Rich5252/Arduino_ESP32_ssb_signal_generator/null_bias_investigation.md

# Two-tone null-crossing frequency bias — investigation notes

**Status: characterized, NOT fixed. Parked 2026-08-31** — picking up the TF
(transfer function) measurement system and group-delay re-tuning first. See
"Where to resume" at the bottom. **Late addition, same day: user reports the
current `I` (x4 envelope interpolation) algorithm makes two-tone stability
audibly worse, not just subtly worse — see item 5 under "Open, un-actioned
next steps" below. Treat that as higher priority than the null-bias fix
itself when this is picked back up.**

**UPDATE 2026-09-09 — important caveat on `weighted_bias`, discovered while
chasing an unrelated random-frequency-jump symptom (see
`moving_forward_notes.md`):** `weighted_bias` was assumed to be a fast,
stable, per-tone-pair constant (reset with `'r'`, read a second or two
later). Live-watching it continuously (a new firmware change exempts the
`null_bias*` lines from the diagnostics mute, so they stream at 1Hz
regardless of `'v'`) on 700/1700Hz showed instead that after an `'r'` reset
it keeps drifting for TENS OF SECONDS TO MINUTES — not settling quickly —
and can wander by 10-30Hz over that time even with the tone pair, presets,
and hardware completely unchanged (one capture went from -34Hz shortly
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
