Rich5252/Arduino_ESP32_ssb_signal_generator/Design data/group_delay_equalizer_fit.png

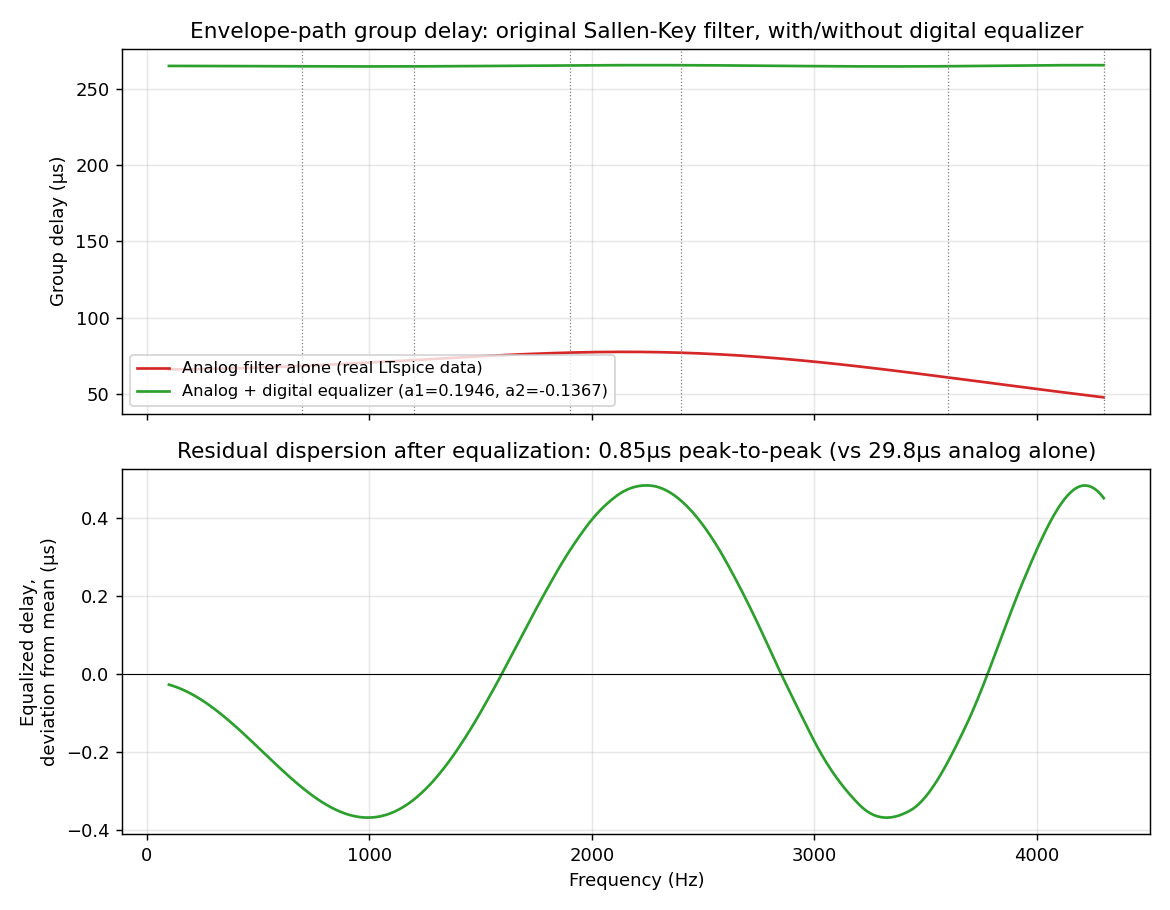
Design data/group_delay_equalizer_fit.png
