Rich5252/Arduino_ESP32_ssb_signal_generator/Design data/shelf2_level_dependence.png

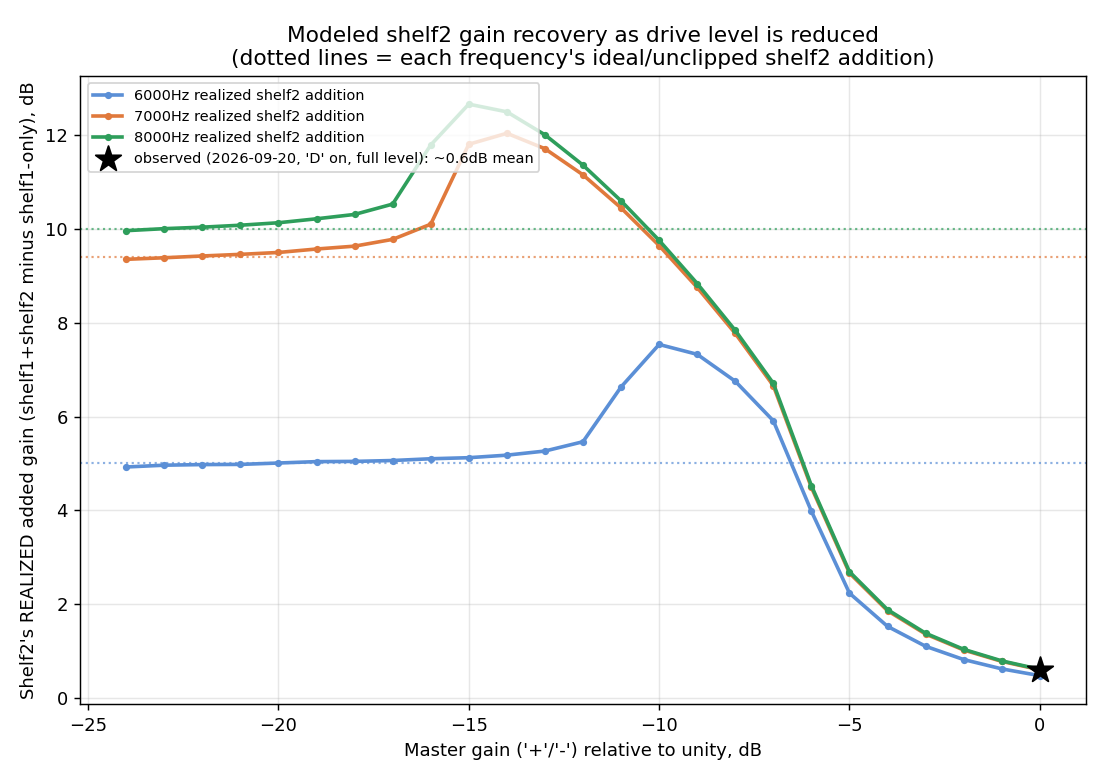
Design data/shelf2_level_dependence.png
