Rich5252/Arduino_ESP32_ssb_signal_generator/Design data/shelf_clipping_hypothesis.png

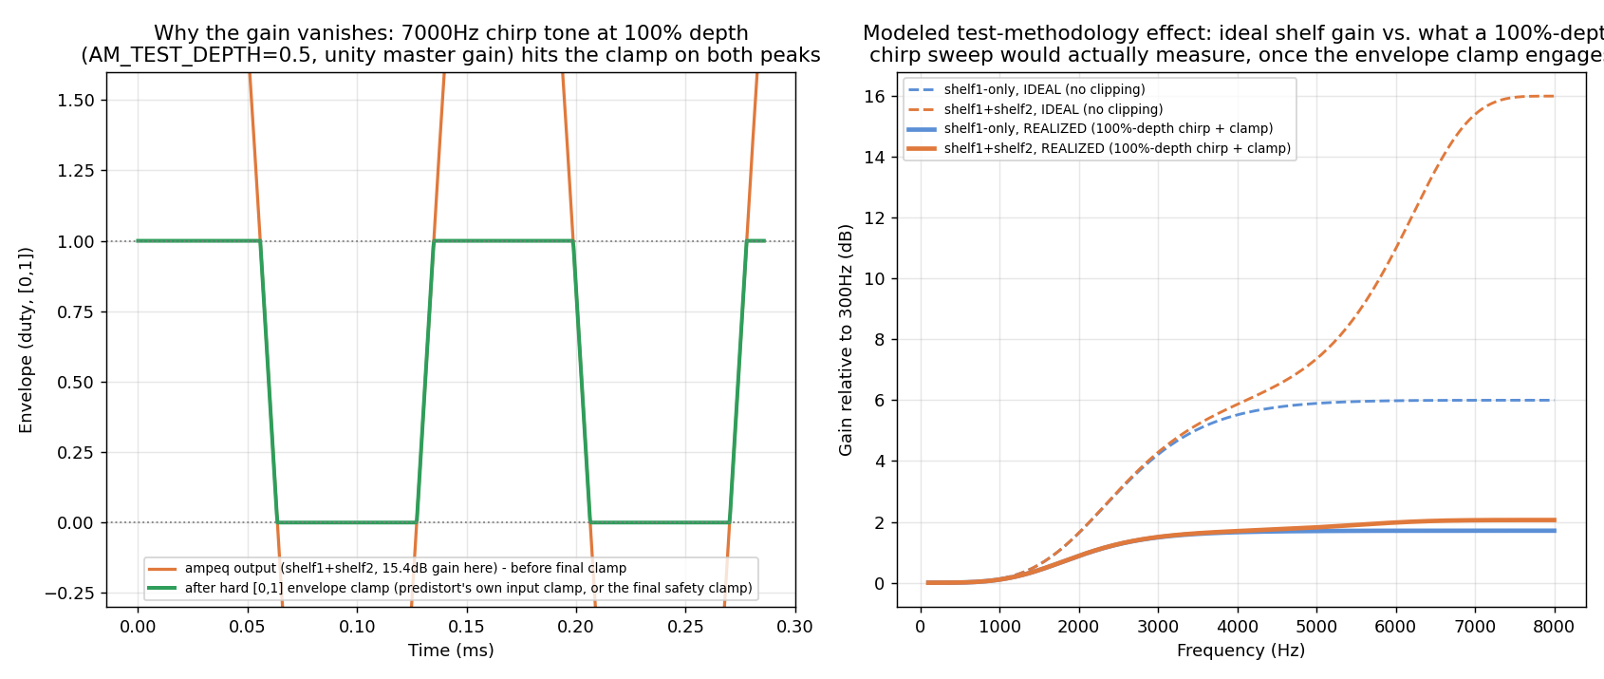
Design data/shelf_clipping_hypothesis.png
