Rich5252/Arduino_ESP32_ssb_signal_generator/Design data/ssb_mic_test_commands.md

# ssb_mic_test.ino — Serial Command Reference

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

## Signal source

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

### Sine-chirp test mode (`w`, `AUDIO_SRC_CHIRP`)

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

## Phase/envelope relative timing

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

## PWM duty-cycle range (envelope → RSET mapping)

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

## Envelope group-delay equalizer

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

## Envelope magnitude (insertion-loss) equalizer

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

## Is `eq`'s IMD benefit the highpass or the presence boost?

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

## Envelope pre-distortion

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

## Direct duty override

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

## Envelope-null floor

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

**Two earlier versions were tried and removed** — see `envelope_floor.cpp`'s header comment for both postmortems:

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

## freq_dev slew-rate limiter

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

## Envelope output interpolation

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

## Sample rate (Fs) and dsp_task timing margin

**2026-09-02: reverting `SAMPLE_RATE_HZ` from 16000 to 10000 produced a dramatic, across-the-board improvement — bigger than anything `g`/`I`/`D` have shown so far, and it looks like the real explanation behind most of this session's noisier-than-expected real-hardware results.** Using Preset 1 (two-tone, `env_gdeq_enable`/`envelope_interp_enable` both off) and a mid-band noise test (0-3kHz broadband content relative to a 750Hz mid-band reference): at 16000Hz, -22dBc, and `D` (`env_predistort_enable`) made it 0.3dB *worse*. At 10000Hz: -32dBc with `D` off (a 10dB improvement from Fs alone) and -38dBc with `D` on (`D` now worth a genuine +6dB, instead of being net-negative). Frequency stability and the tone's subjective quality were both reported as noticeably better at 10kHz too. The tradeoff is real and expected: PWM/ZOH imaging is worse at 10kHz (closer first image, less filter stopband margin) — the whole reason `SAMPLE_RATE_HZ` was raised to 16000 and `envelope_interp`'s x4 output interpolation was built in the first place.

Why this is very likely a genuine timing-margin story, not a coincidence: `config.h`'s own `SAMPLE_RATE_HZ` comment already has the numbers. At 10000Hz (100us period), measured per-tick work (adc+dsp+write) was ~45us, leaving ~55us of margin — comfortably above the "~12-20us of wakeup jitter already measured" noted in that same comment. At 16000Hz (62.5us period), that same ~45us of work leaves only ~17.5us of margin — barely above that *same* 12-20us jitter figure, i.e. close to the exact threshold that got 20000Hz rejected outright in that comment ("period drops to 50us, leaving too little margin"). 16000 was picked as "the next value up from 10000 that still divides evenly," not because its margin was independently re-validated as generous — and on this data it wasn't. A tick that occasionally misses that ~17.5us window delays the next AD9851 frequency-word update, which is real, direct FM/PM timing jitter on the signal itself — a mechanism that would show up exactly as elevated broadband noise and worse frequency stability, and wouldn't touch `D`'s effectiveness directly (a static envelope-to-duty LUT correction has nothing to do with tick timing) except by being swamped underneath it, which is exactly the pattern seen (`D`'s benefit reappears once the swamping noise is gone at 10kHz).

**2026-09-02, `[timing]` captures at both rates (Preset 1, TWO-TONE, `I`/`g` off, `'r'` reset first):** at 16000Hz, `max_busy_us=46 (adc=4 dsp=20 write=28) period_us=62 overruns=0`, `max_gap_us=75 (nominal=62) late_ticks_total=0`. At 10000Hz, `max_busy_us=42 (adc=5 dsp=16 write=24) period_us=100 overruns=0`, `max_gap_us=107 (nominal=100) late_ticks_total=0`. Neither shows a formal overrun or late tick, so the strong "dsp_task is missing its deadline" framing isn't directly confirmed — but the margin actually available is: 16us at 16kHz vs 58us at 10kHz (matching the config.h estimate almost exactly), and the worst observed wake-gap excess eats ~80% of that margin at 16kHz (13us of 16us) vs only ~12% at 10kHz (7us of 58us). 16kHz is running close to its own edge even when nothing formally trips the overrun counter; 10kHz has a large cushion. Also notable: `[dsp] freq_dev: max_unclamped` dropped from 6697Hz (16kHz) to 3697Hz (10kHz) — consistent with `diagnostics.cpp` computing instantaneous frequency as `dphi * SAMPLE_RATE_HZ / (2*pi)`, meaning any *fixed* amount of phase-domain noise (quantization, ADC noise, Hilbert/atan2 rounding) gets scaled up proportionally by Fs before it ever reaches the AD9851 — a second, smooth, deterministic mechanism independent of scheduling jitter, plausibly worth a few dB on its own via FM-sideband scaling (~20*log10(16000/10000) ≈ 4dB).

**2026-09-02, `ENVELOPE_INTERP_FACTOR=7` at `SAMPLE_RATE_HZ=10000` — retracted, wrong fix for the wrong reason.** The idea (see the now-superseded item 4 this replaces) was to decouple the heavy pipeline's rate from the PWM output rate: keep the full pipeline at 10kHz for margin, but raise the interp factor so the envelope's PWM write rate could still reach ~70kHz for imaging. On the bench this brought the noise straight back to the same poor level as plain 16kHz. That result on its own looked like it might mean *wake rate itself* (not the full pipeline's Fs) was the real culprit — but a cleaner, fully-controlled follow-up test at a *fixed* wake rate ruled that out too, and points somewhere much more specific and useful:

**2026-09-02, decisive: it's not wake rate, it's floating-point ramp computation on the interp tick.** All four readings below are at the *same* wake rate — `SAMPLE_RATE_HZ=10000`, `ENVELOPE_INTERP_FACTOR=4` (40kHz), Preset 1, `D` on, mid-band noise test (`Pwr mid 750Hz band`, higher/less-negative = worse):

| Curve | Result | Δ from baseline |
|---|---|---|
| `I` off (baseline) | -35.4dB | — |
| `I` on, HOLD (no float math, frozen value) | -33.4dB | +2.0dB |
| `I` on, LINEAR (one multiply-add, changing value) | -23.9dB | +11.5dB |
| `I` on, Catmull-Rom (cubic Hermite, changing value) | -21.2dB | +14.2dB |

LINEAR sits far closer to Catmull-Rom (2.7dB apart) than to HOLD (9.6dB apart), despite being the much simpler of the two real curves — a single multiply-add vs a full cubic Hermite evaluation. That rules out "more arithmetic = proportionally worse": if raw operation count were the driver, LINEAR should land roughly midway between HOLD and Catmull-Rom, not almost co-located with the expensive one. What actually separates HOLD from both real curves is binary, not a matter of degree: HOLD never touches the FPU and always (re)writes the exact same frozen duty value; LINEAR and Catmull-Rom both do real floating-point work and genuinely change the commanded duty on every interp tick. Whichever of those two properties is the trigger, it looks like a step function at that threshold, not a smooth cost curve.

**Correction, 2026-09-02 (same day): the `ENVELOPE_INTERP_FACTOR=7` result is a SEPARATE bug, not the same mechanism as the table above.** Re-tested with `I` fully OFF at factor=7 (10000Hz base) — still -21.174dB, essentially identical to the factor=4 Catmull-Rom result (-21.181dB) despite the interp tick being a guaranteed no-op with `I` off. That rules out float-ramp cost or a changing duty value as the cause at factor=7 specifically, since neither happens with `I` off. The real cause: `init_sample_timer()` sets `resolution_hz = 2000000UL * ENVELOPE_INTERP_FACTOR` — 8MHz at factor=4, 14MHz at factor=7 — while `alarm_count` stays a fixed `2000000UL / SAMPLE_RATE_HZ` (200), computed assuming the requested resolution is achieved exactly. `GPTIMER_CLK_SRC_DEFAULT` on this chip is the 80MHz APB clock (same assumption this project's own LEDC comment already makes elsewhere). 80MHz/8MHz=10 is a clean integer prescaler; 80MHz/14MHz≈5.714 is not, so the driver silently rounds to the nearest achievable resolution — almost certainly 80MHz/5=16MHz (a +14.3% error), not the requested 14MHz. Confirmed directly: `[dsp] long-window avg=11371.71 ticks/s (13.717% vs nominal 10000Hz) true_ratio=7.0914 (nominal=8)` — a real, hardware-timestamped measurement (via `esp_timer_get_time()`, independent of the gptimer's own assumptions) showing dsp_task's actual full-tick rate running ~13.7% fast, matching the predicted +14.3% resolution error closely enough (small residual plausibly the ADC's own independent +0.8% clock error, plus measurement-window noise) to call this confirmed. At factor=4, this same diagnostic line has consistently read ~0.000-0.008% off nominal — 8MHz's clean divisor avoids the problem entirely.

Consequence: at factor=7, *everything* downstream of `SAMPLE_RATE_HZ` — the Hilbert/atan2 phase-to-frequency conversion (`dphi * SAMPLE_RATE_HZ / 2*pi`), the AD9851 write cadence, the ADC decimation ratio (`ADC_SAMPLES_PER_TICK` assumes an exact 80000/10000=8 relationship, and the diagnostic's own `true_ratio=7.09 (nominal=8)` shows that assumption is now wrong too) — is being computed against a `SAMPLE_RATE_HZ` constant that no longer matches the tick rate actually being delivered. That's a severe, systematic mistuning of the whole pipeline, entirely independent of `I`/curve choice, which is exactly why it showed up "even with `I` off." This has nothing to do with the HOLD/LINEAR/Catmull-Rom finding above — that one was cleanly demonstrated entirely at factor=4, a clock-clean rate, so it remains a real, separate, still-open question.

Two consequences for next steps: **(1)** the previously-proposed "factor=7 + HOLD" isolating test (see below) is now moot as a clean test of the compute-cost question, since factor=7 itself is broken for an unrelated reason — any result there would be confounded by this clock error, not informative about float-ramp cost. **(2)** if a higher PWM update rate than 40kHz is still wanted at `SAMPLE_RATE_HZ=10000`, pick a factor that divides cleanly: `80,000,000 / (2,000,000 * factor)` needs to be an integer, i.e. `40 / factor` needs to be a whole number — factor ∈ {1, 2, 4, 5, 8, 10, 20, 40} are clean (7 wasn't one of them), so factor=5 (50kHz) or factor=8 (80kHz) would be genuinely clock-accurate choices worth trying instead, once/if the separate compute-cost question below is resolved in a way that makes a higher factor worth having. Also worth fixing at the code level regardless: `init_sample_timer()` should read back the gptimer driver's *actually achieved* resolution (ESP-IDF's `gptimer_new_timer()` reports this) and derive `alarm_count` from that instead of assuming the request was granted exactly — that would make any future `ENVELOPE_INTERP_FACTOR` choice safe by construction rather than silently wrong for the "unclean" ones.

Two candidate mechanisms remain for the still-open HOLD-vs-LINEAR/Catmull-Rom finding (factor=4, clock-clean, so unaffected by the above), not mutually exclusive, both consistent with a step-function-at-threshold pattern rather than a smooth compute-proportional one:
- **CPU/scheduling:** the ESP32-S3's FPU is a genuine coprocessor (this project already hit that wall once, in the v1/v2 `envelope_interp` failure history — see above). If the *first* FPU touch after a context switch carries a fixed save/restore cost, any float ramp (LINEAR or Catmull-Rom) would pay roughly the same large fixed penalty per call regardless of how many operations follow, while HOLD's FPU-free path never pays it at all — matching the data far better than a compute-proportional story would.
- **Analog/RF:** HOLD's duty value is electrically static across all 4 of its per-full-tick writes — indistinguishable from `I` off except for redundant identical LEDC writes. LINEAR/Catmull-Rom genuinely move the duty (real switching-edge position change) on every interp tick, which could carry inherently more RF-relevant switching energy regardless of CPU timing — a real, expected cost of genuine modulation rather than a bug, and independent of anything CPU-side. The GPIO2 scope check from the (retracted) HOLD investigation found the PWM line "clean" across all curves — but that check has not yet been repeated specifically under this two-tone/Preset 1 content with a properly *dynamic* envelope; a near-constant test signal would hide exactly this effect since LINEAR/Catmull-Rom's ramp would have little to interpolate either way.

Not yet done, in order of how cheap they are: (1) re-scope GPIO2 comparing HOLD vs LINEAR/Catmull-Rom under this exact two-tone/Preset 1 condition at factor=4 (clock-clean), to distinguish the CPU-side hypothesis (would show timing jitter on the PWM line) from the analog/RF-side one (would show a clean but genuinely more-modulated waveform); (2) a lightweight timing probe directly around `envelope_interp_on_interp_tick()`'s curve branches (max/avg execution time per call, broken out by curve), to quantify the CPU-side hypothesis directly instead of inferring it.

**2026-09-02, item (3) done — HOLD itself degrades with wake rate alone, even with zero float math (curve state assumed, pending confirmation).** Re-tested `SAMPLE_RATE_HZ=10000` with the two remaining clock-clean factors above 4, presumed still on HOLD (this was the specific next step proposed above; not explicitly re-stated in the terse result messages, so treat as provisional until confirmed):

| Factor | Wake rate | Result | Δ from `I` off baseline (-35.4dB) |
|---|---|---|---|
| 4 | 40kHz | -33.4dB (HOLD, confirmed) | +2.0dB |
| 5 | 50kHz | -29.929dB (HOLD, assumed) | +5.5dB |
| 8 | 80kHz | ~-23dB (HOLD, assumed) | +12.4dB |

If the curve assumption holds, this is a clean, roughly monotonic degradation with wake rate alone — 40k→50k→80k — on a payload that never touches the FPU and rewrites the same frozen duty value every interp tick. That's a real, independent cost of high wake rate by itself, additive on top of the separately-confirmed (and larger, at a fixed rate) float-ramp/changing-value cost from the table above. It also **weakens the CPU/FPU-coprocessor-context hypothesis**: that theory predicted HOLD's FPU-free path should be largely immune to wake-rate scaling, but here it isn't. The analog/RF hypothesis doesn't fit cleanly either, since HOLD's duty value is static — redundant identical writes, not genuine modulation — so a third, more generic mechanism looks more likely now: something that scales with *ISR/wake frequency itself*, independent of what work happens inside each wake (e.g. fixed per-interrupt overhead — vector entry/exit, LEDC register write timing relative to the 78125Hz LEDC carrier repeating more densely, digital switching noise from the wake activity itself). This needs the curve state confirmed, and ideally isolated from the earlier float-ramp finding with a dedicated HOLD-only rate sweep at 4/5/8 run back-to-back in one session, before it's treated as settled.

**Interim recommendation:** leave `I` off, and if `I` is used, prefer the lowest clock-clean factor that gives useful imaging (4, i.e. 40kHz) rather than reaching for 5 or 8 to chase a higher PWM rate — both the float-ramp cost (fixed rate) and, provisionally, the wake-rate-alone cost (HOLD) get worse as factor increases, so there's no free lunch in going higher. At the most comfortably-margined case measured (`I` off, 40kHz-equivalent wake, 58us of headroom, zero overruns), `I` on still costs ~10-14dB even in its cheapest (HOLD, factor=4) form — an order of magnitude bigger than the "+36dB for free" imaging benefit it was built to capture ever needed to be weighed against, and bigger than any of `g`/`D`'s effects measured this session. Until the mechanism above is pinned down (and fixed, if it's addressable), `I` isn't paying for itself on this hardware.

## GPIO13 5kHz pulse — confirmed source: the ADC continuous driver

**2026-09-02, reported:** a regular short pulse on GPIO13 (`CHIRP_REF_GPIO`) at exactly 5kHz while in `'w'` (sine-chirp) test mode.

**2026-09-02, ruled out — not a software pin conflict.** GPIO13 is shared three ways in this codebase: `TIMING_DEBUG_GPIO_ADC` (adc_capture.cpp's ISR debug toggle, gated `ADC_ISR_DEBUG_PIN_ENABLED=0`), `TIMING_DEBUG_GPIO_CMD` (the `.ino`'s serial-activity marker, gated `CMD_DEBUG_PIN_ENABLED=0`), and `CHIRP_REF_GPIO` (the chirp mode's own intended square-wave reference output, unconditional). Checked every `#if` site touching this pin in `adc_capture.cpp` and the `.ino`: both debug-toggle paths are confirmed fully compiled out (single, unambiguous `#define`s, no override elsewhere in the project) — genuinely absent from the binary, not just runtime-disabled. So nothing in this project's own code was deliberately writing pin13 outside of the chirp reference toggle itself.

**2026-09-02, root cause identified: exact rate match to the ADC continuous driver's ISR.** `ADC_CONT_SAMPLE_FREQ_HZ / ADC_CONT_FRAME_SAMPLES = 80000 / 16 = 5000Hz` — precisely `adc_conv_done_cb()`'s own DMA-frame-completion firing rate (adc_capture.cpp), which runs continuously in every audio-source mode, chirp included, because `adc_capture_init()` is called unconditionally in `setup()` ("Always started now, regardless of the initial audio source"). Working theory: electrical coupling from the ADC continuous driver's real DMA/ISR activity onto the GPIO13 pad, independent of any code write to that specific pin — consistent with this project's own earlier, opposite-direction finding that driving GPIO3 digitally silently zeroed ADC conversions outright (config.h's "TRIED GPIO3 FIRST, REVERTED" note), which already established that GPIO1-10's digital activity and the ADC1 front-end aren't cleanly isolated on this chip. GPIO13 was deliberately chosen as ADC2 (unused by this project) specifically to get away from that — this suggests the isolation doesn't fully hold in the reverse direction either, plausibly because ADC1/ADC2 share analog reference/bias circuitry inside the SAR ADC block despite being logically separate units.

**2026-09-02, added `ADC_CAPTURE_ENABLED` (config.h, defaults to 1, no behavior change) as an isolation test.** Guards all three real call sites in the `.ino`: `adc_capture_init()` in `setup()` (skips starting the driver entirely — `adc_continuous_start()` is never called and the ISR never registers, not just a muted debug pin), `adc_capture_service()` in `loop()`, and the mic-source sample read in `dsp_task` (falls back to `sample = 0.0f`, matching the existing AMTEST/FMTEST/ENVSTEP "unused" convention). `diagnostics.cpp`/`serial_commands.cpp`'s ADC accessor calls were left unguarded — they only touch static state inside `adc_capture.cpp` and are safe to call with the driver never started (report zeros).

**2026-09-02, confirmed on real hardware: `ADC_CAPTURE_ENABLED=0` kills the 5kHz pulse on GPIO13.** Decisive — the ADC continuous driver's DMA/ISR activity is the source, not the chirp reference code, not a residual debug-pin write.

**Implication worth testing next:** the ADC continuous driver has been running at this same 5kHz ISR rate, unconditionally, through *every* mid-band noise measurement so far this session (two-tone mode included — the mic FIFO isn't drained in that mode, but the driver and its ISR are still live per the "Always started now" comment above). If this same coupling mechanism reaches the analog envelope/RF path the way it reaches GPIO13, it could be a constant background contributor sitting underneath the whole HOLD/LINEAR/Catmull-Rom and factor 4/5/8 noise-floor investigation above — present equally in every condition tested, so it wouldn't explain the *differences* between them, but it could explain part of why even the best `I`-off baseline (-35.4dB) isn't lower. Worth a quick check: rerun the mid-band noise test (Preset 1, `I` off, `D` on, two-tone) with `ADC_CAPTURE_ENABLED=0` and compare against the existing -35.4dB baseline — a rise (less-negative, quieter) would indicate the ADC driver is also coupling into the RF path itself, not just the digital GPIO13 line.

**2026-09-02, pin catalog and root-cause reclassification: this is a general ADC-pin-class problem on this board, not a GPIO13-specific one.** Cataloging every pin actually in use (`config.h`/`carrier_output.h`/`envelope_output.h`) against the S3's ADC1 (GPIO1-10) / ADC2 (GPIO11-20) channel map: GPIO2/4/5/6 (RSET PWM, the two timing-debug pins, mic) are ADC1; GPIO9/10 (`AD9851_PIN_RESET`/`_DATA`) are ADC1; GPIO11/12 (`AD9851_PIN_FQUD`/`_WCLK`) are ADC2; GPIO13 was ADC2. Every free pin on the board's main 1-13 header (1, 3, 7, 8) is also ADC1 — there is no non-ADC pin available there at all. Between GPIO3 (driving it digitally zeroed ADC1 conversions outright) and GPIO13 (receiving coupling from the ADC driver's own DMA/ISR activity), this project has now found real-hardware evidence of trouble in *both directions* across *both* ADC units on this chip — confirming Espressif's own guidance (ADC-183 errata: ADC2's digital/DMA controller is documented as unreliable; hardware design guidelines state "ADC1 is recommended for use") without needing to trust it blindly, since both directions are now independently reproduced on this exact board.

Flagged, not yet tested: **GPIO9-12 (the AD9851 bit-bang interface) are the strongest untested candidate for this same class of problem**, arguably more than GPIO13 ever was — they sit on both ADC units (9/10=ADC1, same unit as the mic; 11/12=ADC2), and unlike GPIO13's low-duty-cycle debug/reference role, they're the busiest digital lines on the whole board: DATA/WCLK/FQUD/RESET all bit-bang every full tick, already documented as the single largest `[timing]` line item (~24-28µs). Two distinct risk paths: (1) the same ADC-driver-coupling direction as GPIO13, but onto GPIO9/10 specifically — though this wouldn't reach the RF output in two-tone/chirp mode since those modes never read the ADC FIFO for signal content; (2) direct board-level crosstalk from these fast lines onto the nearby analog envelope/PWM output (GPIO2) or mic input (GPIO6), which doesn't go through the ADC's digital pipeline at all and would be live in *every* mode, RF-relevant regardless of test source. Not rewired — these are point-to-point wired to the physical AD9851 module, a materially bigger change than swapping a debug pin, so this needs bench evidence (scope GPIO6 grounded, or the GPIO2 PWM line, alongside AD9851's WCLK/DATA for an edge-correlated glitch) before it's worth disturbing a working interface.

**2026-09-02, moved `TIMING_DEBUG_GPIO_ADC`/`TIMING_DEBUG_GPIO_CMD`/`CHIRP_REF_GPIO` from GPIO13 to GPIO39.** Board is an ESP32-S3 Super Mini: GPIO1-13 on the main header (all ADC-associated, per the catalog above), GPIO39-48 reachable via small solder pads. Within that pad range, GPIO43/44 are the UART0 console (reassigning discouraged), GPIO45/46 are two of the S3's four strapping pins, GPIO47/48 are already wired to the I2C DAC (`MCP4725_SDA`/`SCL_GPIO`) — leaving GPIO39-42 (default hardware JTAG TCK/TDO/TDI/TMS, unused and safe to repurpose since this project debugs over USB CDC serial, not external JTAG). Picked GPIO39. No ADC channel on the S3, not a strapping pin, not the console UART, not already claimed — the first debug/reference pin on this board with no ADC association at all. Code updated (`config.h`, `ssb_mic_test.ino`, `adc_capture.cpp`, `serial_commands.cpp`, `settings.h`, `test_signals.h`) to match; not yet re-verified on the bench that GPIO39 is itself clean (should scope it the same way GPIO13 was scoped, now that it's carrying the chirp reference again).

**2026-09-02, reported and root-caused: GPIO39 read permanently LOW.** Real bug, not a wiring/board issue — `GPIO.out_w1ts`/`out_w1tc` (used at every raw-register toggle site in `adc_capture.cpp` and the `.ino`, chosen specifically for their ISR-safety/zero function-call-overhead) are only 32 bits wide and physically address GPIO0-31 only. `1UL << 39` doesn't hit a real bit in that register at all, so `GPIO.out_w1ts = (1UL << CHIRP_REF_GPIO)` for pin 39 was silently a no-op — not undefined/crashing, just quietly doing nothing, leaving the pin stuck at whatever `pinMode`/`digitalWrite(...LOW)` left it during `setup()` (that init call goes through Arduino's `digitalWrite()`, which *does* handle GPIO32+ correctly - only the hot-path raw-register toggles were broken). This was invisible with the pin at GPIO13 (<32, correct register) and only surfaced once the pin moved to GPIO39 (>=32) - a latent bug the GPIO13→GPIO39 move exposed rather than one it introduced.

**Fix:** added `GPIO_FAST_SET(pin)`/`GPIO_FAST_CLR(pin)` macros (`config.h`, right after `TIMING_DEBUG_GPIO_ISR`'s definition) that branch between `GPIO.out_w1ts/w1tc` (pin < 32) and `GPIO.out1_w1ts/out1_w1tc` at bit `(pin-32)` (pin >= 32) - the S3's second GPIO bank, needed for anything past GPIO31. Since every pin argument here is a `#define` constant, the branch folds away entirely at compile time (zero runtime cost, still IRAM/ISR-safe) - this can't silently break again the next time a debug/reference pin gets reassigned to something >=32. Replaced all three real call sites: `on_timer_alarm()`'s pin5 toggle (didn't need the fix, converted anyway for consistency), the chirp reference toggle (the one that was actually broken), and `adc_conv_done_cb()`'s pin toggle (currently compiled out via `ADC_ISR_DEBUG_PIN_ENABLED=0`, but fixed for correctness whenever it's re-enabled next).

**2026-09-02, build failure on first attempt: `GPIO.out1_w1ts`/`out1_w1tc` are anonymous unions, not plain integers, on this SDK (`esp32s3-libs 3.3.8`).** Real compiler error: `no match for 'operator=' (operand types are 'volatile gpio_dev_s::<unnamed union>' and 'long unsigned int')`, on both branches, even for the pin5 call site that never actually takes the `>=32` path at runtime - because both branches of the `if`/`else` still have to type-check at compile time regardless of which one a constant pin number folds to. `GPIO.out_w1ts`/`out_w1tc` (low bank) accept a bare assignment fine on this SDK (already proven, left untouched); `GPIO.out1_w1ts`/`out1_w1tc` (high bank) need the union's `.val` member - `GPIO.out1_w1ts.val = mask` instead of `GPIO.out1_w1ts = mask`. Fixed and left a comment explaining why the two banks are treated differently in the same macro, so it doesn't look like an inconsistency to a future reader.

## Audio processing

| Key | Effect |
|---|---|
| `e` | Toggle EQ (HPF + presence peak) on/off |
| `c` | Toggle compressor on/off (automatic makeup gain applied) |
| `+` | Master gain +1.0dB |
| `-` | Master gain -1.0dB |
| `.` | Master gain +0.1dB (fine step) |
| `,` | Master gain -0.1dB (fine step) |

Master gain scales the *whole* chain (phase + envelope together, inside `ssb_dsp`) — different from the PWM range knobs above, which only touch envelope. `.`/`,` give 0.1dB resolution for dialing in precise gain-sweep measurement points (e.g. re-measuring `envelope_predistort.h`'s calibration table at finer steps) without 10 presses of `+`/`-` per dB.

## RF output

| Key | Effect |
|---|---|
| `o` | Toggle AD9851 RF output on/off (clean power-down via the chip's own control bit — preserves last-set frequency) |

## ADC / diagnostics

| Key | Effect |
|---|---|
| `f` | Cycle the ADC anti-alias low-pass filter: off → Butterworth → Chebyshev → off. Both are 4th-order (two cascaded biquads), same 3kHz -3dB point; Chebyshev trades a small in-band ripple (~1.4dB) for noticeably more stopband rejection above cutoff — see `adc_capture.h`/`ssb_adc_filter.h`. For A/B testing whether an artifact comes from the filter, and which filter family/order helps most |
| `v` | Mute/unmute the once-per-second `[timing]`/`[adc]`/`[dsp]` diagnostic block — mute this before adjusting other settings if you want to actually see the confirmation lines |
| `r` | Reset all diagnostic counters/watermarks for a clean measurement window (doesn't touch any of the settings above, only the stats) |
| `n` | Cycle the null-bias diagnostic's near-null envelope threshold through `{0.02, 0.05, 0.10, 0.20}` (starts at 0.05) — see the section below |

### Null-crossing frequency bias diagnostic (`[dsp] null_bias*`)

Added 2026-08-31 while chasing a two-tone "poor tone"/slow-drift/FM-noise complaint. Full derivation, method, and the confirmed measurement table live in **`null_bias_investigation.md`** — short version: `wrap_pi()`'s resolution of the ±π phase jump at each two-tone envelope null carries a small, deterministic, tone-pair-specific bias, and it's now measurable directly from firmware, no SDR needed.

Three lines print alongside `[dsp] freq_dev`, same ~1s cadence, gated the same way:

| Line | Fields | Use |
|---|---|---|
| `null_bias` | `f1`, `f2`, `expected_center` (`(f1+f2)/2`), `plain_mean`, `plain_bias` | `plain_bias` is a plain unweighted average — **confirmed wrong**, overstates the real effect by 2-3 orders of magnitude (100s of Hz vs. the real few-to-tens-of-Hz effect). Kept only for the mechanistic breakdown in `null_bias3`. |
| `null_bias2` | `weighted_mean`, `weighted_bias` | **The one that matches reality.** Envelope²-weighted average instantaneous frequency — the physically correct quantity (equals the power spectrum's centroid, a standard identity), confirmed against the SDR to within a few Hz across all six `TWOTONE_BAND_PRESETS` pairs. |
| `null_bias3` | `near_null_samples%`, `near_null_contrib`, `rest`, `threshold` | Diagnostic-only: how much of `plain_bias` comes from the small fraction of samples sitting right at a null (`envelope < threshold`) vs. everywhere else. Confirms the effect is localized to null crossings. |

Workflow to reproduce a reading: `T` to a tone-pair preset, confirm `e`/`c` (EQ/compressor) are off, confirm threshold reads 0.050 (press `n` to cycle back if not), `r`, wait ~1-2s, read the three lines. Counters reset via `ssb_dsp_reset_freq_dev_stats()` — same call `r` already makes, alongside `[dsp] freq_dev`'s `max_unclamped`/`clip_count`.

## Presets

| Key | Effect |
|---|---|
| `0`-`9` | Load a preset from `settings.h` — sets every lever above (audio source, relative delay, PWM offset/scale, gdeq, ADC LPF mode, EQ, compressor, master gain, RF output, envelope pre-distortion, envelope-null floor, freq_dev slew-rate limit, envelope output interpolation, interpolation curve) in one command. Boot banner lists the current names (dynamically, from the array's own size — always up to date). |
| `P` | Print the current value of every one of those same levers as a single comma-separated line, wrapped in `{ ... },` and in exactly `PersistentSettings`'s field order — copy/paste it straight into the `settingsPresets[]` array in `settings.h` as a new preset. Rename the placeholder `"Live"` name (and add a numbered comment above it, matching the existing presets' style) after pasting. |

Edit the `settingsPresets` array in `settings.h` to change them, or dial in levers live and use `P` to generate the line instead of hand-typing values — check the live boot banner or `settings.h` itself for the current name/count rather than this doc, since the preset list changes often during active tuning. There's a compile-time check tying the array size to the `'0'`-`'9'` range (`settings.h`'s `static_assert`), so resizing it without updating `loop()`/`setup()`/`serial_commands.cpp`'s preset-select block — and the boot banner's own preset listing loop, which now reads the array size directly rather than a hardcoded count — fails the build instead of silently misbehaving.

## Current testing defaults (compiled in, before any preset is loaded)

- Two-tone mode on at boot
- EQ and compressor both off
- Master gain: -2dB
- Relative delay: 0 samples
- Envelope group-delay equalizer: off
- `MAX_FREQ_DEV_HZ`: 8000Hz. Originally raised from 2800Hz just to measure the real unclamped two-tone peak deviation (`[dsp] max_unclamped`, see `diagnostics.cpp`) while chasing a ~+100Hz two-tone frequency offset; that measurement came back ~4800-4900Hz — well above the old 2800Hz ceiling, meaning that clamp was routinely engaging on real signal peaks, not just as an edge-case safety limit. Separately, real-hardware mic white-noise testing showed the freq-dev clamp performs better set higher, so **8000Hz is being kept for now** rather than reverted to 2800Hz — not yet landed on a final permanent value. UPDATE 2026-08-31: `clip_count` reads 0 at every tone-pair/spacing tested at this clamp setting, which rules clamp-asymmetry out as the cause of the (much smaller, current-firmware) two-tone offset seen now — see `null_bias_investigation.md` for the mechanism that replaced this as the leading explanation.

## Quick workflow reminders

- Send `v` first if you're about to do fine-tuning — otherwise confirmations get buried in the 1-second diagnostic spam.
- Levels take a moment to settle on the spectrum analyzer after any change — wait before reading.
- `[timing]` line's `mode=` field tells you which signal source is actually active (goes through the same name mapping used for `t`/`s`/`p`/`y`/`h`'s own confirmation lines, so `ENVSTEP`/`FM TEST`/`AM TEST` show up correctly there too, not just `TWOTONE`/`SINGLETONE`/`mic`), and `gdeq=` tells you whether the group-delay equalizer was on during that measurement window.
- Recommended workflow for validating `g`: `p` (envelope step) with `g` off vs on, scope the RSET step edge directly — flatter group delay should show as a cleaner edge. Re-tune `[`/`]` (starting near +2.65 samples) before judging real two-tone/IMD results with `g` on. `h` (AM isolation) is also worth an occasional off/on `g` check, though as of 2026-09-07 it's no longer flagged as a priority — see that dated entry above for why (the asymmetric AM-to-PM signature this note used to warn about isn't currently reproducible).
- Empirically mapping envelope/phase delay mismatch vs. frequency (no lab equipment needed beyond the RF spectrum analyzer already in use): `T` to step to a band, `[`/`]` to find the delay that minimizes IMD/spurs for that band, capture a spectrum, repeat for the next `T` press. The resulting per-band "best delay" values trace out the actual (as-built) delay-vs-frequency curve, which can be fed back into refitting `ENV_GDEQ_A1`/`ENV_GDEQ_A2` against real measured data instead of the original LTspice simulation.
