Rich5252/Arduino_ESP32_ssb_signal_generator/mod160_isr_write_benchmark_spectrum.png

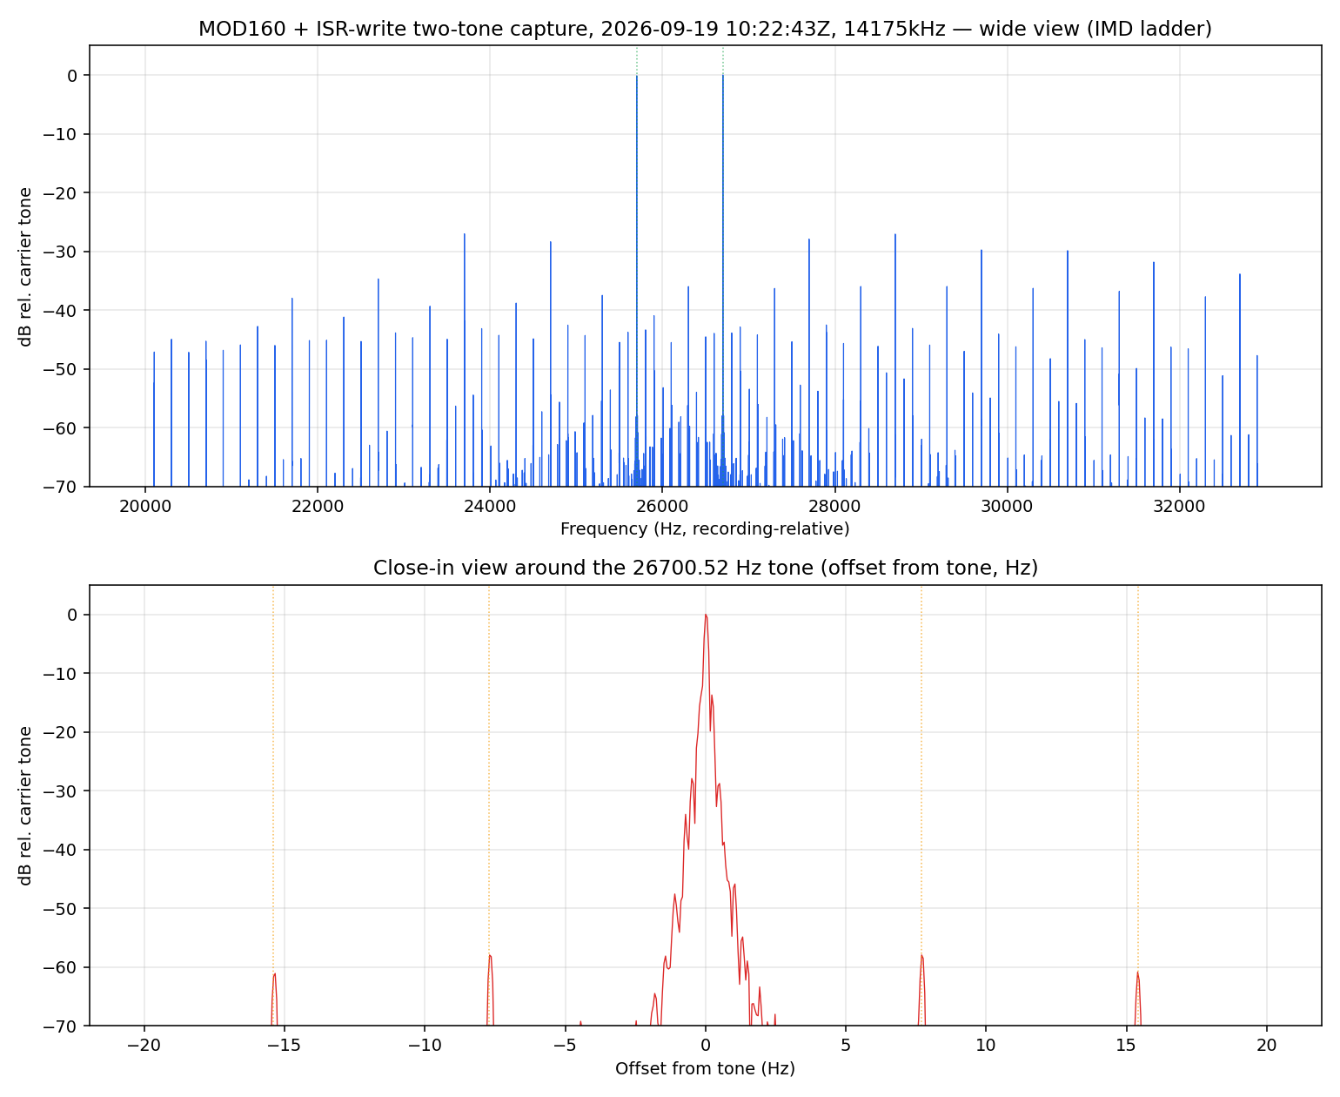
mod160_isr_write_benchmark_spectrum.png
