Rich5252/Arduino_ESP32_ssb_signal_generator/adc_capture.cpp

/**
 * adc_capture.cpp - see adc_capture.h.
 */

#include "adc_capture.h"
#include "config.h"
#include "ssb_adc_filter.h"
#include "freertos/FreeRTOS.h"
#include "freertos/task.h"
#include "esp_adc/adc_continuous.h"
#include "esp_timer.h"
#include "esp_rom_sys.h"
#include "soc/gpio_struct.h"   // GPIO.out_w1ts/w1tc - see adc_conv_done_cb()'s Fs jitter hunt toggle
#include <Arduino.h>
#include <math.h>   // isnan()/isinf() (via isfinite()) - see adc_capture_get_lpf_canary()

#define ADC_UNIT       ADC_UNIT_1
#define ADC_CHANNEL    ADC_CHANNEL_5   // GPIO6 on ESP32-S3 - Micr input

static adc_continuous_handle_t s_adc;

static volatile uint16_t s_adc_fifo[ADC_FIFO_SIZE];
static volatile uint32_t s_adc_fifo_head = 0;   // written only by adc_conv_done_cb (ISR)
static volatile uint32_t s_adc_fifo_tail = 0;   // written only by adc_capture_read_next_sample() (dsp_task)

// Two 4th-order float biquad cascades (ssb_biquad4_t - two cascaded
// 2nd-order stages each, see ssb_adc_filter.h), both always initialized -
// safe here since only ever called from dsp_task now, never from the ISR
// (which stays integer-only, see adc_conv_done_cb). Only one is actually
// used per sample, selected by s_adc_lpf_mode below; keeping both
// initialized means switching modes live never needs a re-init, only a
// state reset (see the mode-transition handling in
// adc_capture_set_lpf_mode()).
static ssb_biquad4_t s_adc_lpf_butterworth;
static ssb_biquad4_t s_adc_lpf_chebyshev;
// 2026-09-23: 6th/8th-order cascades (ssb_biquad6_t/ssb_biquad8_t - three/
// four cascaded 2nd-order stages, see ssb_adc_filter.h) added alongside
// the two 4th-order ones above, same "always initialized, only one
// actually processes samples" reasoning.
static ssb_biquad6_t s_adc_lpf_butterworth6;
static ssb_biquad6_t s_adc_lpf_chebyshev6;
static ssb_biquad8_t s_adc_lpf_butterworth8;
static ssb_biquad8_t s_adc_lpf_chebyshev8;

// Live OFF/Butterworth/Chebyshev toggle for the ADC LPF, via serial 'f' -
// see serial_commands.cpp. Lets you compare filtered-vs-raw (or one filter
// family vs the other) on the same physical signal without a rebuild, to
// check whether an artifact is actually coming from the filter or from
// somewhere else entirely.
static volatile adc_lpf_mode_t s_adc_lpf_mode = ADC_LPF_MODE_OFF;

// Continuity diagnostics: is the ADC stream actually gap-free at
// ADC_CONT_SAMPLE_FREQ_HZ, or are frames being dropped? The biquad's
// frequency response assumes uniform sample spacing - a stream with
// silent gaps isn't really "80kHz" even if most samples are on time.
// All ISR-incremented, plain integers, read/printed from loop() only
// (via adc_capture_get_diag()).
static volatile uint32_t s_dbg_adc_samples_total = 0;
static volatile uint32_t s_dbg_adc_callback_count = 0;
static volatile uint32_t s_dbg_adc_pool_ovf_count = 0;

// Does dsp_task ever find fewer than ADC_SAMPLES_PER_TICK samples waiting
// in the FIFO? The FIFO's capacity can't create lookahead - it only
// protects against overflow if dsp_task briefly lags. Whether a tick ever
// comes up short depends on the (fixed, boot-order-determined) phase
// between burst arrival and tick timing, not on FIFO size.
static volatile uint32_t s_dbg_adc_fifo_starve_count = 0;
static volatile uint32_t s_dbg_adc_fifo_min_available = 0xFFFFFFFFu;
static volatile uint32_t s_dbg_adc_fifo_max_available = 0;
static volatile uint32_t s_dbg_adc_fifo_drop_count = 0;
static int64_t s_adc_start_us = 0;

// ---- Fractional resampler state (see adc_capture_read_next_sample()'s
// own comment in adc_capture.h for the full design) - all task-context
// only, touched exclusively from adc_capture_read_next_sample() and
// adc_capture_reset_diag(), never from the ISR. ----
//
// 2026-09-20, BUGFIX: the original version of this block kept a single
// ever-growing `float s_virtual_pos`, incremented by s_true_ratio (~4-5)
// every dsp tick forever. float32 can only represent integers EXACTLY up
// to 2^24 (16,777,216) - at ~64,000-80,000 increments/sec (true_ratio x
// 16000 ticks/sec), that ceiling is reached in under 5 minutes of
// continuous mic-mode operation. Past it, each addition silently rounds
// to the nearest representable step (ULP doubling at every power-of-2
// magnitude boundary beyond that point), corrupting both the per-tick
// sample-count decision AND the interpolation fraction derived from it -
// a real, physically-guaranteed source of new timing jitter/distortion
// that gets WORSE the longer the board has been running, entirely
// separate from (and probably worse than) the original ADC-rate-mismatch
// artifact this resampler was built to fix. This is very likely what
// user testing reported as new "noise products/IMD" after the first cut
// of this code. Fixed by replacing the unbounded position with a BOUNDED
// [0,1) phase accumulator (s_phase, always small - see
// adc_capture_read_next_sample()) plus an exact-integer cumulative
// target (s_resample_target_cumulative, uint32_t - integer accumulation
// never loses precision short of a ~16.5-hour wraparound, which unsigned
// arithmetic handles correctly via modular subtraction). Mathematically
// equivalent to the original design's intent, verified by hand (floor/
// frac decomposition telescopes correctly - see null_bias_investigation.md's
// 2026-09-20 entry for the derivation) - just computed without ever
// storing a large accumulating float.
static float    s_true_ratio          = (float)ADC_SAMPLES_PER_TICK;  // calibrated Fs_adc/Fs_dsp ratio; seeded nominal until first window completes
static bool     s_ratio_calibrated    = false;
static uint32_t s_ratio_calib_start_samples = 0;   // s_dbg_adc_samples_total snapshot at window start
static uint32_t s_ratio_calib_start_calls   = 0;   // s_resample_call_count snapshot at window start
static uint32_t s_resample_call_count = 0;         // total calls to adc_capture_read_next_sample()
static uint32_t s_resample_total_consumed = 0;     // total raw samples actually popped+filtered so far
#define ADC_RESAMPLE_LOOKAHEAD_SAMPLES 2u   // need both bracket samples already filtered to interpolate - see read_next_sample()
static uint32_t s_resample_target_cumulative = ADC_RESAMPLE_LOOKAHEAD_SAMPLES;  // exact-integer running target = floor(ideal position) + lookahead
static float    s_phase               = 0.0f;      // BOUNDED [0,1) fractional accumulator - never grows, precision-safe indefinitely
static float    s_filt_prev           = 2048.0f;   // filtered sample at the ideal floor position   - interpolation bracket
static float    s_filt_curr           = 2048.0f;   // filtered sample one raw sample ahead of it     - interpolation bracket

// adc_continuous's on_conv_done callback - ISR context, fires once per
// completed conversion frame. edata->conv_frame_buffer is a direct
// pointer into driver-owned memory (never free it) containing that
// frame's raw bytes. No adc_continuous_read() call here - the ESP-IDF
// docs are explicit that blocking driver calls don't belong in this
// callback; the pool still needs periodic draining, but that happens
// separately in adc_capture_service(), fully decoupled from this.
//
// Just pushes raw integers into the FIFO - no filtering happens here at
// all. adc_capture_read_next_sample() does the filtering, draining a
// fixed count per tick - see adc_capture.h for why this split is what
// actually solves both the noise and the timing issues.
static bool IRAM_ATTR adc_conv_done_cb(adc_continuous_handle_t handle,
                                        const adc_continuous_evt_data_t *edata,
                                        void *user_data)
{
#if TIMING_DEBUG_ENABLED && ADC_ISR_DEBUG_PIN_ENABLED
    // Fs jitter hunt - see config.h's TIMING_DEBUG_GPIO_ISR comment.
    // Scope this against TIMING_DEBUG_GPIO_ISR to test whether THIS ISR
    // (also Core 1, firing every ADC_CONT_FRAME_SAMPLES/
    // ADC_CONT_SAMPLE_FREQ_HZ) is the thing delaying gptimer's alarm ISR
    // from firing on time - i.e. ISR-to-ISR contention on Core 1.
    //
    // Falling edge here = true ISR entry instant, zero added latency -
    // this is the edge to trigger/measure jitter off. The matching
    // out_w1ts now sits at every return point below (see there) instead
    // of immediately after this line, so the LOW pulse width becomes
    // "however long this callback's own real work took" - free width for
    // a 100MHz scope to resolve, using time that was already being spent
    // here rather than adding any. Bonus: that width is itself a genuine
    // per-firing ISR-execution-time measurement.
    //
    // GATED OFF (ADC_ISR_DEBUG_PIN_ENABLED=0) while this pin (39, see
    // config.h's TIMING_DEBUG_GPIO_ADC comment) is temporarily
    // repurposed for the serial-activity-correlation test - see config.h's
    // ADC_ISR_DEBUG_PIN_ENABLED comment. This ISR must not touch the pin
    // while loop()'s command-window marker owns it, or the two would
    // corrupt each other on the wire.
    GPIO_FAST_CLR(TIMING_DEBUG_GPIO_ADC);
#endif

    uint32_t n = edata->size / SOC_ADC_DIGI_DATA_BYTES_PER_CONV;
    if (n == 0) {
#if TIMING_DEBUG_ENABLED && ADC_ISR_DEBUG_PIN_ENABLED
        GPIO_FAST_SET(TIMING_DEBUG_GPIO_ADC);   // close the pulse on this early-return path too
#endif
        return false;
    }
    if (n > ADC_CONT_FRAME_SAMPLES) n = ADC_CONT_FRAME_SAMPLES;   // defensive - shouldn't happen

    s_dbg_adc_callback_count++;
    s_dbg_adc_samples_total += n;

    uint32_t head = s_adc_fifo_head;
    for (uint32_t i = 0; i < n; i++) {
        adc_digi_output_data_t *p = (adc_digi_output_data_t *)
            (edata->conv_frame_buffer + i * SOC_ADC_DIGI_DATA_BYTES_PER_CONV);

        uint32_t next_head = (head + 1) & ADC_FIFO_MASK;
        if (next_head == s_adc_fifo_tail) {
            // FIFO full - dsp_task has fallen behind by more than
            // ADC_FIFO_SIZE samples (shouldn't happen at 4x headroom
            // over one burst unless something else is starving it).
            // Drop rather than overwrite unread data or block in an ISR.
            // Distinct from s_dbg_adc_pool_ovf_count - that's the
            // DRIVER's own internal buffer overflowing before we even
            // see the data; this is OUR software FIFO, further downstream.
            //
            // Counts every remaining sample in THIS frame as dropped
            // (n - i), not just +1 for the break - an earlier version
            // incremented by 1 per callback-that-hit-full, which
            // massively undercounted true loss whenever a full 16-sample
            // frame arrived against an already-full FIFO (up to 16 lost,
            // only 1 counted).
            s_dbg_adc_fifo_drop_count += (n - i);
            break;
        }
        s_adc_fifo[head] = (uint16_t)p->type2.data;
        head = next_head;
    }
    s_adc_fifo_head = head;
#if TIMING_DEBUG_ENABLED && ADC_ISR_DEBUG_PIN_ENABLED
    GPIO_FAST_SET(TIMING_DEBUG_GPIO_ADC);   // rising edge = this callback's real work is done
#endif
    return false;   // no higher-priority task needs waking from this event
}

// Fires if the underlying driver pool overflows - i.e. on_conv_done and/or
// the periodic drain in adc_capture_service() aren't keeping up, and
// conversion data is being lost. Integer-only, ISR-safe.
static bool IRAM_ATTR adc_pool_ovf_cb(adc_continuous_handle_t handle,
                                       const adc_continuous_evt_data_t *edata,
                                       void *user_data)
{
    s_dbg_adc_pool_ovf_count++;
    return false;
}

void adc_capture_init(void)
{
#if TIMING_DEBUG_ENABLED && ADC_ISR_DEBUG_PIN_ENABLED
    // Fs jitter hunt - see config.h's TIMING_DEBUG_GPIO_ISR comment and
    // adc_conv_done_cb()'s own toggle below. Set up here, before the
    // driver starts (end of this function), so the pin is a valid OUTPUT
    // before the ISR could possibly fire.
    //
    // GATED OFF (ADC_ISR_DEBUG_PIN_ENABLED=0) - this pin's own init now
    // happens in the .ino's setup() instead, as TIMING_DEBUG_GPIO_CMD -
    // see config.h's ADC_ISR_DEBUG_PIN_ENABLED comment.
    pinMode(TIMING_DEBUG_GPIO_ADC, OUTPUT);
    digitalWrite(TIMING_DEBUG_GPIO_ADC, LOW);
#endif

    adc_continuous_handle_cfg_t handle_cfg = {
        .max_store_buf_size = ADC_CONT_BUF_BYTES,
        .conv_frame_size = ADC_CONT_FRAME_BYTES,
    };
    ESP_ERROR_CHECK(adc_continuous_new_handle(&handle_cfg, &s_adc));

    adc_digi_pattern_config_t adc_pattern[1] = {
        {
            .atten = ADC_ATTEN_DB_12,
            .channel = ADC_CHANNEL,
            .unit = ADC_UNIT,
            .bit_width = ADC_BITWIDTH_12,
        },
    };
    adc_continuous_config_t dig_cfg = {
        .pattern_num = 1,
        .adc_pattern = adc_pattern,
        .sample_freq_hz = ADC_CONT_SAMPLE_FREQ_HZ,
        .conv_mode = ADC_CONV_SINGLE_UNIT_1,
        .format = ADC_DIGI_OUTPUT_FORMAT_TYPE2,   // S3 result format
    };
    ESP_ERROR_CHECK(adc_continuous_config(s_adc, &dig_cfg));

    // Must happen before dsp_task can possibly start draining the FIFO -
    // adc_capture_read_next_sample() calls ssb_biquad4_process() on
    // whichever filter is selected every tick once mic mode is active.
    // Both are initialized unconditionally regardless of the current mode,
    // so switching modes live (via 'f') never needs a re-init. Fine to
    // init here (task context, at startup).
    ssb_biquad4_lpf_init(&s_adc_lpf_butterworth, ADC_LPF_CUTOFF_HZ, (float)ADC_CONT_SAMPLE_FREQ_HZ);
    ssb_biquad4_chebyshev_lpf_init(&s_adc_lpf_chebyshev, ADC_LPF_CUTOFF_HZ, (float)ADC_CONT_SAMPLE_FREQ_HZ,
                                    ADC_LPF_CHEBYSHEV_RIPPLE_DB);
    // 2026-09-23: 6th/8th-order cascades, same fc_hz/ripple spec as the
    // 4th-order pair above - see ssb_adc_filter.h for why a higher order at
    // the SAME ripple spec doesn't cost extra ripple the way a naive
    // double-pass of the 4th-order filter would.
    ssb_biquad6_lpf_init(&s_adc_lpf_butterworth6, ADC_LPF_CUTOFF_HZ, (float)ADC_CONT_SAMPLE_FREQ_HZ);
    ssb_biquad6_chebyshev_lpf_init(&s_adc_lpf_chebyshev6, ADC_LPF_CUTOFF_HZ, (float)ADC_CONT_SAMPLE_FREQ_HZ,
                                    ADC_LPF_CHEBYSHEV_RIPPLE_DB);
    ssb_biquad8_lpf_init(&s_adc_lpf_butterworth8, ADC_LPF_CUTOFF_HZ, (float)ADC_CONT_SAMPLE_FREQ_HZ);
    ssb_biquad8_chebyshev_lpf_init(&s_adc_lpf_chebyshev8, ADC_LPF_CUTOFF_HZ, (float)ADC_CONT_SAMPLE_FREQ_HZ,
                                    ADC_LPF_CHEBYSHEV_RIPPLE_DB);

    // Must register before starting - the driver returns ESP_ERR_INVALID_STATE
    // if you try to add a callback while already running.
    adc_continuous_evt_cbs_t cbs = {
        .on_conv_done = adc_conv_done_cb,
        .on_pool_ovf  = adc_pool_ovf_cb,
    };
    ESP_ERROR_CHECK(adc_continuous_register_event_callbacks(s_adc, &cbs, NULL));

    ESP_ERROR_CHECK(adc_continuous_start(s_adc));
    s_adc_start_us = esp_timer_get_time();

    Serial.printf("adc_continuous started: target=%uHz (gptimer tick=%uHz), frame=%u samples, LPF=%.0fHz\r\n",
                  ADC_CONT_SAMPLE_FREQ_HZ, SAMPLE_RATE_HZ, ADC_CONT_FRAME_SAMPLES, ADC_LPF_CUTOFF_HZ);

    // ---- One-time raw diagnostic dump, NOT on the real-time path ----
    // Prints the exact bytes adc_continuous_read() actually returns
    // (individual raw samples, NOT the running average adc_conv_done_cb
    // computes for real-time use - this dump predates the averaging and
    // is purely a structural sanity check of the byte layout), plus how
    // our code decodes them (channel/data via adc_digi_output_data_t)
    // and the resolved value of SOC_ADC_DIGI_DATA_BYTES_PER_CONV itself.
    // The "channel" field decoded from each sample SHOULD read back as
    // ADC_CHANNEL (5) consistently - if it doesn't, that's hard evidence
    // the struct layout or per-sample byte stride assumed in the read
    // loop doesn't match this specific ESP-IDF version, rather than
    // guessing at the fix blind. Serial.printf, not ESP_LOGI - guaranteed
    // visible regardless of the IDE's Core Debug Level setting.
    Serial.printf("ADC debug: SOC_ADC_DIGI_DATA_BYTES_PER_CONV = %d (expected sample stride in bytes)\r\n",
                  (int)SOC_ADC_DIGI_DATA_BYTES_PER_CONV);
    vTaskDelay(pdMS_TO_TICKS(50));   // let a few real conversions accumulate
    {
        uint8_t dbg_buf[64];
        uint32_t dbg_bytes = 0;
        esp_err_t derr = adc_continuous_read(s_adc, dbg_buf, sizeof(dbg_buf), &dbg_bytes, 100);
        Serial.printf("ADC debug: read returned err=%s bytes=%u\r\n", esp_err_to_name(derr), dbg_bytes);
        for (uint32_t off = 0; off + SOC_ADC_DIGI_DATA_BYTES_PER_CONV <= dbg_bytes;
             off += SOC_ADC_DIGI_DATA_BYTES_PER_CONV) {
            adc_digi_output_data_t *p = (adc_digi_output_data_t *)(dbg_buf + off);
            Serial.printf("  [%u] raw=%02X %02X %02X %02X  decoded: channel=%u data=%u\r\n",
                          off / SOC_ADC_DIGI_DATA_BYTES_PER_CONV,
                          dbg_buf[off], dbg_buf[off + 1],
                          (SOC_ADC_DIGI_DATA_BYTES_PER_CONV > 2 ? dbg_buf[off + 2] : 0),
                          (SOC_ADC_DIGI_DATA_BYTES_PER_CONV > 3 ? dbg_buf[off + 3] : 0),
                          p->type2.channel, p->type2.data);
        }
    }
}

float IRAM_ATTR adc_capture_read_next_sample(void)
{
    adc_lpf_mode_t mode = s_adc_lpf_mode;

    uint32_t tail = s_adc_fifo_tail;
    uint32_t head = s_adc_fifo_head;   // snapshot - ISR may still be advancing it, fine for a single consumer
    uint32_t available = (head - tail) & ADC_FIFO_MASK;

    if (available < s_dbg_adc_fifo_min_available) s_dbg_adc_fifo_min_available = available;
    if (available > s_dbg_adc_fifo_max_available) s_dbg_adc_fifo_max_available = available;
    if (available < ADC_SAMPLES_PER_TICK) s_dbg_adc_fifo_starve_count++;

    // --- Periodic recalibration of the true Fs_adc/Fs_dsp ratio - see
    // this function's doc comment in adc_capture.h for the full design
    // rationale. Cheap (one subtraction + one division) and only runs
    // once every ADC_RATIO_CALIB_WINDOW_CALLS calls, so no per-tick cost
    // beyond the counter increment. ---
    s_resample_call_count++;
    uint32_t calls_since_calib = s_resample_call_count - s_ratio_calib_start_calls;
    if (calls_since_calib >= ADC_RATIO_CALIB_WINDOW_CALLS) {
        uint32_t samples_now = s_dbg_adc_samples_total;
        uint32_t d_samples = samples_now - s_ratio_calib_start_samples;
        if (calls_since_calib > 0) {
            float measured = (float)d_samples / (float)calls_since_calib;
            // Defensive sanity clamp - a real measurement should sit close
            // to ADC_SAMPLES_PER_TICK; guards against ever feeding a
            // garbage ratio into s_phase's recurrence below (e.g. from an
            // unexpected counter reset mid-window) rather than trusting
            // the arithmetic blindly.
            if (measured >= 1.0f && measured <= (float)ADC_SAMPLES_PER_TICK_MAX) {
                s_true_ratio = measured;
                s_ratio_calibrated = true;
            }
        }
        s_ratio_calib_start_samples = samples_now;
        s_ratio_calib_start_calls   = s_resample_call_count;
    }

    // --- Fractional resampler: advance a BOUNDED [0,1) phase accumulator
    // by the (calibrated) true ratio each tick - never an ever-growing
    // absolute position (see the BUGFIX comment on this state block for
    // why that matters) - then fold the integer part into an exact-
    // integer running target to figure out how many NEW raw samples need
    // to be popped+filtered to keep one full interpolation bracket
    // (ADC_RESAMPLE_LOOKAHEAD_SAMPLES) ahead of the ideal position. ---
    s_phase += s_true_ratio;
    uint32_t whole = (uint32_t)floorf(s_phase);
    s_phase -= (float)whole;   // back to [0,1) - this IS the interpolation weight for this tick's output
    s_resample_target_cumulative += whole;
    uint32_t desired_to_pop = (s_resample_target_cumulative > s_resample_total_consumed)
                                  ? (s_resample_target_cumulative - s_resample_total_consumed)
                                  : 0;

    // Same two safety tiers as the old scheme, just guarding the new
    // desired_to_pop instead of a hardcoded nominal+1: a genuine backlog
    // (startup, mode switch) still needs to catch up fast rather than
    // trickle back one interpolation-bracket sample at a time, and a
    // genuinely starved FIFO still just takes what's there. Both are rare/
    // transient - s_phase and s_resample_target_cumulative keep advancing
    // regardless (they don't depend on to_pop actually being reached), so
    // desired_to_pop on a later tick automatically includes any backlog
    // still owed - normal ticks resume exactly where they should once the
    // anomaly clears, same self-correcting behavior as the original
    // integer bleed scheme had.
    uint32_t to_pop = desired_to_pop;
    if (to_pop > ADC_SAMPLES_PER_TICK_MAX) {
        to_pop = ADC_SAMPLES_PER_TICK_MAX;   // genuine backlog - catch up fast
    }
    if (to_pop > available) {
        to_pop = available;                  // genuinely starved - take what's there
    }
    for (uint32_t i = 0; i < to_pop; i++) {
        float raw = (float)s_adc_fifo[tail];
        float filtered;
        switch (mode) {
            case ADC_LPF_MODE_BUTTERWORTH:
                filtered = ssb_biquad4_process(&s_adc_lpf_butterworth, raw);
                break;
            case ADC_LPF_MODE_CHEBYSHEV:
                filtered = ssb_biquad4_process(&s_adc_lpf_chebyshev, raw);
                break;
            case ADC_LPF_MODE_BUTTERWORTH6:
                filtered = ssb_biquad6_process(&s_adc_lpf_butterworth6, raw);
                break;
            case ADC_LPF_MODE_CHEBYSHEV6:
                filtered = ssb_biquad6_process(&s_adc_lpf_chebyshev6, raw);
                break;
            case ADC_LPF_MODE_BUTTERWORTH8:
                filtered = ssb_biquad8_process(&s_adc_lpf_butterworth8, raw);
                break;
            case ADC_LPF_MODE_CHEBYSHEV8:
                filtered = ssb_biquad8_process(&s_adc_lpf_chebyshev8, raw);
                break;
            case ADC_LPF_MODE_OFF:
            default:
                filtered = raw;
                break;
        }
        s_filt_prev = s_filt_curr;
        s_filt_curr = filtered;
        tail = (tail + 1) & ADC_FIFO_MASK;
    }
    s_adc_fifo_tail = tail;
    s_resample_total_consumed += to_pop;

    // Linear interpolation between the two bracketing filtered samples, at
    // s_phase - the bounded fractional remainder computed above, which IS
    // exactly the leftover position (proven algebraically equivalent to
    // frac(ideal absolute position) - see the BUGFIX comment on this
    // state block). If to_pop was clamped short (starvation/backlog),
    // s_filt_prev/s_filt_curr lag behind the ideal bracket and this
    // degrades gracefully to a slightly stale interpolation - the same
    // kind of graceful degradation the old scheme had during those same
    // anomalies, not a new failure mode.
    return s_filt_prev + s_phase * (s_filt_curr - s_filt_prev);
}

float adc_capture_get_true_ratio(void)
{
    return s_true_ratio;
}

bool adc_capture_ratio_is_calibrated(void)
{
    return s_ratio_calibrated;
}

void adc_capture_service(void)
{
    // Keep adc_continuous's internal pool from filling up. The
    // on_conv_done callback (see adc_conv_done_cb) already captures every
    // frame's newest sample for dsp_task's use as it arrives - this call's
    // only job is freeing up the underlying pool so it doesn't overflow
    // (on_pool_ovf), so its contents are simply discarded. Low priority,
    // not time-critical. Runs unconditionally - the ADC is always active
    // (see adc_capture_init(), called unconditionally from setup())
    // regardless of the current audio source, so this pool needs draining
    // either way.
    uint8_t drain_buf[256];
    uint32_t drain_bytes = 0;
    while (adc_continuous_read(s_adc, drain_buf, sizeof(drain_buf), &drain_bytes, 0) == ESP_OK
           && drain_bytes > 0) {
        // discarded
    }
}

void adc_capture_set_lpf_mode(adc_lpf_mode_t mode)
{
    adc_lpf_mode_t prev = s_adc_lpf_mode;

    // Only one filter's state actually advances per sample (see the
    // switch in adc_capture_read_next_sample()) - the OTHER filter's z1/z2
    // sit frozen at whatever they were the last time IT was active, which
    // could be a long time ago (or never, if this is its first use since
    // boot - though init already zeroed it then). Switching TO a filtered
    // mode from a DIFFERENT mode resets that filter's state first, so the
    // first sample after switching doesn't get fed a stale/discontinuous
    // z1/z2 - same reset-on-transition reasoning as
    // envelope_gdeq_set_enabled()'s off->on reset. A no-op "switch" (mode
    // unchanged, e.g. reapplying the same preset) does NOT reset, so a
    // filter already running continues running continuously rather than
    // glitching every time.
    if (mode != prev) {
        if (mode == ADC_LPF_MODE_BUTTERWORTH) {
            ssb_biquad4_reset(&s_adc_lpf_butterworth);
        } else if (mode == ADC_LPF_MODE_CHEBYSHEV) {
            ssb_biquad4_reset(&s_adc_lpf_chebyshev);
        } else if (mode == ADC_LPF_MODE_BUTTERWORTH6) {
            ssb_biquad6_reset(&s_adc_lpf_butterworth6);
        } else if (mode == ADC_LPF_MODE_CHEBYSHEV6) {
            ssb_biquad6_reset(&s_adc_lpf_chebyshev6);
        } else if (mode == ADC_LPF_MODE_BUTTERWORTH8) {
            ssb_biquad8_reset(&s_adc_lpf_butterworth8);
        } else if (mode == ADC_LPF_MODE_CHEBYSHEV8) {
            ssb_biquad8_reset(&s_adc_lpf_chebyshev8);
        }
        // Switching TO off needs no reset - raw passthrough has no state.
    }

    s_adc_lpf_mode = mode;
}

adc_lpf_mode_t adc_capture_get_lpf_mode(void)
{
    return s_adc_lpf_mode;
}

const char *adc_capture_lpf_mode_name(adc_lpf_mode_t mode)
{
    switch (mode) {
        case ADC_LPF_MODE_BUTTERWORTH:  return "Butterworth";
        case ADC_LPF_MODE_CHEBYSHEV:    return "Chebyshev";
        case ADC_LPF_MODE_BUTTERWORTH6: return "Butterworth6";
        case ADC_LPF_MODE_CHEBYSHEV6:   return "Chebyshev6";
        case ADC_LPF_MODE_BUTTERWORTH8: return "Butterworth8";
        case ADC_LPF_MODE_CHEBYSHEV8:   return "Chebyshev8";
        case ADC_LPF_MODE_OFF:
        default:                      return "off";
    }
}

// 2026-09-21, BUGFIX: found by reasoning through a user-reported
// intermittent "funny mode with strange IMDs" seen on both 64k and 80k
// (i.e. independent of ADC_CONT_SAMPLE_FREQ_HZ - pointing at something in
// the shared resampler/calibration logic or a mode interaction, not the
// ADC rate itself). adc_capture_read_next_sample() - and therefore
// s_resample_call_count and the calibration window it drives - is only
// ever called in mic mode (see that function's own doc comment); but
// adc_continuous itself, and s_dbg_adc_samples_total with it, runs
// UNCONDITIONALLY regardless of audio source (see adc_capture_service()'s
// comment). So: spend any time in a non-mic mode ('s'/'t'/etc.), switch
// back to 'm', and the very next calibration window measures
// (samples produced during the ENTIRE non-mic interval, however long)
// divided by (only that window's ~4s worth of calls) - a badly inflated
// ratio. The defensive clamp in the calibration block below rejects the
// most extreme cases (long time away), but a shorter mode excursion can
// land the inflated value just within the accepted range, corrupting
// s_true_ratio with a wrong-but-plausible-looking number and putting the
// resampler into exactly the kind of "funny mode" reported. Fixed by
// priming a fresh calibration baseline every time mic mode is
// (re-)entered - see adc_capture_resample_prime_calibration() below and
// its call sites in serial_commands.cpp - rather than only at boot and on
// a manual 'r'.
void adc_capture_resample_prime_calibration(void)
{
    s_ratio_calib_start_samples = s_dbg_adc_samples_total;
    s_ratio_calib_start_calls   = s_resample_call_count;
}

void adc_capture_reset_diag(void)
{
    s_dbg_adc_samples_total = 0;
    s_dbg_adc_callback_count = 0;
    s_dbg_adc_pool_ovf_count = 0;
    s_dbg_adc_fifo_starve_count = 0;
    s_dbg_adc_fifo_min_available = 0xFFFFFFFFu;
    s_dbg_adc_fifo_max_available = 0;
    s_dbg_adc_fifo_drop_count = 0;
    s_adc_start_us = esp_timer_get_time();   // restarts the long-window average from now

    // Restart the resampler's own calibration window from here too, so a
    // manual 'r' reset gives a clean, from-now measurement rather than
    // blending in whatever ratio was calibrated before the reset - kept
    // deliberately consistent with the long-window average restart above.
    // s_true_ratio itself (and s_ratio_calibrated) are intentionally left
    // as-is: they're the best current estimate of the real hardware ratio
    // and resetting them to the nominal seed would throw away a real
    // measurement for no reason, unlike the diagnostic counters above
    // which are just accumulators being zeroed.
    adc_capture_resample_prime_calibration();
}

void adc_capture_get_diag(adc_capture_diag_t *out)
{
    out->samples_total = s_dbg_adc_samples_total;
    out->callback_count = s_dbg_adc_callback_count;
    out->pool_ovf_count = s_dbg_adc_pool_ovf_count;
    out->fifo_starve_count = s_dbg_adc_fifo_starve_count;
    out->fifo_min_available = s_dbg_adc_fifo_min_available;
    out->fifo_max_available = s_dbg_adc_fifo_max_available;
    out->fifo_drop_count = s_dbg_adc_fifo_drop_count;
}

int64_t adc_capture_get_start_us(void)
{
    return s_adc_start_us;
}

void adc_capture_get_lpf_canary(adc_lpf_canary_t *out)
{
    if (!out) return;
    out->butterworth_finite = isfinite(s_adc_lpf_butterworth.stage1.z1) && isfinite(s_adc_lpf_butterworth.stage1.z2)
                            && isfinite(s_adc_lpf_butterworth.stage2.z1) && isfinite(s_adc_lpf_butterworth.stage2.z2);
    out->chebyshev_finite = isfinite(s_adc_lpf_chebyshev.stage1.z1) && isfinite(s_adc_lpf_chebyshev.stage1.z2)
                          && isfinite(s_adc_lpf_chebyshev.stage2.z1) && isfinite(s_adc_lpf_chebyshev.stage2.z2);
    // 2026-09-23: same finiteness check, extended to the 6th/8th-order
    // cascades' extra stages.
    out->butterworth6_finite = isfinite(s_adc_lpf_butterworth6.stage1.z1) && isfinite(s_adc_lpf_butterworth6.stage1.z2)
                             && isfinite(s_adc_lpf_butterworth6.stage2.z1) && isfinite(s_adc_lpf_butterworth6.stage2.z2)
                             && isfinite(s_adc_lpf_butterworth6.stage3.z1) && isfinite(s_adc_lpf_butterworth6.stage3.z2);
    out->chebyshev6_finite = isfinite(s_adc_lpf_chebyshev6.stage1.z1) && isfinite(s_adc_lpf_chebyshev6.stage1.z2)
                           && isfinite(s_adc_lpf_chebyshev6.stage2.z1) && isfinite(s_adc_lpf_chebyshev6.stage2.z2)
                           && isfinite(s_adc_lpf_chebyshev6.stage3.z1) && isfinite(s_adc_lpf_chebyshev6.stage3.z2);
    out->butterworth8_finite = isfinite(s_adc_lpf_butterworth8.stage1.z1) && isfinite(s_adc_lpf_butterworth8.stage1.z2)
                             && isfinite(s_adc_lpf_butterworth8.stage2.z1) && isfinite(s_adc_lpf_butterworth8.stage2.z2)
                             && isfinite(s_adc_lpf_butterworth8.stage3.z1) && isfinite(s_adc_lpf_butterworth8.stage3.z2)
                             && isfinite(s_adc_lpf_butterworth8.stage4.z1) && isfinite(s_adc_lpf_butterworth8.stage4.z2);
    out->chebyshev8_finite = isfinite(s_adc_lpf_chebyshev8.stage1.z1) && isfinite(s_adc_lpf_chebyshev8.stage1.z2)
                           && isfinite(s_adc_lpf_chebyshev8.stage2.z1) && isfinite(s_adc_lpf_chebyshev8.stage2.z2)
                           && isfinite(s_adc_lpf_chebyshev8.stage3.z1) && isfinite(s_adc_lpf_chebyshev8.stage3.z2)
                           && isfinite(s_adc_lpf_chebyshev8.stage4.z1) && isfinite(s_adc_lpf_chebyshev8.stage4.z2);
}
