Rich5252/Arduino_ESP32_ssb_signal_generator/diagnostics.cpp

/**
 * diagnostics.cpp - see diagnostics.h.
 */

#include "diagnostics.h"
#include "config.h"
#include "dsp_state.h"
#include "adc_capture.h"
#include "envelope_gdeq.h"
#include "envelope_ampeq.h"
#include "envelope_alc.h"
#include "envelope_output.h"
#include "ssb_dsp.h"
#include "carrier_output.h"
#include "relative_delay.h"   // 2026-09-12: relative_delay_get_samples() - per-event jump log below
#include "test_signals.h"
#include "esp_timer.h"
#include "esp_err.h"
#include "esp_freertos_hooks.h"   // esp_register_freertos_idle_hook_for_cpu() - see core1_idle_hook() below
#include <Arduino.h>

// Written by dsp_task, printed by diagnostics_service() on Core 1 at low
// priority - keeps Serial (slow) completely out of the real-time task.
static volatile float s_dbg_envelope = 0.0f;
static volatile float s_dbg_freq_dev = 0.0f;
#if AD9851_ATTACHED
static volatile float s_dbg_delayed_freq_dev = 0.0f;   // post-delay-line value, actually used
static volatile uint32_t s_dbg_tx_freq = 0;             // the exact integer Hz value sent to
                                                          // ad9851_set_frequency() - ground truth

// 2026-09-10: tick-to-tick step-size high-water mark on tx_freq itself, for
// the random-TX-jump investigation (see moving_forward_notes.md's
// "new jump occurrence" entries). Unlike null_bias/weighted_bias (already
// confirmed decoupled from the real jumps) or the canary (which only
// catches corruption of s_carrier_hz/ftw_reciprocal specifically, and has
// now stayed clean across two observed jumps), this measures the actual
// ground-truth signal handed to the chip every tick, directly. If a real
// jump this size never shows up here even while one is observed at RF, the
// fault is downstream of every bit of digital math in this pipeline -
// REF_CLK, the AD9851's internal PLL, or the SPI transfer itself - not
// anything this firmware computes. s_dbg_have_prev_tx_freq guards the very
// first call after boot/reset, which has no previous tick to compare
// against.
static volatile uint32_t s_dbg_prev_tx_freq = 0;
static volatile bool s_dbg_have_prev_tx_freq = false;
static volatile uint32_t s_dbg_max_freq_dev_step_hz = 0;
static volatile uint32_t s_dbg_max_freq_dev_step_from_hz = 0;
static volatile uint32_t s_dbg_max_freq_dev_step_to_hz = 0;
static volatile uint32_t s_dbg_max_freq_dev_step_at_ms = 0;

// 2026-09-11: does a max_freq_dev_step event actually self-correct on the
// very next tick, or does tx_freq stay elevated/"stuck" for longer? The
// high-water-mark fields above can't answer that - they only ever record
// the two values straddling the single worst step, never what happens
// afterward. User's own objection: a genuine one-tick DSP transient (the
// EER/polar-transmitter null-crossing effect - see moving_forward_notes.md's
// 2026-09-11 entry) should recover automatically within one 62.5us tick,
// since freq_dev is recomputed fresh from atan2(Q,I) every sample with no
// persistent memory (the slew limiter, the one thing that WOULD carry state
// tick-to-tick, is currently off/unlimited in every preset - see
// ssb_dsp.c's freq_dev_slew_limit_hz); a real "sticks rather than blips"
// symptom (the original, much older canary-motivating theory) would not.
// This settles it empirically instead of by argument: captures this tick's
// tx_freq (the post-jump value itself) plus the next FREQ_STEP_TRACE_LEN-1
// ticks' worth, every time a NEW record-breaking step is set (re-arms and
// overwrites any still-filling older trace - only the worst event's
// aftermath matters). Printed as [dsp] post-step trace - see the print site
// near max_freq_dev_step below.
#define FREQ_STEP_TRACE_LEN 8
static volatile uint32_t s_dbg_freq_step_trace[FREQ_STEP_TRACE_LEN];
// 2026-09-12: parallel envelope capture for the trace above - added
// alongside the jump log below, same motivation (see that block's comment).
// The post-step trace could tell us tx_freq recovers within a tick, but not
// whether the jump itself happened at a near-null sample - this closes that
// gap for the SAME worst-ever event the tx_freq trace already captures.
static volatile float    s_dbg_freq_step_trace_envelope[FREQ_STEP_TRACE_LEN];
static volatile uint8_t  s_dbg_freq_step_trace_fill = 0;    // 0 = no trace captured yet this window
static volatile bool     s_dbg_freq_step_trace_armed = false;

// 2026-09-12: per-event jump LOG - a deliberately different tool from the
// high-water-mark fields and the post-step trace above, both of which only
// ever remember the SINGLE worst tx_freq step seen across an entire run.
// That's fine for "was there ever a bad one" but it means a multi-hour
// unattended capture hands back exactly one data point - not enough to
// settle whether every jump is genuinely explained by the null-crossing
// mechanism this file's whole investigation has been built around, which
// is exactly the user's own engineering doubt (moving_forward_notes.md,
// 2026-09-12: "I still have my engineering doubts that this is the only
// problem"). This keeps the last JUMP_LOG_LEN qualifying events (a lower,
// more inclusive bar than "new all-time record" - JUMP_LOG_THRESHOLD_HZ),
// each stamped with enough context to be judged individually rather than
// argued about in aggregate:
//   - envelope: envelope_at_freq_time (relative_delay.h/.cpp) - the
//     envelope value from the SAME original sample time as the (possibly
//     delayed) freq_dev value that produced this tx_freq step. 2026-09-12
//     CORRECTION, same day: this field originally used delayed_envelope
//     instead - the POST-delay envelope - reasoning that "was this
//     near-null AT THE MOMENT OF TRANSMISSION" was the physically relevant
//     question (per the relative_delay/near-null-spike interaction in
//     null_bias_investigation.md's earlier 2026-09-12 entry). That
//     reasoning was wrong in one specific way: for delay>0 (every two-tone
//     preset), envelope itself is read at zero lag inside
//     relative_delay_apply() (env_back=0), so delayed_envelope is just the
//     CURRENT tick's envelope - NOT time-matched to the freq_dev value
//     that got delayed. At large delay this can badly misclassify a
//     genuine null-crossing event as near_null=false, since the envelope
//     being compared against is from the wrong moment entirely. The very
//     first bench capture with this log (relative_delay=+4.60,
//     503384 events, 0% near_null) is likely exactly this failure mode,
//     not proof of a second mechanism - see moving_forward_notes.md's
//     2026-09-12 entry for the full reasoning and what would distinguish
//     the two.
//   - relative_delay_samples: current delay setting - lets a delay sweep
//     be correlated against jump occurrence directly, firmware-side,
//     instead of only inferring it from Aux SP behavior.
//   - busy_us: this tick's own DSP busy time - a timing-domain cause (the
//     Core-1-serial-bleed-into-Core-0 mechanism already root-caused twice
//     in this project's history) would show up here directly, as an
//     anomalous busy_us coinciding with the jump.
//   - audio_source: settles "does this also happen on mic input, not just
//     the perfectly-periodic two-tone test signal" without a separate
//     experiment - just leave 'J' logging running across a source change
//     and compare counts.
//   - near_null: envelope < ssb_dsp_get_null_bias_threshold() at capture -
//     the single most direct test of the null-crossing hypothesis. If the
//     near-null percentage across many logged events stays near 100%, that's
//     strong, repeated (not anecdotal) support for the existing theory. If a
//     meaningful fraction of events come back near_null=false, that's
//     direct, hard evidence of a SEPARATE mechanism at work.
#define JUMP_LOG_LEN 8
#define JUMP_LOG_THRESHOLD_HZ 300u   // well above ordinary in-band modulation
                                     // step sizes, well below every jump
                                     // magnitude actually observed so far
                                     // (hundreds to thousands of Hz) - lower
                                     // this if a run known to have jumps
                                     // still comes back with jump_log n=0

typedef struct {
    uint32_t at_ms;
    uint32_t from_hz;
    uint32_t to_hz;
    uint32_t step_hz;
    float    envelope;                  // envelope_at_freq_time (blended) - time-matched to from_hz/to_hz
    float    envelope_min;              // envelope_at_freq_time_min - see relative_delay.h/.cpp, 2026-09-12
    float    relative_delay_samples;
    uint32_t busy_us;                   // filled in slightly later by diagnostics_record_jump_busy_us()
    uint8_t  audio_source;              // audio_source_t, narrowed - see audio_source_name()
    // 2026-09-12: two DIFFERENT near-null questions, not the same one
    // measured twice - see relative_delay.h's out_envelope_at_freq_time_min
    // declaration comment for why a lopsided fractional delay needs both.
    bool     near_null_blended;         // envelope (the blend) < threshold - "was the RESULT near a null"
    bool     near_null_either;          // envelope_min < threshold - "did ANY contributing raw sample dip near a null"
    // 2026-09-12, later same day: the two RAW, undelayed freq_dev_hz ring
    // values interp_ring() blended to produce this event's (delayed)
    // freq_dev - see diagnostics_set_tx_info()'s declaration comment
    // (diagnostics.h) and relative_delay_apply()'s (relative_delay.h) for
    // the full reasoning. Logged for inspection, not used in any
    // near_null classification of their own.
    float    raw_freq_dev_near;
    float    raw_freq_dev_far;
} jump_log_entry_t;

static jump_log_entry_t s_jump_log[JUMP_LOG_LEN];
static uint32_t s_jump_log_write_idx = 0;
static uint32_t s_jump_log_count = 0;          // total qualifying events since boot/reset (can exceed JUMP_LOG_LEN - ring wraps)
static uint32_t s_jump_log_near_null_blended_count = 0;
static uint32_t s_jump_log_near_null_either_count = 0;
static bool           s_jump_pending = false;   // set by diagnostics_set_tx_info(), consumed by
static jump_log_entry_t s_jump_pending_entry;   // diagnostics_record_jump_busy_us() a few lines later, same tick

// 2026-09-12, yet later still: a SEPARATE, much slower-timescale trigger,
// built after the user reported (and then directly confirmed on the
// bench) that the 'J' log above is the wrong tool for "what changed to
// the frequency I can actually see/hear" - it fires on every single beat-
// null crossing (hundreds to thousands of times a second, per the
// captures logged in moving_forward_notes.md/null_bias_investigation.md's
// 2026-09-12 entries), so by the time a human reacts to an observed
// frequency shift and reads 'J', the ring has wrapped many times over
// with unrelated routine churn. Direct confirmation, not just theory: a
// capture taken deliberately right after Aux SP showed a real 1000->962Hz
// shift came back showing the EXACT SAME 3-state cycle, same values, as
// every "nothing happened" capture before it - the low-level log carries
// no signal at all about when a human-perceptible shift occurred, because
// its threshold (300Hz, per-tick) is answering a completely different,
// much smaller and much more frequent question than "did the steady-state
// frequency someone is watching just move."
//
// Approach: track two EMAs of delayed_freq_dev_hz - the same value the
// periodic [dsp] status line already reports - one "fast" (tau
// FREQ_EMA_FAST_TAU_S, chosen to be several times longer than one beat-
// null cycle's ~3-5ms period so the existing per-cycle churn averages out
// almost completely) and one much slower "reference" (tau
// FREQ_EMA_SLOW_TAU_S) that lags behind and represents "where this has
// been sitting." When they diverge by more than SLOW_JUMP_TRIGGER_HZ -
// deliberately set to the user's own independently-reported +/-5Hz
// visual-read tolerance on Aux SP (null_bias_investigation.md's
// 2026-09-12 entries), not a DSP-internal number - that's treated as a
// change a human watching the display would actually notice.
//
// On trigger, a coarse (SLOW_TRACE_BIN_TICKS-tick bins, not raw per-tick -
// keeps RAM/print-time modest while still showing the shape of the
// transition) trace spanning SLOW_TRACE_PRE_BINS bins before the trigger
// and SLOW_TRACE_POST_BINS after is LATCHED - unlike the 'J' ring, which
// keeps sliding forward forever, this one deliberately STOPS recording
// once it has an answer, specifically so a human-reaction-time delay
// before reading it (via the new 'K' command) can't erase it. Printing
// re-arms it (and resyncs the slow EMA to the fast one, so the two start
// equal again rather than immediately re-triggering while the slow EMA is
// still catching up from the just-reported event) for the next one.
// Deliberately NOT touched by diagnostics_reset()/'r' - same reasoning as
// the canary latches elsewhere in this file: a rare, significant event
// capture shouldn't silently vanish just because someone started a fresh
// routine measurement window before reading it.
typedef struct {
    float freq_mean_hz;   // mean of delayed_freq_dev_hz over the bin
    float env_min;        // min of envelope_at_freq_time over the bin - the most
                           // null-like single sample seen in that bin, same
                           // "did anything dip near a null" spirit as
                           // near_null_either above, just per-bin instead of
                           // per-blend
} slow_trace_bin_t;

#define SLOW_TRACE_BIN_TICKS 20     // 1.25ms/bin @ 16kHz - coarse enough to keep
                                    // the eventual print (PRE_BINS+POST_BINS
                                    // lines) manageable, fine enough to still
                                    // show the transition's shape against the
                                    // ~3-5ms beat-null cycle period
#define SLOW_TRACE_PRE_BINS  40    // 50ms of context before the trigger
#define SLOW_TRACE_POST_BINS 40    // 50ms captured after

#define FREQ_EMA_FAST_TAU_S 0.05f  // 50ms - several beat-null cycles' worth
#define FREQ_EMA_SLOW_TAU_S 2.0f   // 2s - deliberately much slower, so it lags
                                   // behind as "where this has been sitting"
static const float FREQ_EMA_DT_S = (float)SSB_SAMPLE_PERIOD_US / 1000000.0f;
static const float FREQ_EMA_FAST_ALPHA = FREQ_EMA_DT_S / (FREQ_EMA_FAST_TAU_S + FREQ_EMA_DT_S);
static const float FREQ_EMA_SLOW_ALPHA = FREQ_EMA_DT_S / (FREQ_EMA_SLOW_TAU_S + FREQ_EMA_DT_S);
#define SLOW_JUMP_TRIGGER_HZ 5.0f  // matches the user's own reported +/-5Hz
                                   // visual-read tolerance on Aux SP - see
                                   // this block's header comment

// 2026-09-12, yet later still: FIRST REAL 'K' CAPTURE turned out to be a
// false positive, caused by the EMA seeding itself, not a real event -
// before=697.40Hz after=704.63Hz (delta=+7.23Hz) with only 3 pre-bins
// filled (i.e. this fired within ~4ms of boot/reset) and a post-trace
// showing the exact same repeating cycle (800/800/800/400Hz, period 4
// bins) both before AND after the "trigger," with no visible transition
// anywhere in it. Root cause: both EMAs seed from a single RAW
// (unaveraged) sample on the very first tick - if that sample happens to
// land on one extreme of the ongoing periodic churn (800Hz here, not the
// cycle's ~700Hz time-average), the FAST EMA (tau=50ms) converges toward
// the true average within tens of ms while the SLOW EMA (tau=2s) is still
// sitting almost exactly at the biased seed value - diverging by more
// than SLOW_JUMP_TRIGGER_HZ almost immediately, from initialization bias
// alone, regardless of whether anything real happened. A resync at re-arm
// (diagnostics_print_slow_trace()) has the same exposure in miniature -
// the fast EMA it snaps the slow one to is itself only tau=50ms smoothed,
// so it can still be offset from the true multi-second average right
// after a busy cycle.
//
// FIRST FIX ATTEMPT (an 8s, ~4x-slow-tau warm-up hold on the trigger
// check) turned out to be UNDERSIZED, not wrong in kind - a follow-up
// capture at t=9239ms (i.e. AFTER that 8s hold had already lifted) still
// fired, and its new TREND block (added for exactly this reason) showed
// why directly: `fast` was already rock-steady at 699.07-699.08Hz for the
// entire visible 2s history, while `slow` was still climbing smoothly and
// monotonically (666.23 -> 687.31Hz over that same 2s, a textbook
// exponential settling curve) - i.e. still visibly converging from its
// boot seed value nearly 9.2s in. Extrapolating that curve back
// implies a seed value hundreds to over a thousand Hz away from the true
// ~699Hz average - entirely plausible given this project's own
// well-documented near-null freq_dev spikes (thousands of Hz, see the
// 'J' captures elsewhere in this file) landing on the single raw sample
// used to seed both EMAs. The "4 tau -> ~98% converged" heuristic behind
// the original 8s figure assumed a "reasonably-sized" initial error - it
// doesn't hold when the seed itself can be a thousand-Hz outlier, where
// even a small residual PERCENTAGE is still tens of Hz.
//
// REAL fix: stop seeding the slow EMA from a raw sample at all. Seed only
// the FAST EMA that way (its own short tau, ~50ms, makes it converge to
// the true running average almost immediately regardless of what the
// seed was), let it run alone for FREQ_EMA_BOOT_SETTLE_MS (~10x its own
// tau - by then it's converged from even a large seed error to within a
// small fraction of a percent), THEN snap slow = fast's already-converged
// value - never seeding slow from a potentially-extreme raw sample in the
// first place, rather than trying to out-wait an error whose size was
// never bounded to begin with. A short residual FREQ_EMA_WARMUP_MS hold
// on the trigger check remains afterward, purely as insurance (e.g.
// against the snap instant itself landing mid-spike) - now starting from
// an already-good value instead of a raw one, so it only needs to cover
// ordinary EMA noise, not an unbounded seed error.
#define FREQ_EMA_BOOT_SETTLE_MS 500.0f   // ~10x FREQ_EMA_FAST_TAU_S
static const uint32_t FREQ_EMA_BOOT_SETTLE_TICKS =
    (uint32_t)(FREQ_EMA_BOOT_SETTLE_MS * 1000.0f / (float)SSB_SAMPLE_PERIOD_US);
#define FREQ_EMA_WARMUP_MS 8000.0f
static const uint32_t FREQ_EMA_WARMUP_TICKS =
    (uint32_t)(FREQ_EMA_WARMUP_MS * 1000.0f / (float)SSB_SAMPLE_PERIOD_US);

static float    s_freq_ema_fast_hz = 0.0f;
static float    s_freq_ema_slow_hz = 0.0f;

// 2026-09-16: post-delay, envelope^2-weighted companion to the plain fast
// EMA above - see this date's null_bias_investigation.md entry for the
// full story. The existing null_bias/weighted_bias diagnostic
// (print_null_bias_block(), fed by ssb_dsp.c's env2_dphi_sum/env2_sum) was
// already found, back on 2026-09-12, to accumulate PRE-delay - inside
// ssb_dsp_process_sample(), before relative_delay_apply() re-pairs
// freq_dev_hz against envelope at whatever lag relative_delay is actually
// set to. That's exactly why "weighted_bias doesn't track the real jump at
// all" (2026-09-09 finding, moving_forward_notes.md) and why a "post-delay
// null_bias variant" was proposed that same day (see diagnostics.h's
// delayed_envelope comment) but never implemented. This is that variant,
// built the same way the plain fast/slow EMA above is (same alpha, same
// per-tick update site, so it's directly comparable via 'H'), but fed from
// delayed_freq_dev_hz and envelope_at_freq_time specifically - NOT
// delayed_envelope, which relative_delay.h's own declaration comment
// already warns is not time-matched to delayed_freq_dev_hz once delay is
// nonzero (envelope_at_freq_time is always read at the same lag freq_dev_hz
// was, which is why the jump log switched to it back on 2026-09-12 too).
//
// Implemented as a running numerator/denominator pair - an EMA of
// (envelope^2 * dev) over an EMA of (envelope^2) - whose ratio is the
// standard envelope^2-weighted mean (the same identity ssb_dsp.h's own
// null_bias doc comment establishes: this equals the transmitted power
// spectrum's centroid, the number an SDR actually reads). Den is guarded
// against being near-zero (sustained near-total silence) in the getter
// below, not here - see energy_weighted_fast_hz().
static float    s_freq_ema_energy_num_fast = 0.0f;
static float    s_freq_ema_energy_den_fast = 0.0f;

// 2026-09-16, later still: second, correctly-paired sibling of the pair
// above - same fast-EMA structure, but weighted by raw_envelope_current
// (this tick's own envelope, straight out of ssb_dsp_process_sample(),
// before envelope_floor/gdeq/ampeq/predistort/the PWM mapping reshape it)
// against raw_freq_dev_current (this tick's own pre-delay freq_dev_hz),
// instead of envelope_at_freq_time/delayed_freq_dev_hz. Built after the
// same-instant cross-check against ssb_dsp.c's own validated
// env2_dphi_sum/env2_sum (log_20260916_212424.txt) showed THAT
// raw-envelope-paired accumulator staying stable within a few Hz while the
// pair above swung 80+Hz on an unchanging bench setup - see
// diagnostics_set_tx_info()'s raw_freq_dev_current/raw_envelope_current
// declaration comment (diagnostics.h) for the full reasoning and the two
// known simplifications (pre-delay, post-clamp) this inherits. If this one
// ALSO holds steady where the shaped-envelope pair swings, that's the
// decisive confirmation the shaped envelope (not the physical signal) was
// the whole session's source of the "computed vs measured" puzzle.
static float    s_freq_ema_rawenergy_num_fast = 0.0f;
static float    s_freq_ema_rawenergy_den_fast = 0.0f;

// 2026-09-16, later same day: shared with energy_weighted_fast_hz() below -
// promoted out of that function so diagnostics_set_tx_info()'s anchor-seed
// block (near s_freq_anchor_hz) can use the exact same guard when seeding
// s_freq_energy_anchor_hz, instead of duplicating the threshold and risking
// the two silently drifting apart later.
static const float MIN_ENERGY_DEN = 1.0e-6f;

// Forward declaration - definition (with its own full doc comment) lives
// near diagnostics_print_held_status() below, but the slow-jump trigger
// arm/close sites (diagnostics_set_tx_info(), well above that point in
// this file) and the new energy-weighted held-detector need to call it
// too. Kept as one real function rather than three copies of the same
// numerator/denominator ratio.
static float energy_weighted_fast_hz(void);

// Forward declaration, same reasoning as energy_weighted_fast_hz() just
// above - the real definition (with its full design comment) lives near
// diag_room_for()/diagnostics_freqenv_capture_arm() below, but
// diagnostics_set_tx_info() (well above that point in this file) needs to
// call it every tick. See diagnostics_freqenv_capture_arm()'s declaration
// comment in diagnostics.h for the 'F' full-rate freq/env capture feature
// this is part of. AD9851-only (like the rest of that feature - and like
// diagnostics_set_tx_info()'s own real body, which this is called from) -
// guarded here too so there's no dangling reference to it when not built.
#if AD9851_ATTACHED
static inline void IRAM_ATTR freqenv_capture_tick(float raw_freq_dev_current, float raw_envelope_current);
#endif

// 2026-09-16, later same day: found on first bench test (see this date's
// null_bias_investigation.md entry, "energy_weighted dev compared against
// the wrong anchor") that the energy-weighted line's dev=+410Hz etc. was
// meaningless - it was being measured against s_freq_anchor_hz, which is
// seeded from the PLAIN fast EMA, not this one. A plain-mean and an
// energy-weighted mean of the same signal are legitimately different
// numbers even with nothing wrong (see ssb_dsp.h's own null_bias doc
// comment on why an equal-amplitude two-tone's time-average and
// power-weighted-average differ) - comparing energy-weighted's absolute
// level against the plain anchor will ALWAYS show a large, static, gap
// that has nothing to do with any real event. Gives the energy-weighted
// EMA its own anchor, seeded at the exact same boot-settle instant as
// s_freq_anchor_hz, so ITS dev is measured against ITS OWN baseline -
// the only way "dev" is comparable to a real SDR-observed deviation.
static float    s_freq_energy_anchor_hz = 0.0f;
static bool     s_freq_energy_anchor_inited = false;

// 2026-09-16, later still: same reasoning, own anchor, for the raw-envelope-
// paired sibling EMA (s_freq_ema_rawenergy_num_fast/den_fast above) - kept
// fully separate from s_freq_energy_anchor_hz since the two EMAs weight by
// different envelope signals and have no reason to converge to the same
// baseline even if both are working correctly.
static float    s_freq_rawenergy_anchor_hz = 0.0f;
static bool     s_freq_rawenergy_anchor_inited = false;
static float rawenergy_weighted_fast_hz(void);

static bool     s_freq_ema_fast_inited = false;   // fast EMA seeded from the first-ever raw sample
static bool     s_freq_ema_slow_inited = false;   // slow EMA snapped from fast after the boot settle
static uint32_t s_freq_ema_boot_settle_ticks_left = 0;   // counts down FREQ_EMA_BOOT_SETTLE_TICKS
                                                          // before the slow-EMA snap happens
static uint32_t s_freq_ema_warmup_ticks_left = 0;   // set to FREQ_EMA_WARMUP_TICKS once slow is
                                                     // snapped (boot) or resynced (re-arm) -
                                                     // trigger check is held off while nonzero

typedef enum { SLOW_TRACE_WATCHING = 0, SLOW_TRACE_CAPTURING_POST, SLOW_TRACE_LATCHED } slow_trace_state_t;
static slow_trace_state_t s_slow_trace_state = SLOW_TRACE_WATCHING;

static slow_trace_bin_t s_slow_pre_ring[SLOW_TRACE_PRE_BINS];
static uint32_t s_slow_pre_write_idx = 0;
static uint32_t s_slow_pre_fill = 0;   // like jump_log_count's own "have we wrapped yet"

static slow_trace_bin_t s_slow_post_bins[SLOW_TRACE_POST_BINS];
static uint32_t s_slow_post_fill = 0;

static float    s_slow_bin_sum_freq = 0.0f;
static float    s_slow_bin_min_env = 1e9f;
static uint32_t s_slow_bin_count = 0;

static uint32_t s_slow_trigger_at_ms = 0;
static float    s_slow_trigger_before_hz = 0.0f;   // slow (reference) EMA at the trigger instant
static float    s_slow_trigger_after_hz = 0.0f;    // fast EMA once the post capture completes
static float    s_slow_trigger_delta_hz = 0.0f;
static float    s_slow_trigger_relative_delay = 0.0f;
static uint32_t s_slow_trigger_delay_change_ms = 0;   // relative_delay_get_last_change_ms() at
                                                       // the trigger instant - see that
                                                       // function's declaration comment
                                                       // (relative_delay.h)

// 2026-09-16, later same day: energy-weighted companion snapshot for this
// SAME trigger - see this date's null_bias_investigation.md entry
// ("correction - the recurring ~153.6s rise/recovery pattern is very
// likely a plain-EMA null-noise artifact"). K_out_7.txt showed 12 of 13
// occurrences of this exact plain fast/slow trigger produced NO real SDR
// movement at all (+/-4Hz), while the one that DID coincide with real
// movement (-38Hz/+8Hz) was numerically indistinguishable from the other
// 12 by before/after/delta alone. Recording the energy-weighted reading
// at the same two instants (trigger, and post-capture-close) lets every
// FUTURE auto-capture answer "was this one real" from its own printout,
// without needing a coincidentally-timed manual 'H' press the way this
// correction had to rely on.
static float    s_slow_trigger_energy_before_hz = 0.0f;   // energy_weighted_fast_hz() at the trigger instant
static float    s_slow_trigger_energy_after_hz = 0.0f;    // energy_weighted_fast_hz() once post capture completes

// 2026-09-12, yet later still: a SECOND, much-longer-timescale companion
// to the fine (1.25ms/bin) trace above - added after TWO consecutive real
// (non-boot-artifact) 'K' captures, one user-flagged "[] scan induced"
// and one flagged "spontaneous," BOTH came back showing a perfectly
// steady, non-drifting repeating cycle throughout their entire 50ms
// pre+50ms post window, with no visible transition anywhere - despite a
// genuine 8-11Hz fast/slow EMA gap having triggered them. If the signal
// were truly unchanging for as long as it's been running, a periodic
// waveform this regular (both EMAs' cutoffs sit far below the ~200Hz
// cycle-repeat rate) should long since have pulled BOTH EMAs to within
// a fraction of a Hz of the true periodic mean - an 8-11Hz gap that
// persists despite a locally flat 100ms window is best explained by a
// REAL change that happened, and fully resolved, on a timescale longer
// than 50ms but shorter than the slow EMA's ~2s memory - i.e. a
// continuous drift too gradual to show any visible slope over 50ms, but
// fast enough to separate a 50ms average from a 2s one. (Direct
// precedent: the +3.85 capture, this file's first genuinely real one,
// already showed this project's cycle mean drifting continuously over
// its own 50ms window - this is the same phenomenon at whatever slower
// rate applies at THIS delay/pair, now inferred rather than directly
// seen because it's too slow for the fine trace to resolve.)
//
// Rather than growing the fine trace's own span to multiple seconds
// (expensive - RAM and, more so, print volume - and it would just push
// the same "still not long enough" edge case further out), this instead
// periodically snapshots the two EMAs THEMSELVES (not raw bin data) over
// a much longer horizon (EMA_TREND_LEN samples, EMA_TREND_SAMPLE_TICKS
// apart) - directly answering "was fast/slow already diverging smoothly
// over the last couple of seconds" without needing fine per-tick detail
// over that whole span. Freezes the same way the pre-bin ring does -
// simply stops advancing once state leaves WATCHING - rather than an
// explicit copy-out.
#define EMA_TREND_LEN 80              // 80 samples
#define EMA_TREND_SAMPLE_TICKS 400    // 25ms/sample @ 16kHz -> 2s of total history,
                                       // matching FREQ_EMA_SLOW_TAU_S itself
static float    s_trend_fast_hz[EMA_TREND_LEN];
static float    s_trend_slow_hz[EMA_TREND_LEN];
static uint32_t s_trend_write_idx = 0;
static uint32_t s_trend_fill = 0;
static uint32_t s_trend_tick_count = 0;

// 2026-09-15: 'H' - a second, independent detector alongside the slow_trace
// ('K') one above, built after the user pointed out a real gap in that
// design: they're watching the ACTUAL output on an SDR and reporting cases
// where it visibly jumps and then SITS at the new frequency for a long
// time (their own example: "-22Hz, been there a while") - and 'K' can't
// reliably see this. 'K' only fires on FAST-vs-SLOW divergence, and its
// own re-arm deliberately resyncs slow to fast every time a trace is read
// (see print_and_rearm_slow_trace()'s own comment for why - avoiding a
// re-trigger storm). That means if fast and slow ever drift down TOGETHER
// slowly enough to never re-open a 5Hz gap between EACH OTHER, 'K' goes
// completely silent - even while sitting at a value far from where this
// whole run actually started, for as long as that lasts. This can't be
// fixed by tuning 'K' - it needs a comparison against something that
// never gets resynced.
//
// s_freq_anchor_hz is that something: a single fixed reference, snapped
// ONCE from the fast EMA at the exact same instant 'K's own slow EMA gets
// its one-time boot-settle snap (see FREQ_EMA_BOOT_SETTLE_TICKS above) -
// i.e. "where this run's signal actually settled once fully warmed up" -
// and then NEVER touched again for the rest of the boot, unlike slow_hz
// which resyncs on every 'K' read. Comparing the fast EMA against this
// permanent anchor, rather than against the self-resyncing slow EMA,
// answers a genuinely different question: not "did anything just change"
// (K's job) but "is the output currently sitting somewhere different from
// where it started, and has it been there a while" - exactly what the
// user is asking to detect.
//
// HELD_TRIGGER_HZ, 2026-09-15 UPDATE (same day, before any bench build of
// this went out): originally set to 10Hz on the reasoning that a bigger
// bar than SLOW_JUMP_TRIGGER_HZ (5Hz) would help keep this from re-firing
// on ordinary K-style jump-then-revert cycles. That reasoning turned out
// to be solving the wrong half of the problem - the very next real-world
// report the user sent ("-13 to +8, still sitting at +8") describes a
// held state at only ~8Hz off nominal, which a 10Hz bar would have missed
// entirely, defeating the whole point of this detector for exactly the
// case it was built for. The actual, already-working defense against
// re-firing on ordinary reverting jumps is HELD_MIN_DURATION_MS (below) -
// those revert within single-digit seconds regardless of MAGNITUDE (see
// K_out_1/2/3.txt's bin-level evidence), so a 15s continuous-duration
// requirement already filters them out at any reasonable magnitude
// threshold. There was never a good reason for HELD_TRIGGER_HZ to be
// bigger than SLOW_JUMP_TRIGGER_HZ's own 5Hz - that number is ALREADY the
// user's own independently-established visual-read perceptual floor (see
// SLOW_JUMP_TRIGGER_HZ's own declaration comment), so reusing it directly
// here means "anything the user could actually notice, if it's still
// there 15 seconds later" - which is exactly what this detector should
// mean. Changed 10Hz -> 5Hz.
//
// Unlike the fine (1.24ms/bin) slow_trace ring, the rolling trace here
// (HELD_TRACE_LEN samples, HELD_TRACE_SAMPLE_MS apart) runs CONTINUOUSLY
// at all times (not armed/frozen around a trigger) - a small always-on
// flight recorder of the actual tx_freq (the literal integer Hz value
// sent to the AD9851 - see diagnostics_set_tx_info()'s own declaration
// comment on tx_freq being ground truth) alongside the fast EMA, coarse
// enough to cover HELD_TRACE_LEN*HELD_TRACE_SAMPLE_MS/1000 seconds of
// history - long enough to show whatever lead-up happened before a held
// event is confirmed, and (per the user's own report of seeing an actual
// multi-second SDR "trail" on some but not most jumps) coarse enough not
// to mistake normal FFT/waterfall exponential-average smoothing on their
// display for a real multi-second DSP-side transition - this trace is of
// the real tx_freq value itself, nothing exponentially averaged on top of
// it.
#define HELD_TRIGGER_HZ 5.0f
#define HELD_MIN_DURATION_MS 15000.0f
#define HELD_TRACE_SAMPLE_MS 500.0f       // 2 samples/sec
#define HELD_TRACE_LEN 120                // 120 * 500ms = 60s of rolling history
#define HELD_REANNOUNCE_MS 30000.0f       // heartbeat cadence while still held
static const uint32_t HELD_TRACE_SAMPLE_TICKS =
    (uint32_t)(HELD_TRACE_SAMPLE_MS * 1000.0f / (float)SSB_SAMPLE_PERIOD_US);

static float    s_freq_anchor_hz = 0.0f;
static bool     s_freq_anchor_inited = false;

static uint32_t s_held_tx_freq[HELD_TRACE_LEN];
static float    s_held_fast_hz[HELD_TRACE_LEN];

// 2026-09-16, later still: added directly in response to the
// log_20260916_122436.txt held_trace phantom-tx_freq finding
// (null_bias_investigation.md) - a ~8000Hz "phantom" tx_freq reading, sustained
// for a full ~153.6s cycle, that the corruption canary, fast/slow, and the SDR
// all agreed never really happened. Leading theory: an occasional skipped/
// double-counted DSP tick shifts held_trace's own sampling phase (it's
// exactly-multiple-aliased to the two-tone period already) onto a more
// extreme point of the periodic waveform. These three are simple per-sample
// SNAPSHOTS of the existing, already-tested cumulative counters
// (s_dbg_overrun_count/s_dbg_late_tick_count/s_dbg_max_busy_us -
// diagnostics_record_phase_timings()/diagnostics_record_tick_start() above) -
// deliberately not new accumulation/reset logic of their own, to avoid adding
// a second novel mechanism right where we're hunting for one. Since each is
// monotonically non-decreasing, a step between two consecutive printed
// samples in print_held_trace() pinpoints exactly which 500ms bin saw a real
// DSP-timing hiccup - if one lines up with the next tx_freq phantom episode's
// onset/recovery, that confirms the tick-slip theory outright.
static uint32_t s_held_overrun_count[HELD_TRACE_LEN];
static uint32_t s_held_late_tick_count[HELD_TRACE_LEN];
static uint32_t s_held_max_busy_us[HELD_TRACE_LEN];
static uint32_t s_held_trace_write_idx = 0;
static uint32_t s_held_trace_fill = 0;
static uint32_t s_held_trace_tick_count = 0;

static volatile bool     s_held_active = false;      // |fast-anchor| currently over threshold
static volatile bool     s_held_confirmed = false;    // active for >= HELD_MIN_DURATION_MS
static volatile uint32_t s_held_started_ms = 0;
static volatile uint32_t s_held_last_reannounce_ms = 0;
static volatile float    s_held_last_dev_hz = 0.0f;
static volatile uint32_t s_held_last_tx_freq = 0;

// Set by the hot path (diagnostics_set_tx_info(), below), cleared by
// diagnostics_check_held_freq() (Core 1, called from diagnostics_service() -
// same unconditional/mute-exempt pattern as diagnostics_check_slow_trace_
// auto_dump() and canary_check_background()). "pending" flags rather than
// printing directly from the hot path, same reasoning as every other
// diagnostic in this file: no Serial calls on the real-time task.
static volatile bool s_held_pending_confirm = false;
static volatile bool s_held_pending_reannounce = false;
static volatile bool s_held_pending_recovery = false;
static volatile uint32_t s_held_pending_recovery_duration_ms = 0;

// 2026-09-16, later same day: energy-weighted's own "held" detector -
// same structure as s_held_active etc. just above, built directly off
// this date's correction (null_bias_investigation.md, "the recurring
// ~153.6s rise/recovery pattern is very likely a plain-EMA null-noise
// artifact"): 12 of 13 plain-EMA slow-jump triggers in K_out_7.txt
// produced no real SDR movement at all, so the plain fast/anchor pair
// above can no longer be trusted alone to mean "something real is
// happening." This tracks the SAME kind of sustained-deviation condition
// but against s_freq_energy_anchor_hz / energy_weighted_fast_hz()
// instead - the quantity that DID match the SDR to within 0.4Hz on its
// one real bench test (K_out_6.txt, -38.37Hz vs -38Hz). Deliberately
// reuses HELD_TRIGGER_HZ/HELD_MIN_DURATION_MS/HELD_REANNOUNCE_MS rather
// than inventing new untuned constants - split them later if bench data
// shows the energy-weighted case needs different numbers.
static volatile bool     s_energy_held_active = false;
static volatile bool     s_energy_held_confirmed = false;
static volatile uint32_t s_energy_held_started_ms = 0;
static volatile uint32_t s_energy_held_last_reannounce_ms = 0;
static volatile float    s_energy_held_last_dev_hz = 0.0f;

static volatile bool s_energy_held_pending_confirm = false;
static volatile bool s_energy_held_pending_reannounce = false;
static volatile bool s_energy_held_pending_recovery = false;
static volatile uint32_t s_energy_held_pending_recovery_duration_ms = 0;
#endif

static volatile uint32_t s_dbg_max_busy_us = 0;
static volatile uint32_t s_dbg_overrun_count = 0;
static const uint32_t k_sample_period_us = SSB_SAMPLE_PERIOD_US;

// WAKE-UP jitter - distinct from s_dbg_max_busy_us above, which only
// measures how long dsp_task's OWN work takes once it resumes. This
// measures the actual observed gap between successive ulTaskNotifyTake()
// returns - i.e. was dsp_task woken up ON TIME, regardless of how fast
// its own processing was. A task can have comfortable busy_us margin
// every single tick and STILL be intermittently woken late (preempted,
// scheduling delay, etc.) - that wouldn't show up in busy_us at all, but
// would still starve anything timing-sensitive that assumes a strictly
// periodic tick, like the ADC FIFO drain rate.
static volatile uint32_t s_dbg_max_tick_gap_us = 0;      // worst observed inter-tick gap
static volatile uint32_t s_dbg_late_tick_count = 0;      // ticks where the gap exceeded 1.5x nominal

// 2026-09-19: latest snapshot of ssb_mic_test.ino's own s_stale_commit_count
// (AD9851_ISR_WRITE_ENABLED's staging-race counter) - see
// diagnostics_record_isr_stale_commits()/diagnostics.h for why this is a
// plain overwrite, not reset by diagnostics_reset(). Zero-initialized here
// so the [timing] line reads a sane 0 even before AD9851_ISR_WRITE_ENABLED
// is compiled in (config.h's own #error guards keep it in sync otherwise).
static volatile uint32_t s_dbg_isr_stale_commit_count = 0;

// "Is that long [core1]/[timing]/[adc]/[dsp] print block sent in one go?"
// - yes, from the CPU's side: print_timing_and_adc_block() below is ~10
// back-to-back Serial.printf() calls with no yield in between, so it's one
// uninterrupted burst of loop()-context code every ~1s. Whether that maps
// to one blocking USB-CDC transaction depends on driver/buffer internals
// we can't see from here (and if Serial.printf's underlying write ever
// takes a portENTER_CRITICAL-style path while the buffer's full, that
// would mask interrupts up to gptimer's own intr_priority=3 level for
// however long it blocks - structurally the same contention mechanism the
// ADC ISR fix addressed, just via USB/Serial instead of the ADC driver).
// s_core1_busy_diag_us (below) already sums this block's cost, but only
// as a percentage of a 1s window - an occasional multi-ms stall could be
// hiding inside a small-looking average. This tracks the WORST single
// call instead, to catch that directly. Same single-writer-from-Core-1
// reasoning as the other diag statics - only ever touched from
// diagnostics_service()'s own context (print, measure, and reset all run
// on Core 1), no lock needed.
static volatile uint32_t s_dbg_max_diag_block_us = 0;   // worst single print_timing_and_adc_block() call

// CONFIRMED on real hardware: max_single_call_us came back at 5041 - a
// 5ms+ stall, once/sec, on Core 1 (the same core gptimer's alarm ISR runs
// on). That's ~80 sample periods' worth of time in one call - more than
// enough on its own to explain the observed pin5 bad edges, whether the
// mechanism is literal interrupt masking during a blocked USB-CDC write,
// or something else in that path. Root cause of the block itself (why
// Serial.printf() would stall that long) is presumably the host not
// draining the USB-CDC endpoint promptly - plausibly WORSE while you're
// actively typing (terminal app busy handling keystrokes/redraws instead
// of servicing the port), which fits the "correlates with serial
// activity" observation even though this specific block fires on a timer,
// not on keypresses. Fix: never let a diagnostic print block for that
// long - see diag_room_for() (just above print_status_line()) for the
// per-line guard this settled on, after a first attempt (one upfront
// check for the whole ~1.5KB block) turned out to be miscalibrated - real
// hardware showed availableForWrite() never reporting anywhere near that
// much free even at rest (avail=162 observed), so that version skipped
// EVERY cycle rather than just genuinely backlogged ones.
static volatile uint32_t s_dbg_diag_block_skip_count = 0;   // individual lines skipped by diag_room_for()

// Phase breakdown of the same total: which part of dsp_task's work is
// actually costing the most.
static volatile uint32_t s_dbg_max_adc_us = 0;
static volatile uint32_t s_dbg_max_dsp_us = 0;
static volatile uint32_t s_dbg_max_write_us = 0;

static int64_t s_dsp_tick_start_us = 0;         // captured once at gptimer_start(), and again on reset
static volatile uint32_t s_dbg_dsp_tick_count = 0;  // incremented once per dsp_task tick, unconditionally

static volatile bool s_diag_muted = false;

// 2026-09-09: canary latches for the random-TX-jump investigation (see
// moving_forward_notes.md) - 0 means "never seen a mismatch since boot/
// reset", any other value is the esp_timer millis() timestamp of the FIRST
// mismatch seen, kept even if a later read happens to match again (a
// glitch this fast could conceivably self-correct on a later corruption
// event before anyone looks) - same high-water-mark philosophy as
// s_dbg_max_busy_us etc. elsewhere in this file.
static volatile uint32_t s_dbg_canary_carrier_bad_since_ms = 0;
static volatile uint32_t s_dbg_canary_ftw_bad_since_ms = 0;

// 2026-09-11: same latch pattern, extended to the IIR filters' own
// feedback state (see ssb_dsp_get_iir_canary()/envelope_gdeq_get_canary()/
// envelope_ampeq_get_canary()/adc_capture_get_lpf_canary()'s doc comments,
// and moving_forward_notes.md's matching entry, for why these specifically
// - unlike freq_dev_hz/phase, which are recomputed fresh every tick, an
// IIR filter's own y1/y2/z1/z2/env state can carry a bad (NaN/Inf) value
// forward indefinitely once introduced). One latch per MODULE rather than
// per individual float/stage - keeps this list from growing to nine
// separate high-water marks for what would functionally be "the same
// canary, checked in five different places"; canary_print_status() names
// exactly which sub-state was bad when it prints the detail, the latch
// timestamp itself doesn't need that granularity.
static volatile uint32_t s_dbg_canary_eq_bad_since_ms = 0;
static volatile uint32_t s_dbg_canary_comp_bad_since_ms = 0;
static volatile uint32_t s_dbg_canary_gdeq_bad_since_ms = 0;
static volatile uint32_t s_dbg_canary_ampeq_bad_since_ms = 0;
static volatile uint32_t s_dbg_canary_adclpf_bad_since_ms = 0;

// Core 1 headroom - see the Fs jitter hunt's crosscore-wake finding: the
// ~1us->6us stretch on gptimer's notify-from-ISR call only happens when
// dsp_task was genuinely blocked, and is the cost of the crosscore IPI
// needed to wake a Core-0-pinned task from a Core-1 ISR. The structural
// fix (co-locate the ISR and the task on one core) already crashed once
// moving the TIMER onto Core 0, which had zero spare CPU. This
// measurement is what cleared the mirror option - moving dsp_task itself
// onto Core 1 - as worth trying instead of guessing blind: once delay(10)
// was correctly attributed (see diagnostics_record_core1_loop_timings()'s
// header comment), Core 1 (hosting loop(), Serial/USB CDC,
// adc_capture_service(), and the ADC's own on_conv_done ISR) turned out
// to be sitting ~98-99% idle, not the ~3% the uncorrected idle-hook
// reading suggested - comfortable headroom by the CPU-time math for
// dsp_task's own ~45-75% duty cycle. TRIED anyway, REVERTED: real
// hardware starved Serial completely (output AND commands, not just
// delayed) despite that headroom - so CPU-time budget alone isn't the
// whole story for whatever makes this core-sharing arrangement fail; see
// the .ino's "TRIED, REVERTED" note on dsp_task's xTaskCreatePinnedToCore()
// call. dsp_task is back on Core 0; this idle/breakdown reading is still
// the right one to watch if that mirror option gets revisited once the
// actual starvation mechanism is understood.
//
// esp_register_freertos_idle_hook_for_cpu() calls core1_idle_hook() every
// time IDLE1 actually gets scheduled - i.e. only when Core 1 genuinely
// has nothing else ready to run (idle priority is the lowest there is,
// so nothing here can preempt real work). Delta-sum-with-threshold: the
// gap between two consecutive calls is either IDLE1's own tight-loop
// overhead (small, uninterrupted - genuine idle time, count it) or
// something else ran on Core 1 in between (large gap - NOT idle, must be
// excluded rather than mis-counted as spare budget). The threshold just
// needs to sit comfortably above the hook's own call-to-call overhead
// (expected well under 1us) and comfortably below any real task/ISR
// activity worth caring about.
//
// Both statics are touched ONLY from Core 1 (the hook itself, and the
// [core1] print/reset below, both run on Core 1 - the hook can never
// preempt the print since idle is the lowest priority) - no lock needed,
// same single-core-ownership reasoning as the ADC FIFO's head/tail split.
#define CORE1_IDLE_GAP_THRESHOLD_US 10
static uint64_t s_core1_idle_us_accum = 0;
static int64_t  s_core1_idle_last_call_us = 0;
static bool     s_core1_idle_hook_registered = false;

// Threshold-free cross-check on the idle% accounting above: a plain
// count of every hook call, no gap filtering at all. CORE1_IDLE_GAP_
// THRESHOLD_US was a guess, not calibrated against this actual hardware/
// IDF build - if idle% ever comes back suspiciously low (can't be
// explained by the other measured categories), a call rate that's also
// very low corroborates "Core 1 really is that busy"; a call rate that's
// still substantial while idle_us reads low would instead point at the
// threshold itself silently discarding real idle gaps that are just
// wider than 10us (e.g. if IDLE1's own per-iteration housekeeping on
// this IDF version costs more than assumed).
static uint32_t s_core1_idle_hook_calls = 0;

// Core 1 BREAKDOWN - "where does that ~96-97% busy time actually go".
// Sums (not high-water marks - see diagnostics_record_core1_loop_timings()'s
// own header comment for why), one per loop() sub-call, plus idle above.
// Same single-core-ownership reasoning as the idle accumulator - only
// ever touched from Core 1 (loop()'s own context), no lock needed.
static uint64_t s_core1_busy_cmd_us     = 0;   // handle_serial_commands()
static uint64_t s_core1_busy_adc_svc_us = 0;   // adc_capture_service()
static uint64_t s_core1_busy_diag_us    = 0;   // diagnostics_service() itself (mostly the
                                                // throttled [timing]/[adc]/[dsp] printf block)
static uint64_t s_core1_busy_delay_us   = 0;   // loop()'s own delay(10) - see
                                                // diagnostics_record_core1_loop_timings()'s
                                                // header comment for why this one bucket
                                                // turned out to explain the whole "other"
                                                // mystery

// esp_freertos_idle_cb_t is bool(*)(void), not void(*)(void) - confirmed
// on real hardware (this project's exact esp32s3-libs build rejected the
// void signature outright, -fpermissive error). Return value isn't ours
// to interpret here - this hook is just accumulating a measurement, not
// influencing idle-task behavior (light sleep, WDT feeding, etc., which
// are handled elsewhere) - true is the safe, do-nothing-special choice.
static bool IRAM_ATTR core1_idle_hook(void)
{
    s_core1_idle_hook_calls++;   // unconditional - the threshold-free cross-check, see its own comment
    int64_t now = esp_timer_get_time();
    if (s_core1_idle_last_call_us != 0) {
        int64_t gap = now - s_core1_idle_last_call_us;
        if (gap > 0 && gap <= CORE1_IDLE_GAP_THRESHOLD_US) {
            s_core1_idle_us_accum += (uint64_t)gap;
        }
    }
    s_core1_idle_last_call_us = now;
    return true;
}

void IRAM_ATTR diagnostics_record_tick_start(int64_t t_start_us)
{
    s_dbg_dsp_tick_count++;   // unconditional - counts real elapsed ticks regardless of mode

    // Measured first thing each tick, so it reflects the true wake-up-to-
    // wake-up gap rather than anything downstream.
    static int64_t s_last_tick_start_us = 0;
    if (s_last_tick_start_us != 0) {
        uint32_t gap_us = (uint32_t)(t_start_us - s_last_tick_start_us);
        if (gap_us > s_dbg_max_tick_gap_us) s_dbg_max_tick_gap_us = gap_us;
        if (gap_us > (k_sample_period_us + k_sample_period_us / 2)) s_dbg_late_tick_count++;
    }
    s_last_tick_start_us = t_start_us;
}

void IRAM_ATTR diagnostics_record_phase_timings(uint32_t adc_us, uint32_t dsp_us,
                                                 uint32_t write_us, uint32_t busy_us)
{
    if (adc_us   > s_dbg_max_adc_us)   s_dbg_max_adc_us   = adc_us;
    if (dsp_us   > s_dbg_max_dsp_us)   s_dbg_max_dsp_us   = dsp_us;
    if (write_us > s_dbg_max_write_us) s_dbg_max_write_us = write_us;
    if (busy_us  > s_dbg_max_busy_us)  s_dbg_max_busy_us  = busy_us;
    if (busy_us  > k_sample_period_us) s_dbg_overrun_count++;
}

void diagnostics_record_core1_loop_timings(uint32_t cmd_us, uint32_t adc_svc_us,
                                            uint32_t diag_us, uint32_t delay_us)
{
    s_core1_busy_cmd_us     += cmd_us;
    s_core1_busy_adc_svc_us += adc_svc_us;
    s_core1_busy_diag_us    += diag_us;
    s_core1_busy_delay_us   += delay_us;
}

void IRAM_ATTR diagnostics_set_envelope_freqdev(float envelope, float freq_dev_hz)
{
    s_dbg_envelope = envelope;
    s_dbg_freq_dev = freq_dev_hz;
}

void IRAM_ATTR diagnostics_set_tx_info(float delayed_freq_dev_hz, float delayed_envelope,
                                        float envelope_at_freq_time, float envelope_at_freq_time_min,
                                        float raw_freq_dev_near, float raw_freq_dev_far,
                                        float raw_freq_dev_current, float raw_envelope_current,
                                        uint32_t tx_freq)
{
#if AD9851_ATTACHED
    s_dbg_delayed_freq_dev = delayed_freq_dev_hz;
    s_dbg_tx_freq = tx_freq;
    (void)delayed_envelope;   // stored nowhere - NOT time-matched to delayed_freq_dev_hz once delay
                              // is nonzero (see relative_delay.h) - envelope_at_freq_time below is
                              // the correct pairing, and is what the energy-weighted EMA now uses.

    // 2026-09-17: 'F' full-rate freq/env capture - see
    // diagnostics_freqenv_capture_arm()'s declaration comment (diagnostics.h)
    // for the full design. No-op unless armed; a plain length check when not
    // armed, so this costs essentially nothing on the hot path otherwise.
    freqenv_capture_tick(raw_freq_dev_current, raw_envelope_current);

    // 2026-09-12, yet later still: slow-mean trigger - see its declaration
    // comment (this file, just above the struct/statics it uses) for the
    // full "the horse has bolted, and it's not even close" motivation.
    // Runs unconditionally every tick, independent of the >300Hz-step
    // jump log below and of s_dbg_have_prev_tx_freq (this doesn't need a
    // "previous tick" in that sense - the EMAs seed themselves from the
    // very first sample).
    {
        float dev = delayed_freq_dev_hz;

        // 2026-09-16: post-delay energy weighting for the SAME dev/tick -
        // see s_freq_ema_energy_num_fast's declaration comment above for
        // the full story (completes the 2026-09-12 "post-delay null_bias
        // variant" proposal). env2 uses envelope_at_freq_time specifically
        // (time-matched to dev), not delayed_envelope.
        float env_at_freq = envelope_at_freq_time;
        float env2 = env_at_freq * env_at_freq;

        // 2026-09-16, later still: raw-envelope-paired companion - see
        // s_freq_ema_rawenergy_num_fast's declaration comment above.
        float raw_env2 = raw_envelope_current * raw_envelope_current;

        if (!s_freq_ema_fast_inited) {
            // Fast EMA seeds from the first-ever raw sample, same as
            // before - but its own short tau converges it to the true
            // running average within a few tens of ms regardless of how
            // far off that raw seed was (see FREQ_EMA_BOOT_SETTLE_MS's
            // declaration comment). This starts the boot-settle countdown
            // that decides when slow is allowed to snap from it.
            s_freq_ema_fast_hz = dev;
            s_freq_ema_fast_inited = true;
            s_freq_ema_boot_settle_ticks_left = FREQ_EMA_BOOT_SETTLE_TICKS;
            // Energy-weighted numerator/denominator seed the same tick,
            // from the same raw sample - same convergence reasoning as
            // the plain fast EMA (short tau washes out a bad seed fast).
            s_freq_ema_energy_num_fast = env2 * dev;
            s_freq_ema_energy_den_fast = env2;
            s_freq_ema_rawenergy_num_fast = raw_env2 * raw_freq_dev_current;
            s_freq_ema_rawenergy_den_fast = raw_env2;
        } else {
            s_freq_ema_fast_hz += FREQ_EMA_FAST_ALPHA * (dev - s_freq_ema_fast_hz);
            s_freq_ema_energy_num_fast += FREQ_EMA_FAST_ALPHA * (env2 * dev - s_freq_ema_energy_num_fast);
            s_freq_ema_energy_den_fast += FREQ_EMA_FAST_ALPHA * (env2 - s_freq_ema_energy_den_fast);
            s_freq_ema_rawenergy_num_fast += FREQ_EMA_FAST_ALPHA * (raw_env2 * raw_freq_dev_current - s_freq_ema_rawenergy_num_fast);
            s_freq_ema_rawenergy_den_fast += FREQ_EMA_FAST_ALPHA * (raw_env2 - s_freq_ema_rawenergy_den_fast);
        }

        if (!s_freq_ema_slow_inited) {
            // Slow EMA deliberately does NOT update from raw samples
            // during this window - it has nothing valid to converge from
            // yet. Once the boot-settle countdown reaches zero, fast has
            // had ~10 of its own time constants to converge from
            // whatever the raw seed was - snap slow to that, a clean
            // transfer instead of a raw single-sample seed, then arm the
            // short residual warmup before the trigger check is trusted.
            if (s_freq_ema_boot_settle_ticks_left > 0) s_freq_ema_boot_settle_ticks_left--;
            if (s_freq_ema_boot_settle_ticks_left == 0) {
                s_freq_ema_slow_hz = s_freq_ema_fast_hz;
                s_freq_ema_slow_inited = true;
                s_freq_ema_warmup_ticks_left = FREQ_EMA_WARMUP_TICKS;
            }
        } else {
            s_freq_ema_slow_hz += FREQ_EMA_SLOW_ALPHA * (dev - s_freq_ema_slow_hz);
            if (s_freq_ema_warmup_ticks_left > 0) s_freq_ema_warmup_ticks_left--;
        }

        // Long-timescale EMA trend ring - see its own declaration comment
        // (this file, near jump_log_entry_t) for why. Deliberately keyed
        // off SLOW_TRACE_WATCHING AND slow being initialized, same
        // freeze-by-stop-writing pattern as the fine pre-bin ring just
        // below, so it holds exactly the run-up to whichever trigger just
        // fired, and never records a meaningless pre-snap slow value.
        if (s_slow_trace_state == SLOW_TRACE_WATCHING && s_freq_ema_slow_inited) {
            s_trend_tick_count++;
            if (s_trend_tick_count >= EMA_TREND_SAMPLE_TICKS) {
                s_trend_tick_count = 0;
                s_trend_fast_hz[s_trend_write_idx] = s_freq_ema_fast_hz;
                s_trend_slow_hz[s_trend_write_idx] = s_freq_ema_slow_hz;
                s_trend_write_idx = (s_trend_write_idx + 1) % EMA_TREND_LEN;
                if (s_trend_fill < EMA_TREND_LEN) s_trend_fill++;
            }
        }

        if (s_slow_trace_state != SLOW_TRACE_LATCHED) {
            s_slow_bin_sum_freq += dev;
            if (envelope_at_freq_time < s_slow_bin_min_env) s_slow_bin_min_env = envelope_at_freq_time;
            s_slow_bin_count++;

            if (s_slow_bin_count >= SLOW_TRACE_BIN_TICKS) {
                slow_trace_bin_t bin;
                bin.freq_mean_hz = s_slow_bin_sum_freq / (float)s_slow_bin_count;
                bin.env_min = s_slow_bin_min_env;
                s_slow_bin_sum_freq = 0.0f;
                s_slow_bin_min_env = 1e9f;
                s_slow_bin_count = 0;

                if (s_slow_trace_state == SLOW_TRACE_WATCHING) {
                    s_slow_pre_ring[s_slow_pre_write_idx] = bin;
                    s_slow_pre_write_idx = (s_slow_pre_write_idx + 1) % SLOW_TRACE_PRE_BINS;
                    if (s_slow_pre_fill < SLOW_TRACE_PRE_BINS) s_slow_pre_fill++;

                    // Trigger check held off until slow is actually
                    // initialized (the boot-settle snap, see
                    // FREQ_EMA_BOOT_SETTLE_TICKS) AND the short residual
                    // warmup since then has elapsed (FREQ_EMA_WARMUP_TICKS)
                    // - see both constants' declaration comments for the
                    // two-stage false-positive history this replaced. The
                    // pre-ring above keeps filling throughout regardless,
                    // so real history is already available the moment the
                    // hold lifts.
                    float delta = s_freq_ema_fast_hz - s_freq_ema_slow_hz;
                    if (delta < 0.0f) delta = -delta;
                    if (s_freq_ema_slow_inited && s_freq_ema_warmup_ticks_left == 0
                        && delta > SLOW_JUMP_TRIGGER_HZ) {
                        s_slow_trigger_at_ms = (uint32_t)(esp_timer_get_time() / 1000);
                        s_slow_trigger_before_hz = s_freq_ema_slow_hz;
                        s_slow_trigger_delta_hz = s_freq_ema_fast_hz - s_freq_ema_slow_hz;
                        s_slow_trigger_relative_delay = relative_delay_get_samples();
                        s_slow_trigger_delay_change_ms = relative_delay_get_last_change_ms();
                        // 2026-09-16, later same day: see s_slow_trigger_energy_before_hz's
                        // declaration comment - the "was this one real" companion reading.
                        s_slow_trigger_energy_before_hz = energy_weighted_fast_hz();
                        s_slow_post_fill = 0;
                        s_slow_trace_state = SLOW_TRACE_CAPTURING_POST;
                    }
                } else {   // SLOW_TRACE_CAPTURING_POST
                    if (s_slow_post_fill < SLOW_TRACE_POST_BINS) {
                        s_slow_post_bins[s_slow_post_fill++] = bin;
                    }
                    if (s_slow_post_fill >= SLOW_TRACE_POST_BINS) {
                        s_slow_trigger_after_hz = s_freq_ema_fast_hz;
                        s_slow_trigger_energy_after_hz = energy_weighted_fast_hz();
                        s_slow_trace_state = SLOW_TRACE_LATCHED;
                    }
                }
            }
        }
    }

    // 2026-09-15: 'H' held-frequency detector - see its statics' own
    // declaration comment (above, near s_freq_anchor_hz) for the full
    // motivation. Anchor snaps once, at the exact same instant slow_hz
    // gets its own one-time boot-settle snap just above - by that point
    // fast_hz has had ~10 of its own time constants to converge from
    // whatever the raw boot seed was (see FREQ_EMA_BOOT_SETTLE_TICKS),
    // same reasoning slow_hz's own snap already relies on.
    if (!s_freq_anchor_inited && s_freq_ema_slow_inited) {
        s_freq_anchor_hz = s_freq_ema_fast_hz;
        s_freq_anchor_inited = true;
    }

    // 2026-09-16, later same day: energy-weighted's own anchor - see
    // s_freq_energy_anchor_hz's declaration comment for why this can't
    // reuse s_freq_anchor_hz above. Same boot-settle instant, same
    // reasoning (fast/energy-weighted have each had ~10 of their own time
    // constants to converge by here). Guarded by MIN_ENERGY_DEN the same
    // way the getter below is - seeding from a near-zero-energy ratio at
    // boot (e.g. RF not yet enabled) would latch a meaningless anchor.
    if (!s_freq_energy_anchor_inited && s_freq_ema_slow_inited
        && s_freq_ema_energy_den_fast >= MIN_ENERGY_DEN) {
        s_freq_energy_anchor_hz = s_freq_ema_energy_num_fast / s_freq_ema_energy_den_fast;
        s_freq_energy_anchor_inited = true;
    }

    // 2026-09-16, later still: same seeding, same instant, for the raw-
    // envelope-paired sibling anchor - see its declaration comment.
    if (!s_freq_rawenergy_anchor_inited && s_freq_ema_slow_inited
        && s_freq_ema_rawenergy_den_fast >= MIN_ENERGY_DEN) {
        s_freq_rawenergy_anchor_hz = s_freq_ema_rawenergy_num_fast / s_freq_ema_rawenergy_den_fast;
        s_freq_rawenergy_anchor_inited = true;
    }

    // Always-on rolling flight recorder of the real tx_freq/fast_hz -
    // independent of held-state, so history is already available the
    // instant a held event is confirmed (see this block's declaration
    // comment on why this is continuous, not armed-on-trigger like
    // slow_trace's fine bins).
    s_held_trace_tick_count++;
    if (s_held_trace_tick_count >= HELD_TRACE_SAMPLE_TICKS) {
        s_held_trace_tick_count = 0;
        s_held_tx_freq[s_held_trace_write_idx] = tx_freq;
        s_held_fast_hz[s_held_trace_write_idx] = s_freq_ema_fast_hz;
        // Cumulative-since-last-'r'-reset snapshots - see s_held_overrun_count's
        // declaration comment for why these aren't per-bin deltas.
        s_held_overrun_count[s_held_trace_write_idx] = s_dbg_overrun_count;
        s_held_late_tick_count[s_held_trace_write_idx] = s_dbg_late_tick_count;
        s_held_max_busy_us[s_held_trace_write_idx] = s_dbg_max_busy_us;
        s_held_trace_write_idx = (s_held_trace_write_idx + 1) % HELD_TRACE_LEN;
        if (s_held_trace_fill < HELD_TRACE_LEN) s_held_trace_fill++;
    }

    if (s_freq_anchor_inited) {
        float adev = s_freq_ema_fast_hz - s_freq_anchor_hz;
        if (adev < 0.0f) adev = -adev;
        uint32_t now_ms = (uint32_t)(esp_timer_get_time() / 1000);

        if (adev > HELD_TRIGGER_HZ) {
            if (!s_held_active) {
                s_held_active = true;
                s_held_started_ms = now_ms;
                s_held_confirmed = false;
            }
            s_held_last_dev_hz = s_freq_ema_fast_hz - s_freq_anchor_hz;
            s_held_last_tx_freq = tx_freq;

            if (!s_held_confirmed && (now_ms - s_held_started_ms) >= (uint32_t)HELD_MIN_DURATION_MS) {
                s_held_confirmed = true;
                s_held_last_reannounce_ms = now_ms;
                s_held_pending_confirm = true;
            } else if (s_held_confirmed
                       && (now_ms - s_held_last_reannounce_ms) >= (uint32_t)HELD_REANNOUNCE_MS) {
                s_held_last_reannounce_ms = now_ms;
                s_held_pending_reannounce = true;
            }
        } else {
            if (s_held_active) {
                if (s_held_confirmed) {
                    s_held_pending_recovery_duration_ms = now_ms - s_held_started_ms;
                    s_held_pending_recovery = true;
                }
                s_held_active = false;
                s_held_confirmed = false;
            }
        }
    }

    // 2026-09-16, later same day: energy-weighted's own held check - see
    // s_energy_held_active's declaration comment for the full motivation.
    // Same structure as the plain block just above, against
    // s_freq_energy_anchor_hz/energy_weighted_fast_hz() instead of
    // s_freq_anchor_hz/s_freq_ema_fast_hz. Deliberately a separate,
    // independent state machine - a real event might move one without
    // the other (that's the whole point after today's correction), so
    // this must be able to confirm/recover on its own schedule.
    if (s_freq_energy_anchor_inited) {
        float edev = energy_weighted_fast_hz() - s_freq_energy_anchor_hz;
        float edev_abs = (edev < 0.0f) ? -edev : edev;
        uint32_t enow_ms = (uint32_t)(esp_timer_get_time() / 1000);

        if (edev_abs > HELD_TRIGGER_HZ) {
            if (!s_energy_held_active) {
                s_energy_held_active = true;
                s_energy_held_started_ms = enow_ms;
                s_energy_held_confirmed = false;
            }
            s_energy_held_last_dev_hz = edev;

            if (!s_energy_held_confirmed
                && (enow_ms - s_energy_held_started_ms) >= (uint32_t)HELD_MIN_DURATION_MS) {
                s_energy_held_confirmed = true;
                s_energy_held_last_reannounce_ms = enow_ms;
                s_energy_held_pending_confirm = true;
            } else if (s_energy_held_confirmed
                       && (enow_ms - s_energy_held_last_reannounce_ms) >= (uint32_t)HELD_REANNOUNCE_MS) {
                s_energy_held_last_reannounce_ms = enow_ms;
                s_energy_held_pending_reannounce = true;
            }
        } else {
            if (s_energy_held_active) {
                if (s_energy_held_confirmed) {
                    s_energy_held_pending_recovery_duration_ms = enow_ms - s_energy_held_started_ms;
                    s_energy_held_pending_recovery = true;
                }
                s_energy_held_active = false;
                s_energy_held_confirmed = false;
            }
        }
    }

    // See s_dbg_max_freq_dev_step_hz's own declaration comment. tx_freq is
    // this tick's ground-truth Hz value (carrier_output.h's own doc
    // comment) - comparing it against last tick's value catches any
    // one-tick digital discontinuity directly, no matter which upstream
    // stage (freq_dev_hz, the delay line, or the carrier addition) it came
    // from. esp_timer_get_time() (not millis()) since this runs on the
    // dsp_task hot path - it's the IRAM-safe, ISR-callable timer read this
    // codebase already relies on elsewhere.
    if (s_dbg_have_prev_tx_freq) {
        int32_t step = (int32_t)tx_freq - (int32_t)s_dbg_prev_tx_freq;
        uint32_t abs_step = (step < 0) ? (uint32_t)(-step) : (uint32_t)step;
        if (abs_step > s_dbg_max_freq_dev_step_hz) {
            s_dbg_max_freq_dev_step_hz = abs_step;
            s_dbg_max_freq_dev_step_from_hz = s_dbg_prev_tx_freq;
            s_dbg_max_freq_dev_step_to_hz = tx_freq;
            s_dbg_max_freq_dev_step_at_ms = (uint32_t)(esp_timer_get_time() / 1000);
            // Re-arm the post-step trace - see its declaration comment
            // above. fill=0 first, then the unconditional capture just
            // below runs this same call, so trace[0] ends up holding THIS
            // tick's (the post-jump) tx_freq value.
            s_dbg_freq_step_trace_fill = 0;
            s_dbg_freq_step_trace_armed = true;
        }
        if (s_dbg_freq_step_trace_armed) {
            s_dbg_freq_step_trace_envelope[s_dbg_freq_step_trace_fill] = envelope_at_freq_time;
            s_dbg_freq_step_trace[s_dbg_freq_step_trace_fill++] = tx_freq;
            if (s_dbg_freq_step_trace_fill >= FREQ_STEP_TRACE_LEN) {
                s_dbg_freq_step_trace_armed = false;
            }
        }

        // 2026-09-12: per-event jump log - see its declaration comment
        // (top of file) for full rationale. Deliberately independent of,
        // and a lower bar than, the "new all-time record" gate above, so
        // ordinary RECURRING jumps get captured too, not just a single
        // once-per-run worst case. busy_us isn't known yet at this point
        // in the tick - stashed as "pending" and finalized a few lines
        // later in ssb_mic_test.ino by diagnostics_record_jump_busy_us(),
        // once this tick's busy_us has actually been computed.
        if (abs_step > JUMP_LOG_THRESHOLD_HZ) {
            s_jump_pending_entry.at_ms = (uint32_t)(esp_timer_get_time() / 1000);
            s_jump_pending_entry.from_hz = s_dbg_prev_tx_freq;
            s_jump_pending_entry.to_hz = tx_freq;
            s_jump_pending_entry.step_hz = abs_step;
            s_jump_pending_entry.envelope = envelope_at_freq_time;
            s_jump_pending_entry.envelope_min = envelope_at_freq_time_min;
            s_jump_pending_entry.relative_delay_samples = relative_delay_get_samples();
            s_jump_pending_entry.audio_source = (uint8_t)dsp_state_get_audio_source();
            s_jump_pending_entry.raw_freq_dev_near = raw_freq_dev_near;
            s_jump_pending_entry.raw_freq_dev_far = raw_freq_dev_far;
            {
                float thr = ssb_dsp_get_null_bias_threshold(dsp_state_get_ssb());
                s_jump_pending_entry.near_null_blended = (envelope_at_freq_time < thr);
                s_jump_pending_entry.near_null_either  = (envelope_at_freq_time_min < thr);
            }
            s_jump_pending_entry.busy_us = 0;   // filled in shortly - see above
            s_jump_pending = true;
        }
    }
    s_dbg_prev_tx_freq = tx_freq;
    s_dbg_have_prev_tx_freq = true;
#else
    (void)delayed_freq_dev_hz;
    (void)delayed_envelope;
    (void)envelope_at_freq_time;
    (void)envelope_at_freq_time_min;
    (void)raw_freq_dev_near;
    (void)raw_freq_dev_far;
    (void)tx_freq;
#endif
}

void IRAM_ATTR diagnostics_record_jump_busy_us(uint32_t busy_us)
{
#if AD9851_ATTACHED
    // No-op on every ordinary tick - only ever true in the same tick
    // diagnostics_set_tx_info() just flagged a qualifying jump, a few
    // lines earlier in ssb_mic_test.ino. dsp_task runs single-threaded per
    // tick, so there's no re-entrancy risk between the two calls.
    if (!s_jump_pending) return;
    s_jump_pending_entry.busy_us = busy_us;
    s_jump_log[s_jump_log_write_idx] = s_jump_pending_entry;
    s_jump_log_write_idx = (s_jump_log_write_idx + 1) % JUMP_LOG_LEN;
    s_jump_log_count++;
    if (s_jump_pending_entry.near_null_blended) s_jump_log_near_null_blended_count++;
    if (s_jump_pending_entry.near_null_either)  s_jump_log_near_null_either_count++;
    s_jump_pending = false;
#else
    (void)busy_us;
#endif
}

// 2026-09-19: see diagnostics.h's own comment - plain latest-value
// overwrite, not an accumulator (ssb_mic_test.ino's s_stale_commit_count is
// the real, monotonic, un-reset counter; this is just its most recent
// value for the periodic print). IRAM_ATTR because it's called once per
// full tick from dsp_task (itself IRAM_ATTR) - matches every other
// function dsp_task calls, even though this one's own body is just a
// single volatile store.
void IRAM_ATTR diagnostics_record_isr_stale_commits(uint32_t stale_commit_count)
{
    s_dbg_isr_stale_commit_count = stale_commit_count;
}

void diagnostics_print_jump_log(void)
{
#if AD9851_ATTACHED
    uint32_t n = (s_jump_log_count < JUMP_LOG_LEN) ? s_jump_log_count : JUMP_LOG_LEN;
    // Two near-null percentages, deliberately - see near_null_blended/
    // near_null_either's declaration comments (jump_log_entry_t above) and
    // relative_delay.h's out_envelope_at_freq_time_min comment for why a
    // lopsided fractional delay can make these read very differently, and
    // why "either" (not just "blended") is the more complete answer to
    // "did a near-null sample contribute to this jump at all".
    Serial.printf("[dsp] jump_log: %u qualifying step(s) >%uHz since last reset, %u near-null-blended (%.0f%%), "
                  "%u near-null-either (%.0f%%) - ring holds the last %u\r\n",
                  s_jump_log_count, (unsigned)JUMP_LOG_THRESHOLD_HZ,
                  s_jump_log_near_null_blended_count,
                  s_jump_log_count ? (100.0f * (float)s_jump_log_near_null_blended_count / (float)s_jump_log_count) : 0.0f,
                  s_jump_log_near_null_either_count,
                  s_jump_log_count ? (100.0f * (float)s_jump_log_near_null_either_count / (float)s_jump_log_count) : 0.0f,
                  n);
    if (n == 0) return;

    // If the ring hasn't wrapped yet (count < LEN), the oldest entry is
    // simply index 0. Once it has wrapped, the oldest SURVIVING entry is
    // whatever the write index is about to overwrite next.
    uint32_t start = (s_jump_log_count < JUMP_LOG_LEN) ? 0 : s_jump_log_write_idx;
    for (uint32_t k = 0; k < n; k++) {
        jump_log_entry_t *e = &s_jump_log[(start + k) % JUMP_LOG_LEN];
        // env=.../... precision bumped %.3f->%.6e alongside the K trace's
        // env_min fix just above (same reasoning: these values live well
        // below 3 decimal places' resolution and were printing as an
        // uninformative flat 0.000/0.001 regardless of true null depth).
        Serial.printf("[dsp]   jump[%u]: t=%ums %u->%uHz (step=%uHz) env=%.6e/%.6e%s%s delay=%+.2f "
                      "busy_us=%u src=%s\r\n",
                      (unsigned)k, e->at_ms, e->from_hz, e->to_hz, e->step_hz, e->envelope, e->envelope_min,
                      e->near_null_blended ? " NEAR_NULL" : "",
                      (e->near_null_either && !e->near_null_blended) ? " NEAR_NULL(either)" : "",
                      e->relative_delay_samples, e->busy_us,
                      audio_source_name(e->audio_source));
        // 2026-09-12, later same day: the two RAW (undelayed) freq_dev_hz
        // values this event's delayed step was interpolated from, plus
        // their own delta - see diagnostics_set_tx_info()'s declaration
        // comment (diagnostics.h) for why. A raw_delta close to step_hz
        // means the discontinuity already exists in the raw signal (a real
        // event, just not one the envelope-near-null test flags); a
        // raw_delta much smaller than step_hz means this was mostly an
        // interpolation artifact from blending across a large lag.
        float raw_delta = e->raw_freq_dev_near - e->raw_freq_dev_far;
        if (raw_delta < 0.0f) raw_delta = -raw_delta;
        Serial.printf("[dsp]     jump[%u] raw_freq_dev: near=%.1fHz far=%.1fHz raw_delta=%.1fHz\r\n",
                      (unsigned)k, e->raw_freq_dev_near, e->raw_freq_dev_far, raw_delta);
    }
#endif
}

// 2026-09-15: shared body for "a latched slow_trace is ready - print it in
// full and re-arm", factored out of diagnostics_print_slow_trace() below so
// the exact same print+rearm logic can be driven from two different places:
// the 'K' keypress (manual, unchanged) and diagnostics_service() (automatic,
// new - see diagnostics_check_slow_trace_auto_dump() just below this
// function). Added after the user asked to "leave it running" unattended and
// have the big hands-off jumps (their own examples: -50Hz, +20Hz, apparently
// instantaneous) land in the log on their own, rather than needing to notice
// one had fired and type 'K' before it got read. Nothing about the capture
// logic itself changes - a trigger still safely LATCHES and holds
// indefinitely until read (see s_slow_trace_state's own declaration
// comment), so no data was ever at risk of being lost waiting for a
// keypress; this purely removes the keypress from the loop. label
// distinguishes "TRIGGERED" (found via 'K') from "AUTO-CAPTURED" (found by
// diagnostics_service() on its own) in the printed header line, so a saved
// serial log makes plain which path produced each dump - useful since a
// human watching live can still hit 'K' at basically the same moment the
// auto-dump would have fired anyway; whichever gets there first prints it
// once (this function always re-arms before returning), the other then just
// sees SLOW_TRACE_WATCHING and has nothing to do.
#if AD9851_ATTACHED
static void print_and_rearm_slow_trace(const char *label)
{
    Serial.printf("[dsp] slow_trace: %s at t=%ums before=%.2fHz after=%.2fHz delta=%+.2fHz "
                  "delay=%+.2f - %u pre-bin(s) + %u post-bin(s), %.2fms/bin\r\n",
                  label,
                  s_slow_trigger_at_ms, s_slow_trigger_before_hz, s_slow_trigger_after_hz,
                  s_slow_trigger_delta_hz, s_slow_trigger_relative_delay,
                  s_slow_pre_fill, s_slow_post_fill,
                  (double)((float)(SLOW_TRACE_BIN_TICKS * SSB_SAMPLE_PERIOD_US) / 1000.0f));

    // 2026-09-16, later same day: the "was this one real" companion line -
    // see s_slow_trigger_energy_before_hz's declaration comment. anchor_dev
    // is the after-reading's own deviation from the energy-weighted
    // anchor (s_freq_energy_anchor_hz) - the number to actually judge
    // against the SDR, the same quantity 'H's energy-weighted line prints.
    // A plain-EMA trigger with a small anchor_dev here is the K_out_7.txt
    // signature of a null-noise artifact; a large one is the signature a
    // real event should leave.
    Serial.printf("[dsp]   energy_weighted before=%.2fHz after=%.2fHz anchor=%.2fHz anchor_dev=%+.2fHz\r\n",
                  s_slow_trigger_energy_before_hz, s_slow_trigger_energy_after_hz,
                  s_freq_energy_anchor_hz, s_slow_trigger_energy_after_hz - s_freq_energy_anchor_hz);

    // 2026-09-12, yet later still: correlates this trigger against the
    // user's own recent '['/']'/preset actions - see
    // relative_delay_get_last_change_ms()'s declaration comment
    // (relative_delay.h) for why. A 0 reading means no delay change has
    // ever been recorded this boot (nothing to correlate against).
    if (s_slow_trigger_delay_change_ms != 0) {
        int32_t since_ms = (int32_t)s_slow_trigger_at_ms - (int32_t)s_slow_trigger_delay_change_ms;
        Serial.printf("[dsp]   relative_delay was last changed %dms before this trigger\r\n",
                      (int)since_ms);
    } else {
        Serial.printf("[dsp]   relative_delay has not been changed since boot\r\n");
    }

    // Oldest-surviving-entry math mirrors diagnostics_print_jump_log()'s
    // own ring-read logic just above. Bin indices are printed relative to
    // the trigger (negative = before, the LAST pre-bin - index -1 - is the
    // bin where the delta first crossed threshold; positive = after).
    uint32_t start = (s_slow_pre_fill < SLOW_TRACE_PRE_BINS) ? 0 : s_slow_pre_write_idx;
    int32_t first_label = -(int32_t)s_slow_pre_fill;
    for (uint32_t k = 0; k < s_slow_pre_fill; k++) {
        slow_trace_bin_t *b = &s_slow_pre_ring[(start + k) % SLOW_TRACE_PRE_BINS];
        bool is_last_pre = (k == s_slow_pre_fill - 1);
        // 2026-09-15, later still: env_min's print precision bumped from
        // %.3f to %.6e here and in the post-bin loop just below. The user
        // directly observed (scope on the envelope waveform, not this log)
        // that the null's actual depth visibly varies over time, and
        // suspected it correlates with which cycles trigger 'K' - but
        // every env_min this whole session has printed as a flat "0.001"
        // regardless of how deep the null actually was, because the real
        // values live well below 3 decimal places' resolution (this
        // signal's nulls are typically several orders of magnitude below
        // 1.0). That's not "the null is always exactly 0.001" - it's this
        // printf silently discarding the one piece of data that would
        // confirm or refute the user's own hypothesis. Scientific notation
        // instead of a fixed decimal count so this stays informative
        // whether the true minimum is ~1e-3 or ~1e-6.
        Serial.printf("[dsp]   slow_trace[%+4d]: freq=%.1fHz env_min=%.6e%s\r\n",
                      (int)(first_label + (int32_t)k), b->freq_mean_hz, b->env_min,
                      is_last_pre ? " <-- TRIGGER (delta first exceeded threshold here)" : "");
    }
    for (uint32_t k = 0; k < s_slow_post_fill; k++) {
        slow_trace_bin_t *b = &s_slow_post_bins[k];
        Serial.printf("[dsp]   slow_trace[%+4d]: freq=%.1fHz env_min=%.6e\r\n",
                      (int)(k + 1), b->freq_mean_hz, b->env_min);
    }

    // Long-timescale EMA trend - see EMA_TREND_LEN's declaration comment
    // for why this exists. Added after two consecutive real triggers
    // showed a perfectly flat fine trace above despite a genuine
    // fast/slow gap - this shows whether that gap built up as a smooth,
    // multi-second drift (too slow for the fine trace above to resolve)
    // or something more abrupt. Same oldest-to-newest ring-read pattern
    // as the fine trace, frozen at the trigger instant the same way.
    Serial.printf("[dsp]   slow_trace TREND (last ~%.1fs, %.0fms/sample, frozen at the trigger):\r\n",
                  (double)((float)EMA_TREND_LEN * (float)EMA_TREND_SAMPLE_TICKS * (float)SSB_SAMPLE_PERIOD_US / 1000000.0f),
                  (double)((float)EMA_TREND_SAMPLE_TICKS * (float)SSB_SAMPLE_PERIOD_US / 1000.0f));
    uint32_t tstart = (s_trend_fill < EMA_TREND_LEN) ? 0 : s_trend_write_idx;
    int32_t tfirst_label = -(int32_t)s_trend_fill;
    for (uint32_t k = 0; k < s_trend_fill; k++) {
        uint32_t idx = (tstart + k) % EMA_TREND_LEN;
        Serial.printf("[dsp]     trend[%+4d]: fast=%.2fHz slow=%.2fHz\r\n",
                      (int)(tfirst_label + (int32_t)k), s_trend_fast_hz[idx], s_trend_slow_hz[idx]);
    }

    // Re-arm for the next event now that this one's been read - matches
    // this command's "read it, then watch for the next one" design (see
    // this function's own declaration comment). Resyncing slow to fast
    // avoids an immediate re-trigger storm: right after a genuine step,
    // the slow (2s-tau) EMA is still catching up to the fast one and would
    // otherwise stay >SLOW_JUMP_TRIGGER_HZ apart - and hence keep
    // re-triggering with an near-empty pre-buffer - for up to several
    // seconds after every real event. Also re-arms the warm-up hold
    // (FREQ_EMA_WARMUP_TICKS's declaration comment) - the resync above
    // uses the fast EMA's OWN value, which is only tau=50ms smoothed and
    // so can itself still be offset from the true multi-second average;
    // without this, the false-positive failure mode that motivated the
    // warm-up in the first place could recur right after every real event
    // too, just in a smaller, "re-arm bias" form instead of "boot bias."
    s_freq_ema_slow_hz = s_freq_ema_fast_hz;
    s_freq_ema_warmup_ticks_left = FREQ_EMA_WARMUP_TICKS;
    s_slow_trace_state = SLOW_TRACE_WATCHING;
    s_slow_pre_write_idx = 0;
    s_slow_pre_fill = 0;
    s_slow_bin_sum_freq = 0.0f;
    s_slow_bin_min_env = 1e9f;
    s_slow_bin_count = 0;
    s_trend_write_idx = 0;
    s_trend_fill = 0;
    s_trend_tick_count = 0;
}
#endif // AD9851_ATTACHED

// 2026-09-12, yet later still: 'K' serial command - see the slow-mean-
// trigger struct/statics' own declaration comment (above, near
// jump_log_entry_t) for the full motivation and design. Prints either a
// live "still watching" readout (nothing has crossed SLOW_JUMP_TRIGGER_HZ
// yet) or the full latched pre/post trace (it has), then re-arms for the
// next event - see the header comment for why re-arming also resyncs the
// slow EMA to the fast one.
//
// 2026-09-15: since diagnostics_check_slow_trace_auto_dump() (below) now
// drains a LATCHED trace on its own every loop() iteration, this manual
// path will usually already find SLOW_TRACE_WATCHING by the time a human
// gets to it - that's fine and expected, not a bug (see
// print_and_rearm_slow_trace()'s own comment on the two paths racing
// harmlessly). 'K' remains useful on its own for the live "still watching"
// fast/slow/delta readout, which the auto-dump deliberately never prints
// (see diagnostics_check_slow_trace_auto_dump()'s comment for why).
void diagnostics_print_slow_trace(void)
{
#if AD9851_ATTACHED
    if (s_slow_trace_state != SLOW_TRACE_LATCHED) {
        // Two distinct holds, reported separately so it's never ambiguous
        // which one (if either) is currently blocking a trigger:
        // boot-settle (slow not snapped from fast yet at all - only ever
        // nonzero once, right after boot) and the short residual warmup
        // after slow IS initialized (also re-armed after every trigger is
        // read). See FREQ_EMA_BOOT_SETTLE_TICKS/FREQ_EMA_WARMUP_TICKS's
        // declaration comments for why both exist.
        if (!s_freq_ema_slow_inited) {
            float settle_ms_left = (float)s_freq_ema_boot_settle_ticks_left * (float)SSB_SAMPLE_PERIOD_US / 1000.0f;
            Serial.printf("[dsp] slow_trace: still watching - slow EMA not yet initialized "
                          "(boot_settle_left=%.0fms, fast_ema=%.2fHz so far) pre_bins_filled=%u/%u\r\n",
                          settle_ms_left, s_freq_ema_fast_hz, s_slow_pre_fill, (unsigned)SLOW_TRACE_PRE_BINS);
            return;
        }
        float warmup_ms_left = (float)s_freq_ema_warmup_ticks_left * (float)SSB_SAMPLE_PERIOD_US / 1000.0f;
        Serial.printf("[dsp] slow_trace: still watching - fast_ema=%.2fHz slow_ema=%.2fHz "
                      "delta=%.2fHz (fires at +/-%.1fHz, warmup_left=%.0fms) pre_bins_filled=%u/%u\r\n",
                      s_freq_ema_fast_hz, s_freq_ema_slow_hz,
                      s_freq_ema_fast_hz - s_freq_ema_slow_hz, (float)SLOW_JUMP_TRIGGER_HZ, warmup_ms_left,
                      s_slow_pre_fill, (unsigned)SLOW_TRACE_PRE_BINS);
        return;
    }

    print_and_rearm_slow_trace("TRIGGERED");
#endif
}

// 2026-09-15: automatic sibling to the 'K' command above - added directly in
// response to the user's request ("Can you automatically dump the K tables
// when a jump is triggered and captured. I can then just leave it running
// and see what we get over time") after they reported several apparently-
// instantaneous hands-off jumps (their own examples: -50Hz, +20Hz) that
// they weren't at the keyboard to catch with 'K' before something else
// might eventually have overwritten the context (in practice nothing does -
// see s_slow_trace_state's own comment, a LATCHED trace already holds
// indefinitely - but the user still had to notice and act in time, which a
// hands-off bench run defeats entirely). Called from diagnostics_service()
// (Core 1, once per loop() iteration - see that function) so a captured
// trace prints itself within one loop() cycle (worst case ~10ms, the
// delay(10) at the end of loop() - see diagnostics_record_core1_loop_timings()'s
// own comment on that delay) of the post-window actually filling, with no
// keypress needed at all. Deliberately mirrors canary_check_background()'s
// existing pattern just below in diagnostics_service(): an unconditional,
// mute-EXEMPT, checked-every-call function that costs nothing (one enum
// comparison) until the rare tick where there's actually something to do -
// a real jump landing in the log matters more than whether 'v' happens to
// be muted, and 'K' itself has always ignored the mute flag too.
//
// Deliberately does NOT print anything when s_slow_trace_state is WATCHING
// or CAPTURING_POST - only ever fires on the LATCHED transition, exactly
// once per event (this function's own call to print_and_rearm_slow_trace()
// immediately re-arms back to WATCHING, so the next call this same
// millisecond sees nothing left to do). This is why it can safely run every
// single loop() iteration without flooding Serial the way printing the
// "still watching" live readout unconditionally would - that live readout
// remains 'K'-only, on purpose, for exactly this reason.
static void diagnostics_check_slow_trace_auto_dump(void)
{
#if AD9851_ATTACHED
    if (s_slow_trace_state == SLOW_TRACE_LATCHED) {
        print_and_rearm_slow_trace("AUTO-CAPTURED");
    }
#endif
}

#if AD9851_ATTACHED
// 2026-09-15: dumps the always-on rolling tx_freq/fast_hz trace - see
// s_held_tx_freq's own declaration comment for why this ring is
// continuous rather than armed-on-trigger. Shared by the auto "just
// confirmed held" print, the manual 'H' command, and (for symmetry) could
// be called from a recovery print too, though recovery deliberately keeps
// its own print short (the trace at that point is dominated by the now-
// finished held episode, not fresh information) - see
// diagnostics_check_held_freq() below.
static void print_held_trace(void)
{
    uint32_t start = (s_held_trace_fill < HELD_TRACE_LEN) ? 0 : s_held_trace_write_idx;
    int32_t first_label = -(int32_t)s_held_trace_fill;
    for (uint32_t k = 0; k < s_held_trace_fill; k++) {
        uint32_t idx = (start + k) % HELD_TRACE_LEN;
        // overruns/late/max_busy_us are cumulative-since-'r'-reset snapshots
        // (see s_held_overrun_count's declaration comment) - since each is
        // monotonically non-decreasing, a step between one line and the next
        // pinpoints exactly which 500ms bin saw a real DSP-timing hiccup.
        Serial.printf("[dsp]   held_trace[%+5d]: tx_freq=%luHz fast=%.2fHz overruns=%lu late=%lu max_busy_us=%lu\r\n",
                      (int)(first_label + (int32_t)k),
                      (unsigned long)s_held_tx_freq[idx], s_held_fast_hz[idx],
                      (unsigned long)s_held_overrun_count[idx],
                      (unsigned long)s_held_late_tick_count[idx],
                      (unsigned long)s_held_max_busy_us[idx]);
    }
}
#endif

// 2026-09-15: Core 1 side of the 'H' held-frequency detector - called
// unconditionally from diagnostics_service() every loop() iteration, same
// mute-exempt "cheap until there's actually something to do" pattern as
// diagnostics_check_slow_trace_auto_dump()/canary_check_background() just
// above/below it. Three independent one-shot flags, set by the hot path
// (diagnostics_set_tx_info()) and cleared here - a confirm print (fires
// once, HELD_MIN_DURATION_MS after the deviation first crossed
// HELD_TRIGGER_HZ), a periodic reannounce heartbeat (every
// HELD_REANNOUNCE_MS while still confirmed-held, so a very long episode
// doesn't go silent and leave it ambiguous whether it's still stuck or
// quietly recovered unnoticed), and a recovery print (fires once, the
// instant |fast-anchor| drops back under threshold after having been
// confirmed) reporting the total duration. See s_freq_anchor_hz's own
// declaration comment for the full motivation and why this is a
// genuinely different question from 'K's own fast-vs-slow trigger.
static void diagnostics_check_held_freq(void)
{
#if AD9851_ATTACHED
    if (s_held_pending_confirm) {
        s_held_pending_confirm = false;
        uint32_t confirmed_at_ms = (uint32_t)(esp_timer_get_time() / 1000);
        // 2026-09-15, later same day: timestamps added throughout this
        // function and diagnostics_print_held_status() below, in direct
        // response to the user's "shame the H output is not timestamped"
        // observation - without an absolute t= to compare against, a K
        // trace's own t= (see print_and_rearm_slow_trace()'s "at t=%ums")
        // and an 'H' read couldn't be lined up precisely, which mattered a
        // lot for judging whether a suspected measurement gap was a real
        // blind spot or just an unmeasured delay between eyeballing the
        // SDR and typing the command. started_at is when the deviation
        // FIRST crossed HELD_TRIGGER_HZ (comparable to a K trigger's own
        // "at t="); confirmed_at is when this message actually printed
        // (started_at + HELD_MIN_DURATION_MS, modulo scheduling jitter).
        Serial.printf("[dsp] held_freq: CONFIRMED STUCK - fast_ema has been %+.2fHz from this run's "
                      "anchor (%.2fHz) for >=%.0fs (started_at t=%ums, confirmed_at t=%ums). "
                      "tx_freq=%luHz fast=%.2fHz\r\n",
                      s_held_last_dev_hz, s_freq_anchor_hz, (double)(HELD_MIN_DURATION_MS / 1000.0f),
                      s_held_started_ms, confirmed_at_ms,
                      (unsigned long)s_held_last_tx_freq, s_freq_anchor_hz + s_held_last_dev_hz);
        print_held_trace();
    }
    if (s_held_pending_reannounce) {
        s_held_pending_reannounce = false;
        uint32_t now_ms = (uint32_t)(esp_timer_get_time() / 1000);
        uint32_t held_s = (now_ms - s_held_started_ms) / 1000;
        Serial.printf("[dsp] held_freq: still stuck, %us so far (t=%ums) - dev=%+.2fHz from "
                      "anchor=%.2fHz tx_freq=%luHz\r\n",
                      (unsigned)held_s, now_ms, s_held_last_dev_hz, s_freq_anchor_hz,
                      (unsigned long)s_held_last_tx_freq);
    }
    if (s_held_pending_recovery) {
        s_held_pending_recovery = false;
        uint32_t now_ms = (uint32_t)(esp_timer_get_time() / 1000);
        Serial.printf("[dsp] held_freq: RECOVERED at t=%ums - was stuck %.1fs total (anchor=%.2fHz)\r\n",
                      now_ms, (double)((float)s_held_pending_recovery_duration_ms / 1000.0f),
                      s_freq_anchor_hz);
    }

    // 2026-09-16, later same day: energy-weighted's own confirm/reannounce/
    // recovery prints - see s_energy_held_active's declaration comment.
    // Mirrors the three prints above exactly, labeled ENERGY-WEIGHTED so a
    // saved log makes plain which detector fired - this one is the number
    // to trust against the SDR after today's correction, so a
    // plain-only CONFIRMED STUCK above with no matching one here is itself
    // the signature of a null-noise artifact rather than a real event.
    if (s_energy_held_pending_confirm) {
        s_energy_held_pending_confirm = false;
        uint32_t confirmed_at_ms = (uint32_t)(esp_timer_get_time() / 1000);
        Serial.printf("[dsp] held_freq: ENERGY-WEIGHTED CONFIRMED STUCK - energy_weighted fast has been "
                      "%+.2fHz from its own anchor (%.2fHz) for >=%.0fs (started_at t=%ums, "
                      "confirmed_at t=%ums) - compare against the SDR now.\r\n",
                      s_energy_held_last_dev_hz, s_freq_energy_anchor_hz,
                      (double)(HELD_MIN_DURATION_MS / 1000.0f),
                      s_energy_held_started_ms, confirmed_at_ms);

        // 2026-09-16, later still: direct, same-instant comparison against
        // ssb_dsp.c's OWN env2-weighted lifetime accumulator
        // (ssb_dsp_get_null_bias_stats(), pre-dating this session, already
        // confirmed accurate to a few Hz against the SDR across 6/6 tone
        // pairs - see null_bias_investigation.md's "Confirmed measurement
        // table"). That accumulator pairs env2 with dphi at the exact same
        // raw tick, straight out of ssb_dsp_process_sample() - the raw
        // sqrtf(I*I+Q*Q) envelope, never touched by ampeq/gdeq/predistort/
        // the PWM offset-scale mapping. This session's own fast energy-
        // weighted EMA above instead weights by envelope_at_freq_time - the
        // POST-shaping envelope captured downstream in
        // diagnostics_set_tx_info(), chosen earlier this session for being
        // correctly TIME-matched to dev across the relative_delay ring, but
        // never checked against whether shaping (ampeq/gdeq are both IIR,
        // predistort is a LUT) also changes the envelope's VALUE right at a
        // null the way a plain index-delay wouldn't. Printing both at the
        // identical instant is the direct test: the validated accumulator
        // is a lifetime average (needs a long-run reading to mean much on
        // its own), but if this fast EMA's own claimed dev is real, the
        // lifetime one should at least be trending the same direction and
        // nowhere near a stable few-Hz reading; if the lifetime one stays
        // small/stable while this one claims tens of Hz, that's the
        // opposite envelope signal turning out to matter after all.
        {
            ssb_dsp_null_bias_stats_t nb_stats;
            ssb_dsp_get_null_bias_stats(dsp_state_get_ssb(), &nb_stats);
            float weighted_mean_hz = (nb_stats.env2_sum > 0.0f)
                ? (nb_stats.env2_dphi_sum / nb_stats.env2_sum) * SAMPLE_RATE_HZ / 6.28318530718f
                : 0.0f;
            float expected_center_hz = 0.5f * (test_signals_get_twotone_f1_hz() + test_signals_get_twotone_f2_hz());
            Serial.printf("[dsp]   cross-check: ssb_dsp.c's own raw env2-weighted lifetime average = "
                          "%.2fHz (bias from expected_center=%.2fHz: %+.2fHz, %lu samples since last 'r') "
                          "- validated-accurate reference, see null_bias_investigation.md\r\n",
                          weighted_mean_hz, expected_center_hz, weighted_mean_hz - expected_center_hz,
                          (unsigned long)nb_stats.dphi_sample_count);
        }

        // 2026-09-16, later still: THIRD number at the same instant - the
        // new raw-envelope-paired fast EMA (s_freq_ema_rawenergy_num_fast/
        // den_fast, same 50ms tau as the shaped-envelope one above, just a
        // different envelope). Unlike the lifetime accumulator just
        // printed, this one updates live and should be directly comparable
        // in RESPONSIVENESS to the (suspect) shaped-envelope fast EMA - the
        // decisive three-way read: if this stays close to its own anchor
        // while the shaped one above claims tens of Hz, the shaped
        // envelope is confirmed as the whole session's culprit; if this
        // ALSO swings by a similar amount, the pairing wasn't the (whole)
        // story and pre-delay vs. post-delay or something else needs a
        // look next.
        Serial.printf("[dsp]   cross-check2: raw-envelope-paired fast EMA (same tau, correct same-tick "
                      "pairing) = %.2fHz, dev from its own anchor (%.2fHz): %+.2fHz\r\n",
                      rawenergy_weighted_fast_hz(), s_freq_rawenergy_anchor_hz,
                      rawenergy_weighted_fast_hz() - s_freq_rawenergy_anchor_hz);
        print_held_trace();
    }
    if (s_energy_held_pending_reannounce) {
        s_energy_held_pending_reannounce = false;
        uint32_t now_ms = (uint32_t)(esp_timer_get_time() / 1000);
        uint32_t held_s = (now_ms - s_energy_held_started_ms) / 1000;
        Serial.printf("[dsp] held_freq: ENERGY-WEIGHTED still stuck, %us so far (t=%ums) - dev=%+.2fHz "
                      "from anchor=%.2fHz\r\n",
                      (unsigned)held_s, now_ms, s_energy_held_last_dev_hz, s_freq_energy_anchor_hz);
    }
    if (s_energy_held_pending_recovery) {
        s_energy_held_pending_recovery = false;
        uint32_t now_ms = (uint32_t)(esp_timer_get_time() / 1000);
        Serial.printf("[dsp] held_freq: ENERGY-WEIGHTED RECOVERED at t=%ums - was stuck %.1fs total "
                      "(anchor=%.2fHz)\r\n",
                      now_ms, (double)((float)s_energy_held_pending_recovery_duration_ms / 1000.0f),
                      s_freq_energy_anchor_hz);
    }
#endif
}

// 2026-09-15: 'H' serial command - on-demand status/trace read, mirroring
// 'K's own "still watching" vs. latched-content split. Purely a read -
// unlike 'K' it doesn't re-arm or reset anything (there is nothing to
// re-arm: the anchor is a permanent, once-only reference by design, and
// the rolling trace keeps running regardless of whether anyone reads it).
// 2026-09-16: 'H' helper - see s_freq_ema_energy_num_fast's declaration
// comment (this file, near s_freq_ema_fast_hz) for the full story. Ratio
// of two EMAs, guarded against a near-zero denominator (sustained
// near-total envelope silence - very early boot, or a genuinely
// unmodulated/silent carrier) by falling back to the plain fast EMA rather
// than dividing by ~0: a energy-weighted read needs SOME transmitted power
// behind it to mean anything.
static float energy_weighted_fast_hz(void)
{
#if AD9851_ATTACHED
    if (s_freq_ema_energy_den_fast < MIN_ENERGY_DEN) {
        return s_freq_ema_fast_hz;
    }
    return s_freq_ema_energy_num_fast / s_freq_ema_energy_den_fast;
#else
    return 0.0f;
#endif
}

// 2026-09-16, later still: raw-envelope-paired sibling of
// energy_weighted_fast_hz() just above - see s_freq_ema_rawenergy_num_fast's
// declaration comment for what makes it different (raw, pre-shaping,
// pre-delay envelope/dev instead of the shaped, post-delay pair). Same
// near-zero-denominator fallback, same reasoning.
static float rawenergy_weighted_fast_hz(void)
{
#if AD9851_ATTACHED
    if (s_freq_ema_rawenergy_den_fast < MIN_ENERGY_DEN) {
        return s_freq_ema_fast_hz;
    }
    return s_freq_ema_rawenergy_num_fast / s_freq_ema_rawenergy_den_fast;
#else
    return 0.0f;
#endif
}

void diagnostics_print_held_status(void)
{
#if AD9851_ATTACHED
    // 2026-09-15, later same day: t= added to both branches below - see the
    // long comment in diagnostics_check_held_freq() above for why. This is
    // the timestamp of THIS read (when the 'H' command was actually
    // processed), directly comparable to a K trace's own "at t=%ums" so a
    // manual 'H' can be lined up against nearby K events precisely instead
    // of relying on how quickly the two happened to print relative to each
    // other in the serial stream.
    uint32_t read_at_ms = (uint32_t)(esp_timer_get_time() / 1000);
    if (!s_freq_anchor_inited) {
        Serial.printf("[dsp] held_freq: t=%ums anchor not yet set (waiting for boot-settle)\r\n",
                      read_at_ms);
        return;
    }
    if (!s_held_active) {
        Serial.printf("[dsp] held_freq: t=%ums not currently held - anchor=%.2fHz fast=%.2fHz "
                      "dev=%+.2fHz (fires if |dev|>%.1fHz for >=%.0fs)\r\n",
                      read_at_ms, s_freq_anchor_hz, s_freq_ema_fast_hz,
                      s_freq_ema_fast_hz - s_freq_anchor_hz,
                      (double)HELD_TRIGGER_HZ, (double)(HELD_MIN_DURATION_MS / 1000.0f));
    } else {
        uint32_t elapsed_s = (read_at_ms - s_held_started_ms) / 1000;
        Serial.printf("[dsp] held_freq: t=%ums currently %s (started_at t=%ums, %us so far) - "
                      "anchor=%.2fHz fast=%.2fHz dev=%+.2fHz tx_freq=%luHz\r\n",
                      read_at_ms, s_held_confirmed ? "CONFIRMED STUCK" : "deviated, not yet confirmed",
                      s_held_started_ms, (unsigned)elapsed_s, s_freq_anchor_hz, s_freq_ema_fast_hz,
                      s_held_last_dev_hz, (unsigned long)s_held_last_tx_freq);
    }
    // 2026-09-16, later same day: energy-weighted companion read - see
    // s_freq_ema_energy_num_fast's declaration comment for the full story.
    // CORRECTED same day, first bench test: dev is now measured against
    // s_freq_energy_anchor_hz (this quantity's OWN boot-settle baseline),
    // not the plain-EMA anchor above - comparing an energy-weighted mean
    // against a plain-mean anchor produced a large, static, meaningless
    // "dev" (+410Hz on the very first bench read) that had nothing to do
    // with any real event; see s_freq_energy_anchor_hz's declaration
    // comment for why the two anchors can't be shared. Falls back to
    // "not yet set" the same way the plain line above does, since the
    // energy-weighted anchor can seed slightly later than the plain one
    // (it additionally requires MIN_ENERGY_DEN worth of transmitted power,
    // not just slow's own boot-settle).
    if (!s_freq_energy_anchor_inited) {
        Serial.printf("[dsp] held_freq: t=%ums energy_weighted anchor not yet set "
                      "(waiting for transmitted energy)\r\n", read_at_ms);
    } else {
        Serial.printf("[dsp] held_freq: t=%ums energy_weighted anchor=%.2fHz fast=%.2fHz dev=%+.2fHz "
                      "(compare THIS against the SDR - see null_bias_investigation.md 2026-09-16)\r\n",
                      read_at_ms, s_freq_energy_anchor_hz, energy_weighted_fast_hz(),
                      energy_weighted_fast_hz() - s_freq_energy_anchor_hz);
    }
    print_held_trace();
#endif
}

// Owned by the [adc] 1-second rate print below; needs to survive a
// diagnostics_reset() so the very next print after a reset doesn't
// compute a bogus huge delta against stale pre-reset values.
static uint32_t s_last_samples_total = 0;
static uint32_t s_last_callback_count = 0;
static uint32_t s_last_rate_print_ms = 0;

void diagnostics_reset(void)
{
    s_dbg_max_busy_us = 0;
    s_dbg_overrun_count = 0;
    s_dbg_max_adc_us = 0;
    s_dbg_max_dsp_us = 0;
    s_dbg_max_write_us = 0;
    s_dbg_max_tick_gap_us = 0;
    s_dbg_late_tick_count = 0;
    s_dbg_max_diag_block_us = 0;
    s_dbg_diag_block_skip_count = 0;
    s_dbg_dsp_tick_count = 0;
    s_dsp_tick_start_us = esp_timer_get_time();
    s_last_samples_total = 0;
    s_last_callback_count = 0;
    s_last_rate_print_ms = millis();
    s_core1_idle_us_accum = 0;
    s_core1_idle_last_call_us = 0;
    s_core1_idle_hook_calls = 0;
    s_core1_busy_cmd_us = 0;
    s_core1_busy_adc_svc_us = 0;
    s_core1_busy_diag_us = 0;
    s_core1_busy_delay_us = 0;

#if AD9851_ATTACHED
    // Reset like every other high-water mark in this file (unlike the
    // canary two entries below) - the intended use is the same "r, wait,
    // read" pattern already established for every other test in this
    // investigation (see moving_forward_notes.md), so a fresh window
    // should start at zero. s_dbg_have_prev_tx_freq=false (not just
    // zeroing s_dbg_prev_tx_freq) so the very next tick after a reset
    // isn't compared against a stale pre-reset value - same reasoning as
    // s_last_samples_total/s_last_callback_count above.
    s_dbg_max_freq_dev_step_hz = 0;
    s_dbg_max_freq_dev_step_from_hz = 0;
    s_dbg_max_freq_dev_step_to_hz = 0;
    s_dbg_max_freq_dev_step_at_ms = 0;
    s_dbg_have_prev_tx_freq = false;
    s_dbg_freq_step_trace_fill = 0;
    s_dbg_freq_step_trace_armed = false;

    // 2026-09-12: per-event jump log - same "r, wait, read" pattern as
    // every other high-water mark in this file. Deliberately NOT clearing
    // s_jump_log[]'s actual contents - stale entries just get overwritten
    // as new ones arrive after the reset, and s_jump_log_count going back
    // to 0 is what diagnostics_print_jump_log() treats as "empty".
    s_jump_log_write_idx = 0;
    s_jump_log_count = 0;
    s_jump_log_near_null_blended_count = 0;
    s_jump_log_near_null_either_count = 0;
    s_jump_pending = false;

    // 2026-09-12, yet later still: the slow-mean trigger (see its own
    // declaration comment, near jump_log_entry_t above) is deliberately
    // NOT touched here - same reasoning as the canary latches just below:
    // it exists to catch a rare, significant event, and 'r' gets pressed
    // routinely as part of normal measurement hygiene. Resetting it here
    // would risk silently discarding a captured (or capturing-in-progress)
    // event the user hasn't read yet just because they started an
    // unrelated fresh window. It only ever clears via 'K' actually
    // printing a latched trace (see diagnostics_print_slow_trace()).
#endif

    // Deliberately NOT resetting s_dbg_canary_carrier_bad_since_ms /
    // s_dbg_canary_ftw_bad_since_ms (or, as of 2026-09-11, the five IIR
    // canary latches - s_dbg_canary_eq_/_comp_/_gdeq_/_ampeq_/_adclpf_
    // bad_since_ms) here - they're meant to catch a rare, possibly
    // once-per-session event (see canary_check_background()), and this
    // reset gets called often (every 'r' keypress) as part of normal
    // day-to-day measurement hygiene. Resetting them here would mean any
    // corruption event that happened before the last 'r' silently
    // disappears the moment someone starts a fresh measurement window -
    // exactly the opposite of what a canary is for. They only ever clear
    // on reboot.
}

bool diagnostics_get_muted(void)
{
    return s_diag_muted;
}

void diagnostics_toggle_muted(void)
{
    s_diag_muted = !s_diag_muted;
    // Deliberately printed regardless of the new mute state - this
    // confirmation itself needs to always be visible, or muting silently
    // would just create a different confusing problem ("did that command
    // even register?").
    Serial.printf("-> periodic [timing]/[adc]/[dsp] diagnostics %s\r\n",
                  s_diag_muted ? "MUTED (command confirmations only)" : "resumed");
}

// 2026-09-18: separate mute for the three auto-dump watchers - see this
// flag's own doc comment in diagnostics.h (diagnostics_get_autodump_muted()/
// diagnostics_toggle_autodump_muted()) for the full rationale and the
// "detection pauses too, not just the print" caveat. Independent of
// s_diag_muted above by design - either can be on/off in any combination.
static volatile bool s_diag_autodump_muted = false;

bool diagnostics_get_autodump_muted(void)
{
    return s_diag_autodump_muted;
}

void diagnostics_toggle_autodump_muted(void)
{
    s_diag_autodump_muted = !s_diag_autodump_muted;
    // Same "always print the confirmation regardless of new state" reasoning
    // as diagnostics_toggle_muted() above.
    Serial.printf("-> auto-dump diagnostics (canary/slow_trace-auto/held_freq-auto) %s%s\r\n",
                  s_diag_autodump_muted ? "MUTED" : "resumed",
                  s_diag_autodump_muted ? " - note: detection itself pauses too while muted, "
                                          "not just the print; see diagnostics.h" : "");
}

void diagnostics_init(void)
{
    s_dsp_tick_start_us = esp_timer_get_time();

    // Core 1 headroom measurement - see core1_idle_hook()'s own comment
    // above. cpuid=1 is passed explicitly to the registration call, so
    // it doesn't matter which core calls this function itself (setup()
    // runs on Core 1 anyway, but that's incidental here).
    esp_err_t err = esp_register_freertos_idle_hook_for_cpu(core1_idle_hook, 1);
    if (err == ESP_OK) {
        s_core1_idle_hook_registered = true;
    } else {
        // Non-fatal - just means the [core1] idle% line below will
        // always read 0% instead of a real measurement. Printed once
        // here rather than failing silently, since a 0% reading could
        // otherwise be mistaken for "genuinely no spare CPU" instead of
        // "hook never got registered".
        Serial.printf("WARNING: Core 1 idle hook registration failed (err=%d) - "
                      "[core1] idle%% will read as 0, not a real measurement\r\n", (int)err);
    }
}

// Real hardware measurement (max_single_call_us=5041, and separately
// availableForWrite() reported avail=162 at what appears to be this
// board's normal RESTING/drained state) showed the original all-or-
// nothing "does the WHOLE ~1.5KB block fit right now" guard was wrong on
// two counts: 2048 bytes turned out to be more than this board's USB-CDC
// TX buffer ever reports free even when idle (so the guard tripped on
// EVERY cycle, not just genuinely backlogged ones - the block "never
// printing" was this threshold being unreachable, not the host actually
// falling behind), and even a lower whole-block threshold couldn't
// guarantee no blocking anyway: with a total capacity well under the
// block's ~1.5KB, filling the buffer partway through a printf still has
// to wait for the driver to drain more before the rest of that same call
// can queue - a single upfront check can't protect against that.
//
// Fix: guard EVERY individual Serial.printf() call separately, each
// against a conservative estimate of THAT line's own worst-case length -
// never asking any single call to queue more than what's already free, so
// none of them can block, regardless of how small the buffer actually is.
// The cost is a patchier print (an individual line can go missing on a
// tight cycle) rather than an all-or-nothing block - a straightforwardly
// better trade once "guarantee we can't block" is the actual goal.
static bool diag_room_for(uint32_t min_bytes)
{
    if ((uint32_t)Serial.availableForWrite() >= min_bytes) {
        return true;
    }
    s_dbg_diag_block_skip_count++;
    return false;
}

// ---------------------------------------------------------------------------
// 2026-09-17: 'F' full-rate freq/env capture - see
// diagnostics_freqenv_capture_arm()'s own declaration comment (diagnostics.h)
// for the full motivation and design. AD9851-only, like the jump
// log/slow-trace/held-freq features just above - all of it (statics,
// buffers, both helper functions, and this function's own real body) is
// wrapped below the same way s_dbg_delayed_freq_dev/s_dbg_tx_freq etc. are
// near the top of this file, so none of it exists (or costs any RAM) on a
// build without the AD9851 attached.
#if AD9851_ATTACHED
// 2026-09-17, later still: bumped 16000 -> 32000 (1.0s -> 2.0s, ~125KB ->
// ~250KB) after the user reported the actual build output for this board:
// "leaving 299220 bytes for local variables. Maximum is 327680 bytes" -
// i.e. this ESP32-S3 Super Mini has ~292KB free at link time against a
// 320KB chip, comfortably more than the original 1s buffer needed. Picked
// 2.0s rather than something closer to that whole ceiling: this pool is
// shared with every task's stack and every other library's own heap use
// at runtime (FreeRTOS task stacks, USB-CDC buffers, etc.), none of which
// show up in a link-time static-usage report, so leaving a real margin
// below 292KB is deliberate, not just cautious for its own sake. If 2.0s
// still turns out to be too much once other runtime consumers are
// accounted for, diagnostics_freqenv_capture_arm()'s existing malloc-
// failure path (below) already handles that gracefully - a real
// allocation failure just prints why and declines to arm, it doesn't
// crash - so this can be dialed back from real evidence rather than
// guessed conservatively small up front. 2.0s also directly serves the
// still-open goal from the previous two entries: enough continuous
// samples to catch 2-4 repetitions of a hypothetical ~0.485s-0.97s slip
// period in one un-interrupted window, instead of inferring it indirectly.
static const uint32_t FREQENV_CAPTURE_LEN = 32000;   // ~2.0s at 16kHz - a whole-
    // number multiple of the 1.0s SAMPLE_RATE_HZ/NCO-fix-wrap boundary (see the
    // original 16000 comment this replaced), so the captured window still
    // lines up cleanly with everything else measured today.

typedef enum {
    FREQENV_CAPTURE_IDLE = 0,     // no buffer allocated, nothing to do
    FREQENV_CAPTURE_ARMED,        // buffer allocated, filling on every dsp_task tick
    FREQENV_CAPTURE_READY,        // buffer full, waiting for diagnostics_service() to start the dump
    FREQENV_CAPTURE_DUMPING,      // dump in progress, chunked across diagnostics_service() calls
} freqenv_capture_state_t;

static volatile freqenv_capture_state_t s_freqenv_state = FREQENV_CAPTURE_IDLE;
static float *s_freqenv_freq_dev = NULL;     // lazily malloc'd, FREQENV_CAPTURE_LEN entries
static float *s_freqenv_envelope = NULL;     // lazily malloc'd, FREQENV_CAPTURE_LEN entries
static volatile uint32_t s_freqenv_write_idx = 0;   // written from dsp_task (Core 0) only
static uint32_t s_freqenv_dump_idx = 0;             // read/written from Core 1 only

// 2026-09-17, later still: the user's own external logger chokes on the
// CSV dump being interleaved with this file's other periodic/background
// Serial output (the 45ms status line, the 1000ms [timing]/[adc]/[dsp]
// block, canary_check_background(), the slow_trace/held_freq auto-dumps -
// exactly the ~192 stray non-CSV lines seen mixed into the first real
// capture, log_20260917_153446.txt). Used by diagnostics_service() to
// suppress every one of those for as long as a capture is ARMED/READY/
// DUMPING - i.e. for the capture's whole lifecycle, not just while the
// CSV itself is printing, since the status line/timing block would
// otherwise still interleave during the ~2s ARMED collection window too.
// diagnostics_freqenv_capture_service() itself is deliberately exempt
// from its own gate (it's the one thing still supposed to run) - see
// that call site in diagnostics_service() below.
static inline bool freqenv_capture_in_progress(void)
{
    return s_freqenv_state != FREQENV_CAPTURE_IDLE;
}
#endif // AD9851_ATTACHED
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
