Rich5252/Arduino_ESP32_ssb_signal_generator/settings.h

#pragma once

#include <stdint.h>
#include <stdbool.h>
#include "adc_capture.h"   // adc_lpf_mode_t
#include "ssb_dsp.h"        // SSB_DSP_FREQ_DEV_SLEW_UNLIMITED_HZ
#include "envelope_interp.h"  // envelope_interp_curve_t
#include "envelope_gdeq.h"    // env_gdeq_variant_t


// Runtime switch between test signals and live mic input, toggled from
// loop() via serial commands 't' (two-tone)/'s' (single-tone)/'m' (mic) -
// see there. Starts from TWOTONE_TEST_MODE's compile-time value so
// existing behavior is unchanged if you never send a command. dsp_task
// branches on this rather than #if - all code paths are always compiled
// in and the ADC always runs (see init_adc() call in setup(), no longer
// conditional) so switching between any of the three is instant with no
// re-init needed.
typedef enum {
    AUDIO_SRC_MIC = 0,
    AUDIO_SRC_TWOTONE = 1,
    AUDIO_SRC_SINGLETONE = 2,   // clean single tone - isolates the DSP/RF chain from mic-side
                                // confounds (preamp hum, mic nonlinearity, room noise) when
                                // characterizing basic phase-modulation cleanliness, which two-tone's
                                // intermodulation products make harder to read at a glance
    AUDIO_SRC_ENVSTEP = 3,      // slow envelope square wave, bypassing ssb_dsp_process_sample()
                                // entirely (no mic, no Hilbert FIR, freq_dev_hz held at 0) - isolates
                                // JUST the PWM->analog filter->RSET path's own step response, with a
                                // sharp, easy-to-scope-trigger edge, for measuring its group delay
                                // directly rather than eyeballing a subtle two-tone envelope feature
    AUDIO_SRC_FMTEST = 4,       // pure sinusoidal FREQUENCY modulation, ALSO bypassing
                                // ssb_dsp_process_sample() entirely - envelope held at a fixed
                                // constant, freq_dev_hz set directly to a clean single-frequency
                                // sine wave. Isolates the AD9851/SPI/delay-line chain completely
                                // from the Hilbert FIR/DSP math (the opposite isolation from
                                // ENVSTEP, which isolates the envelope/PWM/filter path instead).
                                // Expected result is a textbook FM sideband forest at
                                // fc +/- n*FM_TEST_MOD_HZ with Bessel-function J_n(beta) amplitudes,
                                // beta=FM_TEST_DEV_HZ/FM_TEST_MOD_HZ - any spur that DOESN'T fit
                                // that pattern implicates the AD9851 chain itself, not the DSP math
                                // that both this mode and ENVSTEP deliberately route around.
    AUDIO_SRC_AMTEST = 5,       // mirror image of FMTEST: pure sinusoidal AMPLITUDE modulation,
                                // freq_dev_hz held at exactly 0 (phase/carrier completely fixed,
                                // no FM at all). Isolates the RSET/PWM/analog-filter/transistor
                                // path with a clean, mathematically known AM signal - ideal linear
                                // AM should produce ONLY a single sideband pair at fc+/-AM_TEST_MOD_HZ.
                                // Any additional sidebands/harmonics beyond that pair implicates
                                // nonlinearity specifically in the RSET path (transistor, PWM
                                // quantization, filter); any FM-looking sidebands appearing despite
                                // freq_dev_hz never being nonzero would mean genuine AM-to-PM
                                // crosstalk somewhere physical, a distinct and worth-knowing finding.
    AUDIO_SRC_CHIRP = 6,        // logarithmic sine-chirp sweep (20Hz-20kHz by default, see config.h's
                                // CHIRP_* constants) direct to the envelope/PWM (RSET) output, plus a
                                // synced square-wave reference on CHIRP_REF_GPIO (pin39) - for
                                // characterizing the analog reconstruction filter's transfer function
                                // against an external ADC-based TF measurement rig. Bypasses
                                // ssb_dsp_process_sample/envelope_floor/gdeq/relative_delay/AD9851/
                                // normal diagnostics - more than just ssb_dsp_process_sample() the
                                // way ENVSTEP/FMTEST/AMTEST do - and runs on EVERY fast tick (64kHz),
                                // not just full ticks (16kHz), since a 20kHz chirp needs more than
                                // SAMPLE_RATE_HZ's own 8kHz Nyquist. The offset/scale ('u'/'j'/'i'/'k')
                                // or predistort ('D') DC mapping is deliberately NOT bypassed, though -
                                // unlike master gain (which only scales the swing around a fixed mean,
                                // same as AMTEST), those knobs move WHERE on the duty range the sweep
                                // is centered, which is what's needed to test the analog filter/BS170
                                // gate for duty-range-dependent nonlinearity - see the .ino's dsp_task
                                // chirp block. Appended at the END of this enum (value 6) rather than
                                // inserted near AMTEST above, so no existing settingsPresets[] entry
                                // (which reference these by name, not by value) is disturbed.
} audio_source_t;


// each settings list has all the levers pre-defined for a particular test
typedef struct
{
    const char *name;

    audio_source_t audio_source;

    float relative_delay_samples;

    float env_pwm_offset;
    float env_pwm_scale;

    bool env_gdeq_enable;
    adc_lpf_mode_t adc_lpf_mode;   // was a plain bool "adc_lpf_bypass" - migrated to a 3-state
                                    // enum (off/Butterworth/Chebyshev) when the Chebyshev filter
                                    // option was added; every existing preset had bypass=true,
                                    // so this was a purely mechanical true->ADC_LPF_MODE_OFF
                                    // migration with zero behavior change to any preset below

    bool eq_enable;
    bool compressor_enable;

    float master_gain_db;

    bool ad9851_output_enable;

    // Added when these two per-preset levers were noticed missing from
    // PersistentSettings/the 'P' dump - both existed as live serial
    // toggles ('D', 'x'/'z') for a while before being wired in here.
    // Appended at the END of the struct (rather than inserted near their
    // conceptually-related fields above) so every existing preset's
    // POSITIONAL initializer list below still lines up unchanged - only
    // these two new trailing values needed adding to each.
    bool env_predistort_enable;   // 'D' - envelope pre-distortion LUT (envelope_predistort.h);
                                   // REPLACES env_pwm_offset/env_pwm_scale above while enabled
    float env_floor;              // 'x'/'z' - envelope-null floor (envelope_floor.h), 0.0=off

    // Added when this lever was introduced (freq_dev slew-rate limiter,
    // ssb_dsp.h) - appended at the END for the same reason env_predistort_enable/
    // env_floor were: every existing preset's POSITIONAL initializer list
    // below still lines up unchanged, only this one new trailing value
    // needed adding to each.
    float freq_dev_slew_limit_hz; // '{'/'}' - freq_dev slew-rate limit, Hz/sample (ssb_dsp.h);
                                   // SSB_DSP_FREQ_DEV_SLEW_UNLIMITED_HZ = off

    // Added when this lever was introduced (envelope output interpolation,
    // envelope_interp.h) - appended at the END for the same reason every
    // trailing field above was: every existing preset's POSITIONAL
    // initializer list below still lines up unchanged, only this one new
    // trailing value needed adding to each.
    bool envelope_interp_enable;  // 'I' - ENVELOPE_INTERP_FACTOR-x envelope output
                                   // interpolation (envelope_interp.h), off by default

    // Added when the interp curve became runtime-switchable (envelope_
    // interp.h v4.3, for a direct linear-vs-Catmull-Rom A/B) - appended at
    // the END for the same reason every trailing field above was. Only
    // affects rendered output while envelope_interp_enable is true.
    // CATMULL_ROM is deliberately the enum's 0 value (see envelope_interp.h)
    // so this is safe to leave off any preset literal that predates this
    // field - C's zero-fill of missing trailing initializers lands on
    // today's actual default, not v4's older one.
    envelope_interp_curve_t envelope_interp_curve;  // 'C' - envelope_interp.h

    // Added when this lever was introduced (envelope-path magnitude/
    // insertion-loss equalizer, envelope_ampeq.h) - appended at the END
    // for the same reason every trailing field above was: every existing
    // preset's POSITIONAL initializer list below still lines up
    // unchanged (C zero-fills this to false, matching its off-by-default
    // convention), only this one new trailing value needed adding to
    // presets that want it deliberately on.
    bool env_ampeq_enable;  // 'a' - envelope_ampeq.h, off by default

    // Added 2026-09-04 when ampeq's shelf 1 and shelf 2 were split into
    // independently-toggleable flags (envelope_ampeq.h - real hardware
    // showed shelf1-only and shelf1+shelf2 needed to be A/B-able without a
    // reflash). Appended at the END, same reasoning as env_ampeq_enable
    // above and every trailing field before it - existing presets'
    // positional initializers zero-fill this to false (shelf 2 off),
    // matching env_ampeq_enable's own off-by-default convention and this
    // project's current recommendation (shelf1-only, shelf2 off, pending
    // a gdeq refit - see group_delay_fit_notes.md's 2026-09-04 entries).
    bool env_ampeq_shelf2_enable;  // 'A' - envelope_ampeq.h, off by default

    // Added 2026-09-05 when the 'a'+'A'-specific gdeq candidate
    // (envelope_gdeq.h) became a live runtime toggle instead of a
    // compile-time-only flag - real-hardware testing that same day found
    // it a genuinely mixed result (better close-in two-tone IMD, worse
    // far-out intermodulation forest - see envelope_gdeq.h's 2026-09-05
    // header entry and group_delay_fit_notes.md), so it stayed off by
    // default here too, same convention as every trailing field above.
    //
    // 2026-09-06: migrated from that plain bool (toggle between the
    // default pair and the a+A candidate only) to this 3-state enum - the
    // same kind of migration adc_lpf_mode went through above when the
    // Chebyshev filter option was added. None of the 10 presets below ever
    // set this field explicitly (all relied on zero-fill), and
    // ENV_GDEQ_VARIANT_DEFAULT is deliberately value 0 (envelope_gdeq.h),
    // so this was a purely mechanical false->ENV_GDEQ_VARIANT_DEFAULT
    // migration with zero behavior change to any preset below. Needed to
    // support "candidate B" (a1=a2=+0.09) - a third selectable set
    // proposed by the mid-band local-slope-vs-p-p Pareto refit
    // (group_delay_fit_notes.md's 2026-09-06 entry) after that search
    // found the a+A candidate actually makes local 2800-4500Hz group-delay
    // slope WORSE than gdeq off entirely. 'G' now CYCLES default -> a+A
    // candidate -> candidate B -> default -> ... (same modulo-cycle
    // convention as 'C'/'f'), skipping any set this build never fitted.
    // Only takes effect on ENV_FILTER_PNP_BC327_ATTN @ SAMPLE_RATE_HZ=16000
    // (envelope_gdeq_set_variant() falls back to ENV_GDEQ_VARIANT_DEFAULT
    // otherwise, so a preset pasted from a different filter/Fs build won't
    // silently apply a coefficient pair that was never fit for the active
    // build). Candidate B is a MODEL PREDICTION ONLY as of 2026-09-06 - not
    // yet bench-validated - so pasting ENV_GDEQ_VARIANT_CANDIDATE_B here is
    // a deliberate bench-testing choice, not any kind of default.
    env_gdeq_variant_t env_gdeq_variant;  // 'G' - envelope_gdeq.h, default by default

    // Added 2026-09-21 when the ALC (envelope_alc.h) and Soft-Limit
    // (envelope_softlimit.h) stages were introduced - appended at the END
    // for the same reason every trailing field above was: every existing
    // preset's POSITIONAL initializer list below still lines up unchanged
    // (C zero-fills both to false, matching their off-by-default
    // convention - neither is bench-validated yet), only these two new
    // trailing values need adding to presets that want either deliberately
    // on. Both plain bools, same shape as env_ampeq_enable/
    // env_ampeq_shelf2_enable above - no reset-on-transition subtlety
    // beyond what each module's own _set_enabled() already handles
    // internally (unity-gain reset for ALC, none needed for the stateless
    // Soft-Limit).
    bool env_alc_enable;         // 'l' - envelope_alc.h, off by default
    bool env_softlimit_enable;   // 'S' - envelope_softlimit.h, off by default

    // 2026-09-25: comp_mode (ssb_dsp_comp_mode_t, added 2026-09-24) is GONE -
    // the whole switchable-mode compressor it selected between was removed
    // the same day it would have needed a second trailing field added for
    // the third mode - see ssb_dsp.h's 2026-09-25 comment for the full
    // reasoning (the user's own real mic recording showed the actual fix
    // needed was a Mic Gain stage upstream, not another compressor mode).
    //
    // Replacing it, appended at the END for the usual reason (every
    // existing preset's positional initializer list keeps working
    // unchanged): mic_gain_db (C zero-fills to 0.0f/unity - no effect
    // until deliberately set, same as master_gain_db's own convention) and
    // comp_level_db (C zero-fills to 0 = SSB_DSP_COMP_LEVEL_MIN, i.e. a
    // plain limiter with no makeup gain - see
    // ssb_dsp_set_compressor_level()'s doc comment in ssb_dsp.h). NOTE
    // this is a deliberate BEHAVIOR CHANGE from the old default, not a
    // "preserves prior behavior" zero-fill the way every other trailing
    // field above was: the pre-2026-09-25 compressor applied automatic
    // makeup gain by default, this one does not - an existing preset that
    // relied on hearing a boost with 'c' on will need comp_level_db set
    // explicitly (1-6) to get one back, now from a properly voice-
    // calibrated table instead of an unvalidated fixed formula.
    float mic_gain_db;    // 'U'/'Y' - ssb_dsp.h, 0.0dB (unity) by default
    int comp_level_db;    // 'X'/'q' - ssb_dsp.h, level 0 (limiter only) by default

    // 2026-09-25, later: Mic Squelch - appended at the END, same
    // positional-append reason as every trailing field above. Zero-fills
    // to squelch_enable=false, squelch_threshold=0.0 - a genuine
    // preserves-prior-behavior default this time (unlike comp_level_db's
    // deliberate change above): squelch didn't exist before, so "off,
    // threshold irrelevant" is exactly the old behavior. See
    // ssb_dsp_set_squelch_enabled()'s doc comment in ssb_dsp.h. NOTE:
    // loading ANY preset - including every existing one below, none of
    // which specify these two fields - resets squelch_threshold to 0.0,
    // NOT ssb_dsp_init()'s own 0.01 runtime default (harmless while
    // squelch_enable is also zero-filled to false, but worth knowing if
    // dialing threshold live right after a preset load).
    bool squelch_enable;       // 'W' - ssb_dsp.h, off by default
    float squelch_threshold;  // '('/')' - ssb_dsp.h, 0.0 (off/no threshold) by default

} PersistentSettings;


// -----------------------------------------------------------------------------
// Pre-defined settings
// -----------------------------------------------------------------------------

// relative_delay_samples below was tuned by ear/scope at SAMPLE_RATE_HZ=10000
// and is stored as a raw sample count, not a time - so when SAMPLE_RATE_HZ
// was raised to 16000, every value here was rescaled by 16000/10000=1.6 to
// preserve the same REAL-TIME delay (e.g. 1.9 samples @ 10000Hz = 190us ->
// 3.04 samples @ 16000Hz, still 190us). This is only a first-order
// approximation, for two reasons: (1) it's a straight proportional scale of
// a by-ear/scope-tuned value, not a re-measurement; (2) more importantly,
// envelope_gdeq's own contributed delay is NOT the same fraction of a
// sample at both rates - the 16000Hz-fitted ENV_GDEQ_A1/A2 (see
// envelope_gdeq.h) add ~163us of mean delay vs. the 10000Hz fit's ~265us,
// a real ~102us (~1.6 samples @ 16000Hz) reduction independent of this
// rescale. So for the env_gdeq_enable=true presets specifically, expect the
// true re-tuned optimum to land LOWER (less positive) than the naive x1.6
// value below by roughly that amount - a starting hint for '['/']'
// re-tuning, not a substitute for it. Presets with env_gdeq_enable=false
// aren't affected by that second factor.
//
// 2026-09-01: baseline merged from the user's own live-tuned settings.h -
// every preset below reflects real bench tuning (see group_delay_fit_notes.md's
// 2026-09-01 entries for the IMD/delay-sweep work behind presets 0/5/6
// specifically), not this file's earlier by-ear starting points. Only
// structural addition on top of the user's file: envelope_interp_curve
// (the trailing field above) - every preset explicitly set to
// ENVELOPE_INTERP_CURVE_CATMULL_ROM since none of them have been re-tuned
// against the linear curve yet, so behavior is unchanged from the merged
// baseline until 'C' is used to test that.
static const PersistentSettings settingsPresets[10] =
{
    // Preset 0 - Normal microphone operation

    {"Micr latest 16kFs",    AUDIO_SRC_MIC, 2.48f, 0.36f, 0.48f, true, ADC_LPF_MODE_CHEBYSHEV, true, true, 33.0f, true, false, 0.00f,
    SSB_DSP_FREQ_DEV_SLEW_UNLIMITED_HZ, true, ENVELOPE_INTERP_CURVE_CATMULL_ROM },
    // relative_delay_samples
    // env_pwm_offset
    // env_pwm_scale
    // env_gdeq_enable
    // adc_lpf_mode
    // eq_enable
    // compressor_enable
    // master_gain_db
    // ad9851_output_enable
    // env_predistort_enable
    // env_floor
    // freq_dev_slew_limit_hz
    // envelope_interp_enable
    // envelope_interp_curve

// Preset 1 - Two-tone test
{
"TwoTone Base",
AUDIO_SRC_TWOTONE, 0.00f, 0.20f, 0.90f, false, ADC_LPF_MODE_OFF, false, false, -2.0f, true, false, 0.00f,
SSB_DSP_FREQ_DEV_SLEW_UNLIMITED_HZ, false, ENVELOPE_INTERP_CURVE_CATMULL_ROM },

// Preset 2 - Single-tone test
 { "Shelf2 Baseline gdeq adj#2", AUDIO_SRC_TWOTONE, 2.03f, 0.20f, 0.90f, true, ADC_LPF_MODE_OFF, false, false, -1.4f, true, true, 0.00f, SSB_DSP_FREQ_DEV_SLEW_UNLIMITED_HZ, false, ENVELOPE_INTERP_CURVE_CATMULL_ROM, true, true, ENV_GDEQ_VARIANT_DEFAULT },

 // Preset 3 - Envelope / PWM test
 { "Shelf2 Baseline gdeq adj#4", AUDIO_SRC_TWOTONE, 2.00f, 0.20f, 0.90f, true, ADC_LPF_MODE_OFF, false, false, -1.4f, true, true, 0.00f, SSB_DSP_FREQ_DEV_SLEW_UNLIMITED_HZ, false, ENVELOPE_INTERP_CURVE_CATMULL_ROM, true, true,  ENV_GDEQ_VARIANT_CANDIDATE_B },
    
 // relative_delay_samples
   // env_pwm_offset
   // env_pwm_scale
    // env_gdeq_enable
    // adc_lpf_mode
   // eq_enable
   // compressor_enable
   // master_gain_db
    // ad9851_output_enable
   // env_predistort_enable
    // env_floor
    // freq_dev_slew_limit_hz
    // envelope_interp_enable
    // envelope_interp_curve

// Preset 4 - Diagnostic / raw ADC
{ "ReSync Micr", AUDIO_SRC_MIC, 2.68f, 0.36f, 0.48f, true, ADC_LPF_MODE_CHEBYSHEV, true, false, 33.3f, true, true, 0.00f, SSB_DSP_FREQ_DEV_SLEW_UNLIMITED_HZ, false, ENVELOPE_INTERP_CURVE_CATMULL_ROM, false, false, ENV_GDEQ_VARIANT_DEFAULT },

// Preset 5 -
{ "V4 Microphone tunedD7", AUDIO_SRC_MIC, 2.03f, 0.36f, 0.48f, true, ADC_LPF_MODE_CHEBYSHEV, true, true, 19.3f, true, true, 0.00f, SSB_DSP_FREQ_DEV_SLEW_UNLIMITED_HZ, false, ENVELOPE_INTERP_CURVE_CATMULL_ROM, true, true, ENV_GDEQ_VARIANT_CANDIDATE_B },

// Preset 6 -
{ "V4 Two tone tuned", AUDIO_SRC_TWOTONE, 2.15f, 0.20f, 0.90f, false, ADC_LPF_MODE_OFF, false, false, 0.6f, true, true, 0.00f, SSB_DSP_FREQ_DEV_SLEW_UNLIMITED_HZ, true, ENVELOPE_INTERP_CURVE_CATMULL_ROM },
// Preset 7 -
{ "TwoToneButwGD Env 1.6-2.9", AUDIO_SRC_TWOTONE, 2.96f, 0.40f, 0.46f, true, ADC_LPF_MODE_OFF, false, false, 1.0f, true, false, 0.0f, SSB_DSP_FREQ_DEV_SLEW_UNLIMITED_HZ, false, ENVELOPE_INTERP_CURVE_CATMULL_ROM },  // was 1.85f @ 10000Hz; adc_lpf_bypass=true
// Preset 8 - 2026-09-25: migrated to new mic-gain/compressor-level
// architecture per explicit user request (old master_gain_db=29.3f moved
// out; compressor now on with mic_gain_db=7.0f, comp_level_db=6). This is
// the noise-test preset (speaker at low volume, not speech) - unlike
// preset 9 below, no independent real-voice calibration cross-check
// applies to this one's mic_gain_db value, it's simply the user's stated
// new setting.
{ "Micr WhiteNoise", AUDIO_SRC_MIC, 2.68f, 0.36f, 0.48f, true, ADC_LPF_MODE_CHEBYSHEV8, true, true, 0.0f, true, true, 0.00f, SSB_DSP_FREQ_DEV_SLEW_UNLIMITED_HZ, false, ENVELOPE_INTERP_CURVE_CATMULL_ROM, false, false, ENV_GDEQ_VARIANT_DEFAULT, true, true, 14.0f, 6, true, 0.0160f },
// Preset 9 - 2026-09-25: migrated to new mic-gain/compressor-level
// architecture per explicit user request (old master_gain_db=6.3f moved
// out; compressor now on with mic_gain_db=14.0f, comp_level_db=6). Per
// the user, 14dB reflects a louder speaker setup than the 6.3dB voice
// tuning this preset carried before - NOT a re-assertion of the earlier, true, 0.0160f
// 6.3dB/6.17dB calibration match noted 2026-09-25 (that comparison applies
// to the OLD value this preset just moved away from, not to 14dB).
{ "Micr Voice", AUDIO_SRC_MIC, 2.68f, 0.36f, 0.48f, true, ADC_LPF_MODE_CHEBYSHEV8, true, true, 0.0f, true, true, 0.00f, SSB_DSP_FREQ_DEV_SLEW_UNLIMITED_HZ, false, ENVELOPE_INTERP_CURVE_CATMULL_ROM, false, false, ENV_GDEQ_VARIANT_DEFAULT, true, true, 7.0f, 6, true, 0.0160f }
};

// If this array's size ever changes, ssb_mic_test.ino's serial handler
// (the `c >= '0' && c <= '9'` preset-select block in loop(), and the
// boot-banner preset listing in setup()) needs its range updated to
// match - this catches a silent mismatch at compile time instead of
// leaking a stale range (missing the new last preset, or indexing past
// the array's end) into a build that otherwise looks fine.
static_assert(sizeof(settingsPresets) / sizeof(settingsPresets[0]) == 10,
              "settingsPresets size changed - update the '0'-'9' range "
              "in ssb_mic_test.ino's loop()/setup()");
