Rich5252/Arduino_ESP32_ssb_signal_generator/adc_capture.h

#pragma once

/**
 * adc_capture.h
 *
 * Mic ADC capture: adc_continuous (DMA) setup, the ISR->task FIFO, the
 * per-sample biquad LPF, and the associated continuity diagnostics. Moved
 * out of ssb_mic_test.ino as-is during the module-split refactor - see
 * that file's original top-of-file comment block (now trimmed down, the
 * ADC-specific history notes live here instead) for the full "why adc_
 * continuous instead of adc_oneshot, why a FIFO, why float filtering only
 * happens in task context" backstory. None of that design changed, only
 * where the code physically lives.
 */

#include <stdint.h>
#include <stdbool.h>
#include "esp_attr.h"

// ---- adc_continuous (DMA) config, replacing adc_oneshot ----
// adc_oneshot's per-call overhead (~147us measured) is documented as
// unsuitable for audio-rate polling - it's built for occasional reads.
//
// HISTORY (kept for context, since this took a few iterations to land on):
// v1 (polling adc_continuous_read() from dsp_task each tick) hit two
// separate problems depending on frame size: a large frame (64 samples
// @ ~21kHz, ~3ms to fill) meant most ticks found nothing ready and reused
// a stale sample for milliseconds at a time (measured as "low and
// non-monotonic, with inversions"). Shrinking the frame to reduce
// staleness (4 samples @ 80kHz) instead made adc_continuous_read() itself
// land at nearly the SAME rate as dsp_task's own tick, and the read call
// jumped to ~50-53us regardless of further frame/rate tuning - evidence
// that ~50us is close to the real cost of a genuinely successful
// (non-stale) read on this build, not something more tuning would fix.
//
// v2: register adc_continuous's on_conv_done EVENT CALLBACK instead of
// polling. The callback runs in ISR context right when a frame completes
// and hands us a direct pointer to the frame data
// (adc_continuous_evt_data_t::conv_frame_buffer) - no adc_continuous_read()
// call needed there at all (the ESP-IDF docs are explicit that read()
// isn't ISR-safe to call from within the callback anyway). The callback
// just pushes raw integers into the FIFO now (see the AVERAGING note
// below); adc_capture_read_next_sample() drains a fixed count per tick and
// does the actual filtering. No driver call and no blocking in the hot
// ISR/task path either way.
//
// The underlying pool still needs periodic draining via
// adc_continuous_read() to avoid on_pool_ovf - see adc_capture_service(),
// called from loop() at low priority on Core 1, fully decoupled from
// dsp_task.
//
// AVERAGING (superseded, kept for context): frame=1 (the original version
// of this section) meant the callback only ever kept the single freshest
// raw ADC reading - real oversampling was happening (ADC running faster
// than the tick rate) but none of it was being used to reduce noise,
// since every sample but the last was simply discarded. A later version
// averaged across the whole frame (N=16 boxcar, ~200us window,
// sqrt(16)=4x noise reduction) instead of just taking the tail sample.
//
// SWAPPED FOR A REAL FILTER - four iterations to land on the current
// design. Spectrum-analyser check of the raw ADC floor (mic grounded)
// showed it's flat/broadband, so oversampling+LPF is the right approach
// in principle - but a boxcar's stopband is leaky (sinc sidelobes only
// ~-13dB down at best) and it only updated once per frame (200us @
// N=16), leaving a zero-order-hold staircase between updates:
//   1. Float biquad (ssb_adc_filter.h) directly in adc_conv_done_cb -
//      crashed immediately (Guru Meditation, CoprocessorException):
//      Xtensa ISRs have no FPU register-save area, float math isn't
//      legal there at all.
//   2. Float biquad moved to dsp_task, fed via a ring buffer from the
//      ISR (integer-only) that dsp_task fully DRAINED every tick -
//      worked once ADC_CONT_FRAME_SAMPLES dropped to 4 (matching the
//      ISR firing rate to the tick rate), but that also meant the ISR
//      fired every tick, and draining+filtering in dsp_task every tick
//      added real measured cost (~20-26us) against the ~50us budget.
//   3. Q15 fixed-point biquad run directly back in the ISR, to avoid
//      that per-tick task cost - timing didn't improve and a genuine
//      limit-cycle bug turned up (fixed, feedback terms were using the
//      truncated output instead of full Q15 precision) but STILL didn't
//      fix the noise on a sweep test. Turned out frame size was never
//      really the issue for the filter itself (it processes every
//      sample regardless of N) - only ever exposing the LAST sample of
//      each burst is what tied output cadence to frame size.
//   4. Current: split the two concerns apart properly. adc_conv_done_cb
//      goes back to pure integer copying (any N is fine now, no ISR
//      arithmetic cost at all) into the FIFO; adc_capture_read_next_
//      sample() pops a FIXED count per tick (the true Fs_adc/Fs_dsp
//      ratio) and filters each one in order, in task context (float is
//      safe there). The FIFO absorbs the burstiness of "16 samples
//      arrive together every 4th tick" while dsp_task drains a steady 4
//      every tick - so every tick gets a genuinely fresh, individually
//      filtered sample, without needing the ISR to fire that often.
//      ADC_CONT_FRAME_SAMPLES can go back up for ISR efficiency; it no
//      longer has any bearing on filter correctness or output cadence.
// ADC_LPF_CUTOFF_HZ (below) is the actual tuning knob for the noise/
// bandwidth tradeoff now; not yet verified by ear or against real
// spurious data - flagged for the same "listen to it, don't assume"
// treatment the old N value got.
//
// TRIED, REVERTED: dropped to 48000 (ratio 3, ADC_SAMPLES_PER_TICK 5->3) to
// try to free Core-0 CPU headroom ahead of revisiting the gptimer-core
// wakeup-jitter question (see init_sample_timer()'s own "TRIED, REVERTED"
// comment in the .ino - a real crash there showed Core 0 had zero spare
// budget at 80kHz). Real hardware showed two problems: (1) max_busy_us
// came back flat-to-slightly-worse (46us vs the ~44us baseline) - no clear
// CPU win to show for it at all; (2) noise got ~1dB worse broadband and
// MUCH worse specifically in the 3-6kHz band. Root cause for (2): the ADC
// ISR still delivers bursts of ADC_CONT_FRAME_SAMPLES (16) samples at a
// time regardless of this rate, so dropping the rate stretched the burst
// interval from 3.2 dsp ticks (80kHz) to 5.33 ticks (48kHz) - a much
// longer gap between refills at only 3 samples/tick of drain, which
// [adc] fifo: min=0 / starve_ticks_total in the tens-of-thousands
// confirmed was genuinely hitting zero, not just a comfortable margin.
// A starved tick makes adc_capture_read_next_sample() re-return the last
// filtered value (see adc_capture.cpp's to_pop=available branch) - a
// small zero-order-hold repeat recurring at the burst rate itself
// (ADC_CONT_SAMPLE_FREQ_HZ/ADC_CONT_FRAME_SAMPLES = 48000/16 = exactly
// 3000Hz) - i.e. a periodic artifact landing its fundamental and first
// harmonic right on 3000/6000Hz, matching the reported band precisely.
// Shrinking ADC_CONT_FRAME_SAMPLES to compensate was proposed but not yet
// tried before the whole experiment was called off - "keep the dB we've
// already got" took priority. Left here for the next time someone's
// tempted to touch this knob again.
//
// 2026-09-23: changed to 64000 (from 80000) - this is a DIFFERENT change
// from the 48000 experiment above (48000/16000=3, a genuinely smaller
// ratio that starved the FIFO per the TRIED/REVERTED story above; 64000/
// 16000=4, still an exact-integer ratio, one less than 80000's 5 but with
// no starving observed). Confirmed on real hardware as the user's
// preferred live configuration since the Fs-hunt investigation
// (moving_forward_notes.md's 2026-09-20/09-21 entries, null_bias_
// investigation.md's matching entries): 64000 lands on the same ~0.16%
// ADC-clock rounding error as 16000/32000/48000/96000 (all at the floor
// this project's clock-divider math allows), vs. 80000's own ~0.806%
// error - a real, now-mechanistically-understood improvement, not just a
// preference. This repo's value had been left at 80000 through that whole
// investigation (the 64000 setting existed only as a local edit on the
// user's board) until this commit brought the two back in sync.
#define ADC_CONT_SAMPLE_FREQ_HZ   64000u   // within ESP32-S3's continuous-mode range
#define ADC_CONT_FRAME_SAMPLES    16    // DMA chunk size only now - see AVERAGING note above.
                                         // If adc_continuous_new_handle() errors on this, the
                                         // driver enforces a different frame-size constraint -
                                         // report the exact error and we'll adjust.
#define ADC_CONT_FRAME_BYTES      (ADC_CONT_FRAME_SAMPLES * SOC_ADC_DIGI_DATA_BYTES_PER_CONV)
// 4x the original size - 4096 bytes (1024 samples) turned out to be
// smaller than loop() could stall for on a slow-baud Serial.printf()
// burst, causing real on_pool_ovf events (see adc_capture_get_diag()).
// Raising baud rate is the primary fix; this is cheap additional margin
// on top - ~50ms headroom @ 80kHz (headroom-in-TIME grows as
// ADC_CONT_SAMPLE_FREQ_HZ drops, same fixed byte/sample budget spread
// over a slower rate, if that's ever revisited - see ADC_CONT_SAMPLE_FREQ_HZ's
// own "TRIED, REVERTED" comment above).
#define ADC_CONT_BUF_BYTES        16384  // ~4096 samples

// 4th-order LPF (two cascaded biquads, ssb_biquad4_t - see
// ssb_adc_filter.h) applied per raw sample in adc_conv_done_cb's
// downstream consumer, replacing the old N=16 boxcar average - see the
// AVERAGING comment above. Sits at the top of the voice band on purpose
// (same reasoning the old 5kHz boxcar corner used): filtering broadband
// ADC noise without eating wanted audio. Real tuning knob now - not yet
// verified by ear or spectrum analyser with the AD9851 in the loop.
//
// Order matters here specifically because adc_capture_read_next_sample()
// decimates 80kHz down to SAMPLE_RATE_HZ (16kHz) by simply keeping every
// 5th filtered sample - so anything from 8kHz (the post-decimation
// Nyquist) up to 40kHz (the ADC's own Nyquist) that survives this filter
// aliases straight back into the audio band. Started as a single 2nd-order
// biquad; upgraded to 4th-order (cascade of two) once real hardware
// testing showed the 2nd-order version helped and there was an obvious
// next question ("worth more order?") - 4th order roughly DOUBLES the dB
// rejection at every frequency above cutoff for negligible extra CPU (one
// more biquad's worth of multiply-adds per raw ADC sample, in task
// context where the [timing] budget has margin to spare) - e.g. at 8kHz,
// Butterworth goes from -17.6dB (2nd order) to -35.1dB (4th order).
//
// Two filter families now share this same fc_hz - toggled live via serial
// 'f' (see adc_lpf_mode_t below):
//   - Butterworth (ssb_biquad4_lpf_init): maximally flat passband, -3dB
//     exactly at ADC_LPF_CUTOFF_HZ.
//   - Chebyshev Type I (ssb_biquad4_chebyshev_lpf_init), ripple
//     ADC_LPF_CHEBYSHEV_RIPPLE_DB below: genuinely "same 3dB bandwidth,
//     faster rolloff" - internally solves (once, at init time - see
//     ssb_adc_filter.c) for the frequency scaling that puts its TRUE -3dB
//     point at exactly ADC_LPF_CUTOFF_HZ too, same as the Butterworth
//     filter, rather than the textbook Chebyshev convention of using the
//     ripple-edge frequency directly (verified numerically to be the
//     wrong choice here - see ssb_adc_filter.h). With -3dB points
//     matched, Chebyshev is monotonically MORE attenuated than
//     Butterworth above 3000Hz at every order - at 4th order, e.g. -47.7dB
//     vs -35.1dB at 8kHz, both converging to the same ultimate
//     -24dB/octave slope far out (filter ORDER, not family, sets that).
#define ADC_LPF_CUTOFF_HZ             2800.0f
#define ADC_LPF_CHEBYSHEV_RIPPLE_DB   1.0f   // standard/commonly-cited spec; small (~1.4dB peak
                                              // at 4th order) in-band ripple bump in exchange for
                                              // the steeper rolloff above - inconsequential for
                                              // mic audio

// Raw ADC samples cross the ISR->task boundary through a FIFO as plain
// integers - the ISR does NO filtering at all, just copies. This
// decouples two things that were previously tangled together:
//   - ADC_CONT_FRAME_SAMPLES (how many samples the DMA/ISR handles per
//     interrupt) - can now be whatever's efficient for the driver/ISR
//     overhead, independent of anything else.
//   - The output UPDATE RATE dsp_task sees - governed instead by how
//     many items adc_capture_read_next_sample() pops off the FIFO per
//     call (see ADC_SAMPLES_PER_TICK below), not by how often the ISR
//     happens to fire.
// Single-producer (ISR)/single-consumer (dsp_task via
// adc_capture_read_next_sample()), so plain volatile head/tail is fine.
#define ADC_FIFO_SIZE   64   // power of two; headroom over one ADC_CONT_FRAME_SAMPLES-sized burst
#define ADC_FIFO_MASK   (ADC_FIFO_SIZE - 1)

// How many raw ADC samples dsp_task nominally consumes from the FIFO
// each tick - the exact Fs_adc/Fs_dsp ratio. Currently 64000/16000 = 4
// exactly (2026-09-23: was 80000/16000 = 5 before ADC_CONT_SAMPLE_FREQ_HZ
// moved to 64000 - see that define's own comment; before that, 80000/10000
// = 8 before SAMPLE_RATE_HZ was raised; a 48000/16000=3 rate was also tried
// and reverted, for an unrelated FIFO-starving reason - see
// ADC_CONT_SAMPLE_FREQ_HZ's own comment above) - if either rate ever
// changes, check this stays an integer division with zero remainder.
//
// 2026-09-20: this integer value is now ONLY the seed/reference point for
// the fractional resampler below (adc_capture_read_next_sample()'s actual
// per-tick pop count is driven by a MEASURED true_ratio, not this nominal
// integer) - see that function's own comment block for why. Left defined
// here unchanged (still used by ADC_SAMPLES_PER_TICK_MAX and diagnostic
// printing, and it's still a real invariant worth keeping true - a
// nonzero remainder here means SAMPLE_RATE_HZ itself isn't an integer
// multiple away from ADC_CONT_SAMPLE_FREQ_HZ, e.g. 65000/16000, which
// silently truncates and previously caused a NEW code-introduced ~1.5%
// decimation error entirely separate from the ADC's own clock inaccuracy -
// see moving_forward_notes.md's 2026-09-20 entries).
#define ADC_SAMPLES_PER_TICK       (ADC_CONT_SAMPLE_FREQ_HZ / SAMPLE_RATE_HZ)

// How many dsp-tick calls to adc_capture_read_next_sample() to average
// over before recomputing the resampler's calibrated true_ratio (see that
// function's comment). ~4 seconds at 16kHz - long enough to be a genuinely
// low-noise average (same "long-window" reasoning diagnostics.cpp already
// uses for its own independent rate measurement - averaging error shrinks
// with window length), short enough to still track slow drift (thermal,
// supply voltage) across a session rather than freezing in whatever the
// very first measurement happened to be.
#define ADC_RATIO_CALIB_WINDOW_CALLS   (SAMPLE_RATE_HZ * 4u)

// CATCH-UP THRESHOLD - separate from the nominal rate above. This is the
// "genuine backlog" cutoff the drain logic uses: available <= this ->
// take nominal ADC_SAMPLES_PER_TICK; above it -> something abnormal has
// happened (startup, mode switch) and it drains aggressively to recover.
// See adc_capture.cpp's adc_capture_read_next_sample() for the full
// history of why this two-tier design replaced two earlier, broken ones.
#define ADC_SAMPLES_PER_TICK_MAX   (2 * ADC_CONT_FRAME_SAMPLES)

typedef struct {
    uint32_t samples_total;       // running total, incremented by n each on_conv_done
    uint32_t callback_count;      // how many times on_conv_done has fired
    uint32_t pool_ovf_count;      // on_pool_ovf events - direct evidence of drops
    uint32_t fifo_starve_count;   // ticks where available < ADC_SAMPLES_PER_TICK
    uint32_t fifo_min_available;  // running low-water mark
    uint32_t fifo_max_available;  // running high-water mark
    uint32_t fifo_drop_count;     // our FIFO overflowing (distinct from driver pool_ovf)
} adc_capture_diag_t;

// Starts adc_continuous, registers the event callbacks, inits the LPF, and
// runs the one-time raw diagnostic dump - the full original init_adc()
// body. Call once from setup().
void adc_capture_init(void);

// Pops the next batch of raw ADC samples out of the FIFO, runs each
// through the selected biquad (or passes it through raw if OFF), and
// returns this tick's decimated output sample in ADC-code units
// (~0-4095) - exactly what dsp_task used to keep in s_last_filtered_adc
// before normalizing to [-1,1] and DC-blocking itself. Called once per
// dsp_task tick, mic mode only.
//
// 2026-09-20: PROPER FRACTIONAL RESAMPLER, replacing the old fixed-
// ADC_SAMPLES_PER_TICK + integer "+1 opportunistic bleed" scheme. Two
// things changed, addressing the two separate problems that scheme had:
//
// (1) CALIBRATED, not assumed, true_ratio. This project's own bench
//     history (moving_forward_notes.md/null_bias_investigation.md,
//     2026-09-20 entries) confirmed the ADC's real achieved sample rate
//     never exactly matches ADC_CONT_SAMPLE_FREQ_HZ - measured ~80645-
//     80795 sps against a configured 80000, still off against a
//     configured 64000 too - and that this doesn't correlate with how
//     "clean" a divisor the configured value is of any reference clock
//     (both 80000 and 64000 divide the 80MHz APB clock exactly; neither
//     ADC rate came out exact). Rather than hardcoding any specific
//     board's one-time measurement (which the user's own "it varies a
//     bit" observation argues against anyway), this function measures
//     its OWN true_ratio at runtime: every ADC_RATIO_CALIB_WINDOW_CALLS
//     calls, it compares how many raw ADC samples actually arrived
//     (s_dbg_adc_samples_total, ISR-incremented) against how many times
//     it was itself called over that same window, and updates
//     s_true_ratio to the real measured average. Seeded at the nominal
//     ADC_SAMPLES_PER_TICK value until the first window completes.
//
// (2) True fractional-position tracking + linear interpolation, not a
//     hard integer "pop N or N+1, return whichever raw sample happened
//     to be last". A BOUNDED [0,1) phase accumulator (s_phase - NOT an
//     ever-growing absolute position; see the 2026-09-20 BUGFIX comment
//     on adc_capture.cpp's resampler state block for why that distinction
//     is load-bearing, not cosmetic - a first version of this used an
//     unbounded float position and silently lost precision after a few
//     minutes of continuous operation, itself producing new audible
//     distortion) accumulates by true_ratio every call; its integer part
//     says how many raw samples should have been consumed by now, and the
//     leftover fraction is used to linearly interpolate between the two
//     bracketing already-filtered raw samples for this tick's output -
//     spreading the correction smoothly across every tick instead of
//     concentrating it into periodic +1 "gulp" events. Each raw sample is
//     still individually run through the LPF, in order, so the anti-alias
//     filter's own time-domain behavior is unaffected - only which
//     already-filtered sample(s) get used for the tick's output changed.
//     Adds a fixed ~1 raw-sample-period (~12-15us) latency vs. the old
//     scheme (needs one sample of lookahead to interpolate) - inaudible,
//     not a practical concern.
//
// Not yet bench-tested. adc_capture_get_true_ratio()/
// adc_capture_ratio_is_calibrated() below exist specifically so this can
// be watched on real hardware (compare the resampler's own calibrated
// value against diagnostics.cpp's independently-computed long-window
// true_ratio - they should converge to the same number as a cross-check)
// before trusting it silences the 645Hz-class artifact rather than just
// moving it.
float IRAM_ATTR adc_capture_read_next_sample(void);

// The resampler's own live-calibrated Fs_adc/Fs_dsp ratio (see
// adc_capture_read_next_sample()'s comment above) - NaN-free by
// construction (starts at the nominal ADC_SAMPLES_PER_TICK, only ever
// reassigned from a real measured ratio). Exists for diagnostics.cpp to
// print alongside its own independently-computed true_ratio, as a live
// cross-check that the two measurement methods agree.
float adc_capture_get_true_ratio(void);

// True once at least one full ADC_RATIO_CALIB_WINDOW_CALLS window has
// completed and adc_capture_get_true_ratio() reflects a real measurement
// rather than the nominal seed value.
bool adc_capture_ratio_is_calibrated(void);

// Drains adc_continuous's internal pool so it doesn't overflow -
// discards everything read. Low priority, not time-critical; call from
// loop() every iteration (runs unconditionally, same as the original).
void adc_capture_service(void);

// Live toggle for the ADC anti-alias/noise LPF, via serial 'f' - see
// serial_commands.cpp. OFF passes raw ADC samples through unchanged (was
// the boolean "bypass=true" state before this became multi-way); the
// remaining six select which filter (order x family, see ADC_LPF_CUTOFF_HZ
// / ADC_LPF_CHEBYSHEV_RIPPLE_DB above, and ssb_adc_filter.h for the
// per-order design math) processes the signal.
//
// 2026-09-23: BUTTERWORTH6/CHEBYSHEV6/BUTTERWORTH8/CHEBYSHEV8 added when
// the mic's out-of-band rejection above ~3kHz (still 4th order at the
// time) was identified as the limiting factor once a better electret
// capsule is fitted. Deliberately APPENDED after the original three
// (values 3-6) rather than renumbered, so old PersistentSettings presets
// referencing ADC_LPF_MODE_BUTTERWORTH/_CHEBYSHEV by name keep meaning
// exactly what they always meant (the 4th-order filters) - same
// append-only convention this codebase already uses for PersistentSettings
// fields themselves. See moving_forward_notes.md's 2026-09-23 entry for why
// 6th/8th order were designed as genuine higher-order filters (same
// ripple spec, no naive double-pass) rather than just running the 4th-
// order filter through itself twice.
typedef enum {
    ADC_LPF_MODE_OFF = 0,
    ADC_LPF_MODE_BUTTERWORTH = 1,   // 4th order
    ADC_LPF_MODE_CHEBYSHEV = 2,     // 4th order
    ADC_LPF_MODE_BUTTERWORTH6 = 3,
    ADC_LPF_MODE_CHEBYSHEV6 = 4,
    ADC_LPF_MODE_BUTTERWORTH8 = 5,
    ADC_LPF_MODE_CHEBYSHEV8 = 6,
} adc_lpf_mode_t;

void adc_capture_set_lpf_mode(adc_lpf_mode_t mode);
adc_lpf_mode_t adc_capture_get_lpf_mode(void);

// Short human-readable name for the current mode ("off"/"Butterworth"/
// "Chebyshev") - used by the 'f' handler's printf and the 'P' status/
// preset-dump line, so both stay in sync with the enum automatically
// rather than duplicating a string-selection ternary in two places.
const char *adc_capture_lpf_mode_name(adc_lpf_mode_t mode);

// Zeros every counter/watermark below (the 'r' command's ADC-side reset).
void adc_capture_reset_diag(void);

// 2026-09-21: primes the resampler's calibration-window baseline to
// "now" - MUST be called every time audio_source transitions into
// AUDIO_SRC_MIC (see serial_commands.cpp's 'm' handler and its numeric-
// preset-apply path), not just at boot/'r'. adc_continuous runs (and
// s_dbg_adc_samples_total keeps incrementing) unconditionally regardless
// of audio source, but adc_capture_read_next_sample() - which is what
// actually advances the calibration window - only runs in mic mode. Any
// time spent in a non-mic mode between calibration windows leaves the
// baseline stale relative to the ISR's sample count, corrupting the next
// calibration's measured ratio (in the tell-tale, project-first-observed
// form of an intermittent "funny mode with strange IMDs" after switching
// back into mic - see moving_forward_notes.md's 2026-09-21 entry). Cheap
// and safe to call even when already in mic mode - just re-baselines.
void adc_capture_resample_prime_calibration(void);

void adc_capture_get_diag(adc_capture_diag_t *out);

/**
 * @brief 2026-09-11: NaN/Inf canary for the ADC LPF's two biquad4 cascades
 *        - same purpose and reasoning as envelope_gdeq_get_canary()/
 *        envelope_ampeq_get_canary() (see moving_forward_notes.md's
 *        matching entry): an IIR filter's feedback state (z1/z2 here,
 *        Direct-Form-II-transposed) can carry a bad value forward forever
 *        once introduced, and nothing in ssb_adc_filter.c's flush_denorm()
 *        calls catches NaN/Inf, only near-zero subnormals. Checked
 *        regardless of which filter (or neither) is currently selected via
 *        adc_capture_set_lpf_mode() - both are always initialized and kept
 *        current per adc_capture_init()'s own comment, so both are always
 *        worth checking. Not currently exercised by two-tone/synthetic
 *        test modes (adc_capture_read_next_sample() - the only code that
 *        runs these filters - isn't called for those sources, see
 *        ssb_mic_test.ino), only relevant once a mic-driven source is
 *        active - included anyway for completeness/future use.
 */
typedef struct {
    bool butterworth_finite;
    bool chebyshev_finite;
    bool butterworth6_finite;   // 2026-09-23
    bool chebyshev6_finite;     // 2026-09-23
    bool butterworth8_finite;   // 2026-09-23
    bool chebyshev8_finite;     // 2026-09-23
} adc_lpf_canary_t;

void adc_capture_get_lpf_canary(adc_lpf_canary_t *out);

// esp_timer microsecond timestamp captured once at adc_continuous_start()
// (and again on 'r', "restarting the long-window average from now" per
// the original comment) - used by diagnostics.cpp's long-window ADC rate
// calculation.
int64_t adc_capture_get_start_us(void);
