Rich5252/Arduino_ESP32_ssb_signal_generator/ssb_dsp.h

#pragma once

#include <stdint.h>
#include <stdbool.h>
#include "esp_err.h"
#include "esp_attr.h"

#ifdef __cplusplus
extern "C" {
#endif

/**
 * @brief Digital polar-modulation SSB generator (Weaver/Hilbert-based),
 *        following the architecture used by QCX-SSB / uSDX (Guido PE1NNZ),
 *        adapted here as an original ESP-IDF implementation.
 *
 * Technique summary:
 *  - Audio is treated as the real part of an analytic signal. A Hilbert
 *    transform FIR filter produces the imaginary (quadrature) part.
 *  - Instantaneous phase = atan2(Q, I). The *change* in phase from one
 *    sample to the next is a frequency deviation: dphi/dt <-> delta-f.
 *  - Applying that frequency deviation to the carrier (by continuously
 *    retuning a DDS/synthesizer) phase-modulates the carrier in a way that
 *    reproduces one sideband and cancels the other - no analog quadrature
 *    mixers or crystal filter needed.
 *  - Instantaneous amplitude = sqrt(I^2 + Q^2). Applying that as the PA's
 *    supply-voltage envelope (EER / polar modulation) restores AM
 *    information that pure phase modulation of a class-C/D/E PA would
 *    otherwise discard.
 *
 * This module only computes the two output streams (frequency deviation in
 * Hz, and normalized envelope 0.0-1.0). It does not touch hardware directly:
 * the caller is expected to add the deviation to a carrier frequency and
 * push it to a synthesizer (e.g. ad9851_set_frequency()), and drive a PWM
 * channel from the envelope for PA supply modulation.
 */

typedef enum {
    SSB_SIDEBAND_USB = 0,
    SSB_SIDEBAND_LSB = 1,
} ssb_sideband_t;
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
