Rich5252/Arduino_ESP32_ssb_signal_generator/ssb_adc_filter.h

// ssb_adc_filter.h
// 2nd-order low-pass biquad(s) for ADC noise reduction - Butterworth
// (maximally flat) and Chebyshev Type I (steeper rolloff, at the cost of
// passband ripple), both built from the same RBJ-cookbook LPF formula with
// only Q changed - see ssb_adc_filter.c for the derivation.
//
// Two variants:
//  - ssb_biquad_t / ssb_biquad_process(): float, Direct Form II
//    Transposed. NOT SAFE IN ISR CONTEXT on Xtensa - float ops need the
//    FPU coprocessor, which has no register-save area for ISRs (trips a
//    CoprocessorException/Guru Meditation the moment it's used there;
//    confirmed the hard way). Fine to use from a FreeRTOS task.
//  - ssb_biquad_fixed_t / ssb_biquad_fixed_process(): Q15 fixed-point,
//    integer-only. Safe in ISR context - this is the one to call
//    directly from an adc_continuous on_conv_done() callback, which is
//    what lets the filter update every raw ADC sample (e.g. every
//    12.5us @ 80kHz) without adding per-tick draining cost to the
//    real-time task that reads its output.
//
// Both are initialized via the same RBJ-cookbook LPF formula (float math
// at init time only - that's fine, init happens from task context, e.g.
// inside setup()/init_adc(), never from an ISR).

#pragma once

#include <stdint.h>

#ifdef __cplusplus
extern "C" {
#endif

// ---- Float variant - task context only, NOT ISR-safe ----
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
