Rich5252/Arduino_ESP32_ssb_signal_generator/(commit log)

2026-08-06 PWM version
2026-08-07 First DAC and PWM hardware testing. 4725DAC not up to job, SDA just too slow. PWM very good with 2pole filter running at 20kHz Fs. No DDS hardware yet.
    Improve DSP mic test: perf, timing, PWM, diagnostics
    - Mark critical DSP functions with IRAM_ATTR for real-time perf
    - Add timing debug GPIO for DSP loop measurement
    - Increase sample rate to 20kHz; throttle DAC updates to 10kHz
    - Add optional PWM output path for envelope comparison
    - Update GPIOs and MCP4725 I2C address; revise wiring docs
    - Enhance MCP4725 error handling and startup diagnostics
    - Clamp envelope output to [0.2, 1.0] range
    - Refine serial output format for easier parsing
    - Add comments, clarify rationale, and improve robustn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
    [ssb_dsp.c, ssb_dsp.h, ssb_mic_test.ino]
2026-08-08 Pre audio tailoring
    Disable test features, improve timer precision
    TWOTONE_TEST_MODE and dac_task_enabled are set to 0 to disable test features. The sample timer resolution is increased to 2 MHz for better timing accuracy, with alarm count adjusted accordingly. dac_task creation is now conditional on dac_task_enabled. Diagnostic print interval in loop() is reduced from 200 ms to 20 ms for more frequent status updates.
2026-08-08 Key changes to reduce processing time in an attempt to reach 20kHz Fs including yet to be added AD9851 data transfers. ADC now continuous interrupt driven and oversampled/avgeraged. Trig functions no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
2026-08-09 Add LP filter on adc at 80kHz Fs
2026-08-09 Change to ADC FIFO and dsp filtering - working low noise but timings not ideal
    [ssb_adc_filter.c, ssb_adc_filter.h, ssb_mic_test.ino]
2026-08-09 Tuned the ADC Fs that is not exactly 80kHz. Adusted dsp sub-sampling to accomodate this. dsp sampling is exactly 20kHz in comparison.
2026-08-09 Adjust gain of AudioFx filters. Add gain up/down (+/-)
2026-08-10 Add AD9851 driver and add option to invert SPI pins (using inverting level shift to device.
    [AD9851.c, AD9851.h, ssb_mic_test.ino]
2026-08-12 Lots of test bench changes. Big update here was Bessel filter and tuning of levels and PW delay to reduce first IMD.
2026-08-13 Added group delay compensation filter
2026-08-13 Split out ino file into functional enties. Add "P" print settings cmd. Change presets for Butw & Bessel - 1,2 3
2026-08-15 Presets for Filter comparison data via m+pAnalyser
2026-08-15 Correct file names from copy/past drop in
    [ssb_mic_test.ino]
2026-08-15 Reorder and expand two-tone band presets
    Updated two-tone band presets in test_signals.cpp for consistent 200Hz spacing and improved cycling order; legacy wide pair kept last. Updated documentation and comments for clarity. Adjusted settingsPresets parameters in settings.h. Unified pointer style in function signatures. Made minor code style improvements throughout.
2026-08-15 Envelope drive distortion correction.
    [envelope_predistort.cpp, envelope_predistort.h, serial_commands.cpp, settings.h, ssb_mic_test.ino]
2026-08-16 Increase SPI to 4MHz from 2 to reduce 9851 write times. Didnt reduce writes as much as expected. Change time logger to gather more data.
2026-08-16 Bit Bang SPI drive for AD9851 - big win now down to 25us so whole Fs cpu utilisation ~45us per sample.
2026-08-16 16kHz Fs with updated GD filter etc.
2026-08-16 Added Chebyshev filter for ADC/Micr. select with f cmd. Both 2nd order.
2026-08-16 Tweak Micr to best for noise test (also need to switch on D)
    [settings.h]
2026-08-16 ADC filters increased to 4th order
2026-08-17 Add a slew rate test but now found a basic "bug" in dsp that we will try and fix first
    [serial_commands.cpp, settings.h, ssb_dsp.c, ssb_dsp.h, ssb_mic_test.ino]
2026-08-18 x4 Fs Env intropolate + new best so far micr noise input
    [envelope_interp.cpp, envelope_interp.h, serial_commands.cpp, settings.h, ssb_mic_test.ino]
2026-08-19 Tweak compress & equ values, switch on comp & equ in Preset0 Micr
2026-08-23 PWM duty cmds
2026-08-23 BIG WIN on V4 distortion table. Also tweaked "I" cmd response timing that didnt solve issue of no ON response (delayed until next off).
    [envelope_interp.cpp, envelope_interp.h, envelope_predistort.cpp, envelope_predistort.h, serial_commands.cpp]
2026-08-23 Fixed "I" message response by making message longer!!
    [envelope_interp.cpp, envelope_interp.h, serial_commands.cpp]
2026-08-23 Fixed messages - problem with 64 bytes are not sent (ESP bug?)
    [serial_commands.cpp]
2026-08-23 Back out attempt to reduce Fs clock jitter.
    [ssb_mic_test.ino]
2026-08-23 Added notes on attempt to reduce ADC Fs and gain cpu - failed as noise performance worse and no CPU gains
    [adc_capture.h, config.h]
2026-08-24 Added instrumentation to "L"ist tasks and additional timing. Had to move gpio3 to gpio13 as 3 output disrupped adc.
2026-08-24 Interrupt priority with good Pin5 timing jitter of only +/-0.5us
    [config.h, diagnostics.cpp, diagnostics.h, envelope_interp.h, envelope_output.cpp, ssb_mic_test.ino]
2026-08-25 Improved serial print out scheduling to ensure it does not cause interrupt delays.
2026-08-26 Change ADC filter to 2.8kHz from 3k
2026-08-30 V6 linearistaion Latest circuit adjustments to improve duty to gate voltage coverage. V6 envelope distortion tables.
2026-08-31 Two tone frequency stability and bias investigation. See .md for ref data to come back to this later. only diagnostic changes here no processing code changes.
    [config.h, diagnostics.cpp, serial_commands.cpp, ssb_dsp.c, ssb_dsp.h, ssb_mic_test.ino]
2026-09-01 Added "w" sine sweep test for env filter
2026-09-01 New group delay from TF of PWM filter. Add "C" interp options
2026-09-02 Add extra "C" state with no curve adapt to check overwriting to output noise.
    [envelope_interp.cpp, envelope_interp.h, serial_commands.cpp, ssb_mic_test.ino]
2026-09-02 Move pin13 to 39 to avoid adc breakthro noise. Add define to enable/disable ADC activity. Reduce interp factor to x1 (effectivily turning this off)
    [adc_capture.cpp, config.h, envelope_interp.h, serial_commands.cpp, settings.h, ssb_mic_test.ino, test_signals.h]
2026-09-03 Add envelope-path magnitude equalizer with biquad filter selected with "a" cmd. This compensates for the PWM analog filter roll off.
2026-09-04 Attempt2 on "a" filter with higher bndw.
2026-09-04 Added switch for shelf 1 or 2 ("a" env level comp)
2026-09-04 Add "A" to "P" print and preset recall
2026-09-04 gpdl latest fit to suit a+A shelf filters. Also corrected Preset2
    [envelope_gdeq.h, settings.h]
2026-09-05 Make #2 & #3 gdeq switchable g/G. Update Preset2 to my setting
2026-09-06 Fix G response msg too long.
    [envelope_gdeq.cpp, envelope_gdeq.h, serial_commands.cpp, ssb_mic_test.ino]
2026-09-07 Add project overview to README
    Document project objectives and methodology for SSB signal generator using ESP32-S3 and AD9851.
2026-09-07 Change diag printout priorities so we see AD9851 data.
2026-09-07 Add "V" cmd to print timing even when "v" off (no print)
2026-09-08 Change LEDC clock to 64k to match Fs x 4 and change back to 64k (ie x4).
2026-09-08 Attempt to use the PWM fade option - unsuccessful. See switches in envelope_interp.h. Reverted switches back to off, our current baseline.
    [envelope_interp.cpp, envelope_output.cpp, envelope_output.h, ssb_mic_test.ino]
2026-09-08 Tried SDM interface. Works better than expected but a dB or so worse and jitter still there.
    [config.h, envelope_interp.cpp, envelope_output.cpp, envelope_output.h, ssb_mic_test.ino]
2026-09-08 Revert back to working SDM with Distortion measurement capability.
    [envelope_output.cpp, envelope_output.h, serial_commands.cpp]
2026-09-08 Swap back to PWM
    [config.h]
2026-09-08 Correct dac enabled in error
    [config.h]
2026-09-11 Been adding lots of diags and also ad9851 SPI changes although back to fast spi here - see new compile option to slow this down
2026-09-12 Add dither on tone2 currently set to 0.05Hz, current 2tone set to 700/1900
2026-09-12 More diagnostics to track output freq shifts and attempt to identify root cause. New restart (reboot) cmd added - Z
    [config.h, diagnostics.cpp, diagnostics.h, relative_delay.cpp, relative_delay.h, serial_commands.cpp, ssb_dsp.c, ssb_dsp.h]
2026-09-17 Exact periodic tone generator code - jumping freq replaced by warble and higher noise floor. Further diag additions including "F" sample by sample dump.
    [diagnostics.cpp, diagnostics.h, serial_commands.cpp, test_signals.cpp]
2026-09-17 Add "O" cmd to revert to old tone gen.
    [serial_commands.cpp, ssb_mic_test.ino, test_signals.cpp, test_signals.h]
2026-09-18 Add 160 sample tone gen on "O" cmd
2026-09-18 Add separate mute ('M') for auto-dump diagnostics
    Added independent mute control ('M') for auto-dump diagnostic watchers, separate from periodic diagnostics mute ('v'). Introduced s_diag_autodump_muted flag with getter/toggle functions and documentation. diagnostics_service() now skips auto-dump watchers when muted. Handled 'M' command in serial_commands.cpp with confirmation message. Updated boot banner and documentation to clarify new behavior and caveats, including that detection is paused while muted.
    [diagnostics.cpp, diagnostics.h, serial_commands.cpp, ssb_mic_test.ino]
2026-09-19 MAJOR BREAKTHROUGH - ReSync of AD9851 writes into ISR. Big improvements on stability and noise floors. Also IMDs much more consistant etc as is the two tone freq stability.
    [carrier_output.cpp, carrier_output.h, config.h, diagnostics.cpp, diagnostics.h, ssb_mic_test.ino]
2026-09-19 Set micr filter back to 2800Hz
2026-09-20 V7 Distortion correction. Preset 5 Micr with latest best benchmark.
    [envelope_predistort.cpp, envelope_predistort.h, settings.h]
2026-09-21 Fix bug in ADC Fs resampler that failed after being in two tone mode for a while previously. Change to 64k ADC Fs
    [adc_capture.cpp, adc_capture.h, diagnostics.cpp, serial_commands.cpp]
2026-09-21 Add Soft Limit & ALC. Both work on env signal to limit peaks and apply a soft transition to max if needed.
    Re-apply 2800Hz LPF on micr
2026-09-23 Add 6 and 8 pole adc audio filters on "f" rotation. Add all cmd to ...commands.md
2026-09-23 Set adc lpf 2800Hz. ADC Fs 64000. EQ Presence +3dB
2026-09-25 Further failed compressor ideas
    [serial_commands.cpp, settings.h, ssb_dsp.c, ssb_dsp.h]
2026-09-25 Remove all failed attempts at tracking compressor. Replace by adding front end Micr dB gain control followed by fixed 3 segemnt log type compressor with variable compress rate.
    [config.h, envelope_floor.cpp, serial_commands.cpp, settings.h, ssb_dsp.c, ssb_dsp.h, ssb_mic_test.ino]
2026-09-26 Change Squelch so it only applies zero to modulation envelope so that hilbert continues to create low level noise output.
    [ssb_dsp.c, ssb_dsp.h]
